Latootoo/ECSE_548/README.md

ECSE_548
========

ECSE 548 Final Project - Group 2

TO-DO
========
- <del>Add row wl buffers to sram array</del> DONE!
- <del>Build layout for cache</del> DONE!
- <del>Integrate with MIPS in layout</del> DONE!
- <del>Finish final report</del> DONE!
- <del>Finish presentation slides</del> DONE!
