Latootoo/ECSE_548/Reports/Final_Report/report.tex

%% bare_conf.tex
%% V1.3
%% 2007/01/11
%% by Michael Shell
%% See:
%% http://www.michaelshell.org/
%% for current contact information.
%%
%% This is a skeleton file demonstrating the use of IEEEtran.cls
%% (requires IEEEtran.cls version 1.7 or later) with an IEEE conference paper.
%%
%% Support sites:
%% http://www.michaelshell.org/tex/ieeetran/
%% http://www.ctan.org/tex-archive/macros/latex/contrib/IEEEtran/
%% and
%% http://www.ieee.org/

%%*************************************************************************
%% Legal Notice:
%% This code is offered as-is without any warranty either expressed or
%% implied; without even the implied warranty of MERCHANTABILITY or
%% FITNESS FOR A PARTICULAR PURPOSE! 
%% User assumes all risk.
%% In no event shall IEEE or any contributor to this code be liable for
%% any damages or losses, including, but not limited to, incidental,
%% consequential, or any other damages, resulting from the use or misuse
%% of any information contained here.
%%
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
% the amount of white space around the subfigures. subfigure.sty is already
% installed on most LaTeX systems. The latest version and documentation can
% be obtained at:
% http://www.ctan.org/tex-archive/obsolete/macros/latex/contrib/subfigure/
% subfigure.sty has been superceeded by subfig.sty.

%\usepackage[caption=false]{caption}
%\usepackage[font=footnotesize]{subfig}
% subfig.sty, also written by Steven Douglas Cochran, is the modern
% replacement for subfigure.sty. However, subfig.sty requires and
% automatically loads Axel Sommerfeldt's caption.sty which will override
% IEEEtran.cls handling of captions and this will result in nonIEEE style
% figure/table captions. To prevent this problem, be sure and preload
% caption.sty with its "caption=false" package option. This is will preserve
% IEEEtran.cls handing of captions. Version 1.3 (2005/06/28) and later 
% (recommended due to many improvements over 1.2) of subfig.sty supports
% the caption=false option directly:
%\usepackage[caption=false,font=footnotesize]{subfig}
%
% The latest version and documentation can be obtained at:
% http://www.ctan.org/tex-archive/macros/latex/contrib/subfig/
% The latest version and documentation of caption.sty can be obtained at:
% http://www.ctan.org/tex-archive/macros/latex/contrib/caption/

% *** FLOAT PACKAGES ***
%
%\usepackage{fixltx2e}
% fixltx2e, the successor to the earlier fix2col.sty, was written by
% Frank Mittelbach and David Carlisle. This package corrects a few problems
% in the LaTeX2e kernel, the most notable of which is that in current
% LaTeX2e releases, the ordering of single and double column floats is not
% guaranteed to be preserved. Thus, an unpatched LaTeX2e can allow a
% single column figure to be placed prior to an earlier double column
% figure. The latest version and documentation can be found at:
% http://www.ctan.org/tex-archive/macros/latex/base/

%\usepackage{stfloats}
% stfloats.sty was written by Sigitas Tolusis. This package gives LaTeX2e
% the ability to do double column floats at the bottom of the page as well
% as the top. (e.g., "\begin{figure*}[!b]" is not normally possible in
% LaTeX2e). It also provides a command:
%\fnbelowfloat
% to enable the placement of footnotes below bottom floats (the standard
% LaTeX2e kernel puts them above bottom floats). This is an invasive package
% which rewrites many portions of the LaTeX2e float routines. It may not work
% with other packages that modify the LaTeX2e float routines. The latest
% version and documentation can be obtained at:
% http://www.ctan.org/tex-archive/macros/latex/contrib/sttools/
% Documentation is contained in the stfloats.sty comments as well as in the
% presfull.pdf file. Do not use the stfloats baselinefloat ability as IEEE
% does not allow \baselineskip to stretch. Authors submitting work to the
% IEEE should note that IEEE rarely uses double column equations and
% that authors should try to avoid such use. Do not be tempted to use the
% cuted.sty or midfloat.sty packages (also by Sigitas Tolusis) as IEEE does
% not format its papers in such ways.

% *** PDF, URL AND HYPERLINK PACKAGES ***
%
%\usepackage{url}
% url.sty was written by Donald Arseneau. It provides better support for
% handling and breaking URLs. url.sty is already installed on most LaTeX
% systems. The latest version can be obtained at:
% http://www.ctan.org/tex-archive/macros/latex/contrib/misc/
% Read the url.sty source comments for usage information. Basically,
% \url{my_url_here}.

% *** Do not adjust lengths that control margins, column widths, etc. ***
% *** Do not use packages that alter fonts (such as pslatex).         ***
% There should be no need to do such things with IEEEtran.cls V1.6 and later.
% (Unless specifically asked to do so by the journal or conference you plan
% to submit to, of course. )

% correct bad hyphenation here
%\hyphenation{op-tical net-works semi-conduc-tor}

\begin{document}
%
% paper title
% can use linebreaks \\ within to get better formatting as desired
\title{ECSE 548 (VLSI) Project: MIPS Processor On-Chip Cache Design and Integration}
\author{Group 2}

% author names and affiliations
% use a multiple column layout for up to three different
% affiliations
%\author{\IEEEauthorblockN{Michael Shell}
%\IEEEauthorblockA{School of Electrical and\\Computer Engineering\\
%Georgia Institute of Technology\\
%Atlanta, Georgia 30332--0250\\
%Email: http://www.michaelshell.org/contact.html}
%\and
%\IEEEauthorblockN{Homer Simpson}
%\IEEEauthorblockA{Twentieth Century Fox\\
%Springfield, USA\\
%Email: homer@thesimpsons.com}
%\and
%\IEEEauthorblockN{James Kirk\\ and Montgomery Scott}
%\IEEEauthorblockA{Starfleet Academy\\
%San Francisco, California 96678-2391\\
%Telephone: (800) 555--1212\\
%Fax: (888) 555--1212}}

% conference papers do not typically use \thanks and this command
% is locked out in conference mode. If really needed, such as for
% the acknowledgment of grants, issue a \IEEEoverridecommandlockouts
% after \documentclass

% for over three affiliations, or if they all won't fit within the width
% of the page, use this alternative format:
% 
%\author{\IEEEauthorblockN{Michael Shell\IEEEauthorrefmark{1},
%Homer Simpson\IEEEauthorrefmark{2},
%James Kirk\IEEEauthorrefmark{3}, 
%Montgomery Scott\IEEEauthorrefmark{3} and
%Eldon Tyrell\IEEEauthorrefmark{4}}
%\IEEEauthorblockA{\IEEEauthorrefmark{1}School of Electrical and Computer Engineering\\
%Georgia Institute of Technology,
%Atlanta, Georgia 30332--0250\\ Email: see http://www.michaelshell.org/contact.html}
%\IEEEauthorblockA{\IEEEauthorrefmark{2}Twentieth Century Fox, Springfield, USA\\
%Email: homer@thesimpsons.com}
%\IEEEauthorblockA{\IEEEauthorrefmark{3}Starfleet Academy, San Francisco, California 96678-2391\\
%Telephone: (800) 555--1212, Fax: (888) 555--1212}
%\IEEEauthorblockA{\IEEEauthorrefmark{4}Tyrell Inc., 123 Replicant Street, Los Angeles, California 90210--4321}}

% use for special paper notices
%\IEEEspecialpapernotice{(Invited Paper)}

% make the title area
\maketitle

\begin{abstract}
%\boldmath
In this paper, we present an on-chip cache design and integration for 8-bit MIPS
processor. The cache that we adopt is a direct-mapped cache with 1 byte cache
blocks. It has a size of 16 bytes and is used for both instructions and data. We
apply a top-down design methodology, i.e. we start from the architecture level
and go down to its layout, with testing on each level. To integrate the cache,
	MIPS Finite State Machine (FSM) is modified accordingly, which results in
	controller architecture modifications. Assembly code is also rewritten to test
	cache functionality by SystemVerilog simulation. Upon completing functionality verification, cache components are implemented and integrated in Electric, and then their testing methodology is explained in detail. In addition, design quality is tested using SPICE simulations.
\end{abstract}
% IEEEtran.cls defaults to using nonbold math in the Abstract.
% This preserves the distinction between vectors and scalars. However,
% if the conference you are submitting to favors bold math in the abstract,
% then you can use LaTeX's standard command \boldmath at the very start
% of the abstract to achieve this. Many IEEE journals/conferences frown on
% math in the abstract anyway.

% no keywords

% For peer review papers, you can put extra information on the cover
% page as needed:
% \ifCLASSOPTIONpeerreview
% \begin{center} \bfseries EDICS Category: 3-BBND \end{center}
% \fi
%
% For peerreview papers, this IEEEtran command inserts a page break and
% creates the second title. It will be ignored for other modes.
\IEEEpeerreviewmaketitle

\section{Introduction}

Cache is a small memory that is used to speed up the processor memory-related operation. Due to \textbf{Locality of Reference}, where a process at any given time accesses only a small region of memory, a cache helps significantly reduce processor I/O overhead by loading the small region that can be accessed by the processor with a much faster rate. For example, the typical memory access time of 60 ns of a Pentium processor can be reduced to 15 ns with the presence of a cache \cite{intel}. Usually data from memory as placed using \textit{modulo placement} policy, but other policies can also be applied, such as \textit{random placement} proposed in \cite{random_place}.

According to cache replacement policies, they can be classified as direct-mapped cache, set-associative cache, fully-associative cache, random cache \cite{random_replace} etc. In this paper, we propose a design for a simple direct-mapped cache for MIPS processor using SRAM memory elements. The paper is organized as follows. Section \ref{cache_arch} and Section \ref{arch} provides detailed descriptions of proposed design for cache architecture and modifications on the existing MIPS processor for the integration between the two parts; then Section \ref{implementation} presents the process of implementing the design. In Sections \ref{testing} and \ref{quality}, both functional and performance testing on the design is discussed. Section \ref{conclusion} concludes the design process.

%
% no \IEEEPARstart
% You must have at least 2 lines in the paragraph with the drop letter
% (should never be an issue)

%\hfill mds
% 
%\hfill January 11, 2007

% An example of a floating figure using the graphicx package.
% Note that \label must occur AFTER (or within) \caption.
% For figures, \caption should occur after the \includegraphics.
% Note that IEEEtran v1.7 and later has special internal code that
% is designed to preserve the operation of \label within \caption
% even when the captionsoff option is in effect. However, because
% of issues like this, it may be the safest practice to put all your
% \label just after \caption rather than within \caption{}.
%
% Reminder: the "draftcls" or "draftclsnofoot", not "draft", class
% option should be used if it is desired that the figures are to be
% displayed while in draft mode.
%
%\begin{figure}[!t]
%\centering
%\includegraphics[width=2.5in]{myfigure}
% where an .eps filename suffix will be assumed under latex, 
% and a .pdf suffix will be assumed for pdflatex; or what has been declared
% via \DeclareGraphicsExtensions.
%\caption{Simulation Results}
%\label{fig_sim}
%\end{figure}

% Note that IEEE typically puts floats only at the top, even when this
% results in a large percentage of a column being occupied by floats.

% An example of a double column floating figure using two subfigures.
% (The subfig.sty package must be loaded for this to work.)
% The subfigure \label commands are set within each subfloat command, the
% \label for the overall figure must come after \caption.
% \hfil must be used as a separator to get equal spacing.
% The subfigure.sty package works much the same way, except \subfigure is
% used instead of \subfloat.
%
%\begin{figure*}[!t]
%\centerline{\subfloat[Case I]\includegraphics[width=2.5in]{subfigcase1}%
%\label{fig_first_case}}
%\hfil
%\subfloat[Case II]{\includegraphics[width=2.5in]{subfigcase2}%
%\label{fig_second_case}}}
%\caption{Simulation results}
%\label{fig_sim}
%\end{figure*}
%
% Note that often IEEE papers with subfigures do not employ subfigure
% captions (using the optional argument to \subfloat), but instead will
% reference/describe all of them (a), (b), etc., within the main caption.

% An example of a floating table. Note that, for IEEE style tables, the 
% \caption command should come BEFORE the table. Table text will default to
% \footnotesize as IEEE normally uses this smaller font for tables.
% The \label must come after \caption as always.
%
%\begin{table}[!t]
%% increase table row spacing, adjust to taste
%\renewcommand{\arraystretch}{1.3}
% if using array.sty, it might be a good idea to tweak the value of
% \extrarowheight as needed to properly center the text within the cells
%\caption{An Example of a Table}
%\label{table_example}
%\centering
%% Some packages, such as MDW tools, offer better commands for making tables
%% than the plain LaTeX2e tabular which is used here.
%\begin{tabular}{|c||c|}
%\hline
%One & Two\\
%\hline
%Three & Four\\
%\hline
%\end{tabular}
%\end{table}

% Note that IEEE does not put floats in the very first column - or typically
% anywhere on the first page for that matter. Also, in-text middle ("here")
% positioning is not used. Most IEEE journals/conferences use top floats
% exclusively. Note that, LaTeX2e, unlike IEEE journals/conferences, places
% footnotes above bottom floats. This can be corrected via the \fnbelowfloat
% command of the stfloats package.

\section{Cache Architecture}\label{cache_arch}
The MIPS processor presented in the course takes an 8-bit address line and 8-bit data line every time it reads data from external memory; to maintain a manageable project scale while ensuring basic functionality of the cache, the cache was designed to split up the address line into a 4-bit tag line and a 4-bit set line, where set signals are used for row selection in cache whereas tag signals are used for comparison to generate cache hits. The designed configuration results in a 16 8-bit data row in cache, making it capable of storing 16 bytes (4 distinctive assembly instructions) for MIPS.

The resulting design of the cache is shown in Figure \ref{fig:cache_arch}. Set signals are used to decode data rows inside SRAM arrays, and tag signals are used to compare the tags stored in cache to generate cache hit signals. Write enable (\textit{we} as shown in figure) signal ensures the cache is writeable whenever it set to high. Additionally, for better stability, a validation bit (\textit{v}) was added to each row of SRAM array inside the cache to implement \textit{Compulsory Miss Strategy}, where the first read from cache is always guaranteed to generate a cache miss signal.

\begin{figure}[h!]
  \centering
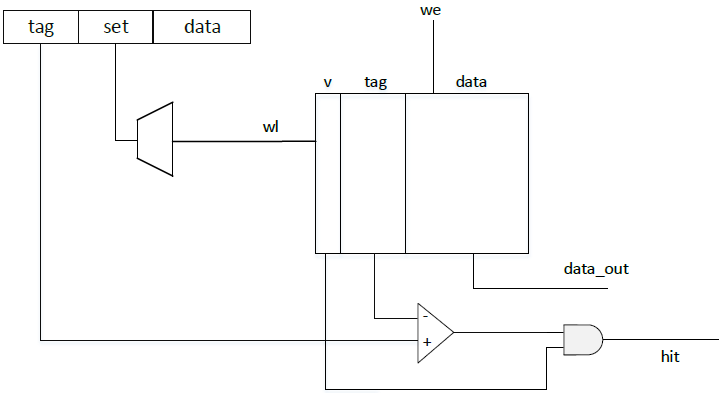
[picture p1: Reports/Final_Report/cache_arch.png]
    
  \caption{Cache Microarchitecture}
  \label{fig:cache_arch}
\end{figure}

\section{MIPS Integration Architecture}\label{arch}
Since our cache is used for both instructions and data, in following sections,
	  when we say data from memory, we refer to both instructions and data unless specified
	  otherwise.
	  
\subsection{Modified FSM}

\begin{figure}[h!]
  \centering
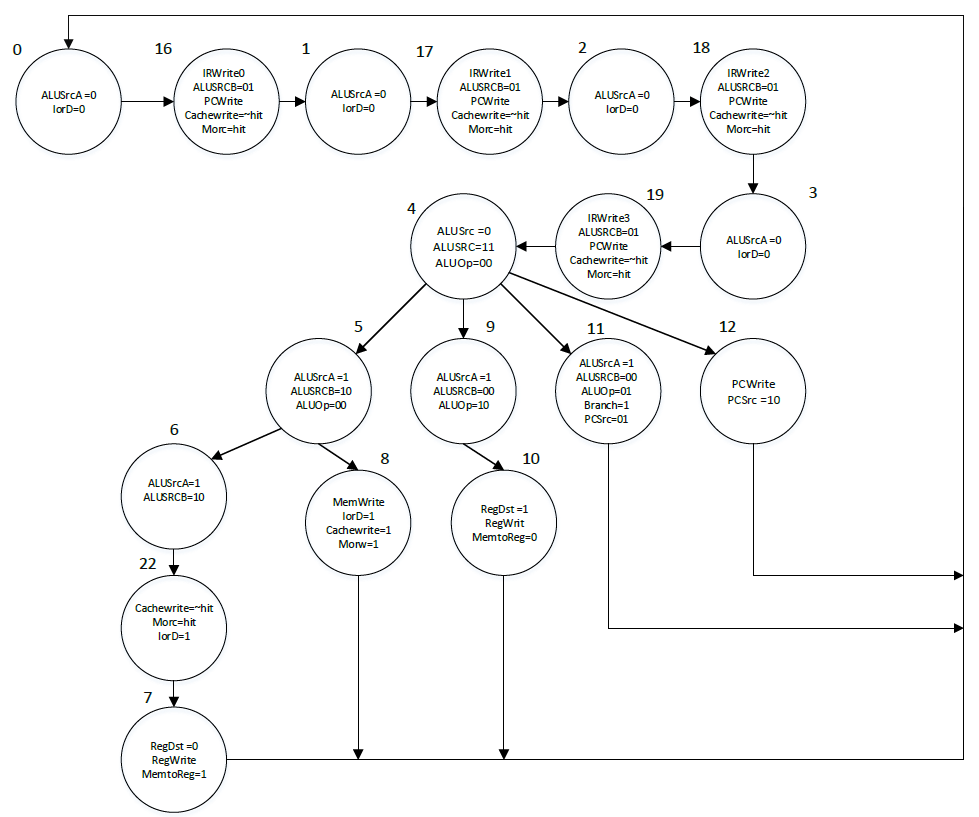
[picture p2: Reports/Final_Report/fsm.png]
    
  \caption{Modified FSM of Controller}
  \label{fig:fsm}
\end{figure}

We adopt hierarchical top-down design methodology. We go through architecture
level, schematic level and layout level. At architecture level, the Finite
State Machine (FSM) is modified and the controller is changed accordingly, see
Figure \ref{fig:fsm}. This is implemented in SystemVerilog and the functional simulation has
been verified successfully before going down to schematic level.

In Figure \ref{fig:fsm}, the modified FSM is similar to the original MIPS processor FSM. But in order to integrate our on-chip cache into the processor, we added some states for cache accesses and some signals to control additional multiplexers.

In total, we added 5 states. Previously, there are 13 states, i.e. from state 0 to state 12. We added an extra state bit and make it 5-bit FSM. The states we added are state 16 to state 19, and state 22 for cache read access. Besides, we modified state 8 for cache write access.

State 16 to state 19 are added for instruction fetch. Take state 0 as an example. Instead of fetching off-chip memory directly, first it checks the status of the cache at state 0. Then it goes to state 16. If there is a cache hit, the multiplexer selects instruction from cache and puts it into instruction register. Otherwise it reads the instruction from off-chip memory and at the same time, \textit{cachewrite} signal is enabled and corresponding multiplexer select signal is set to store the instruction to the cache simultaneously. 

For state 6, it reads data instead of instruction. It works in a similar way as it does for an instruction fetch. First it checks cache status at state 6 and then it reads data at state 22. Apart from \textit{cachewrite} signal and multiplexer select signal, the signal \textit{IorD} is set to 1 to read data.

For state 8, this is a memory write access. For memory write access, we still use only 1 state instead of 2. This is because we have chosen write-through policy for cache, which means whenever a write access happens, the data is written back to both cache and off-chip memory simultaneously. Therefore there is no need to add an extra state. To write data into cache, we need to enable \textit{cachewrite} signal and select the data from datapath using the multiplexer. 

\subsection{MIPS Microarchitecture}
\begin{figure}[h!]
  \centering
    
  \caption{MIPS Microarchitecture}
  \label{fig:arch}
\end{figure}

The MIPS microarchitecture with on-chip cache is shown in Figure~\ref{fig:arch}. In Figure \ref{fig:arch}, we can see that our cache is integrated. To make it work. two additional multiplexers are added. Besides, three output signals (\textit{cachewrite, morw, morc}) and one input signal
(\textit{hit}) are added to the controller due to modified FSM, and they are explained as follows: 

\begin{itemize}
\item\textit{cachewrite} is used to
enable write/read access to the cache with a value of 1/0. 

\item\textit{morw} is used
to select data from memory or datapath. For a read access, if a cache miss happens, it is set
to 0 and the data from memory is written into the cache. For a write access, it is set to 1 to send the datapath data to cache.

\item\textit{morc} is used to select data from memory or from cache. If there is a
cache hit, it is set to 1 and the data from cache is sent to MIPS. Otherwise it
is set to 0 and memory data is used.

\item\textit{hit} is used to show status of cache. 1 represents a cache hit and
0 represents a cache miss. A compulsory miss strategy was implemented for an ensured miss for a first-time read from cache.
\end{itemize}

\section{Implementaion}\label{implementation}
This section discusses the implementation process of cache components and integration in Electric.
\subsection{Comparator}\label{subsec:comparator}
A 4-bit comparator was implemented to compare the \textit{tag} bits from the memory and cache to generate corresponding \textit{cache hit} signals. The designed schematic and layout can be found in Figure \ref{fig:comparator}.
\begin{figure}[h!]
  \centering
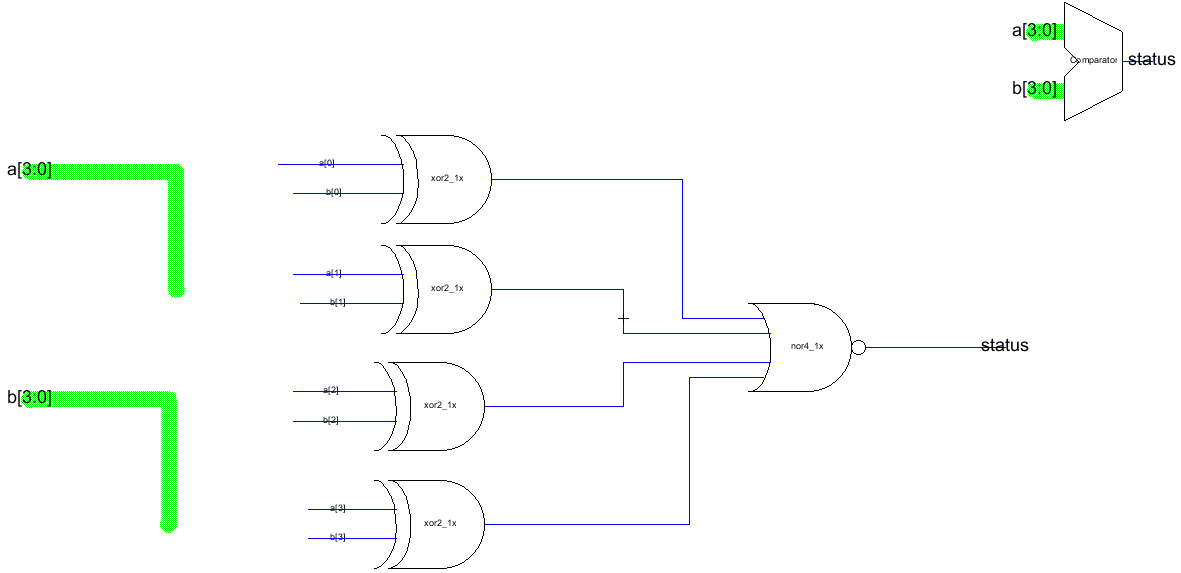
[picture p3: Reports/Final_Report/comparator_sch.png]
     
  \caption{The Schematic and Layout of Comparator Design}
  \label{fig:comparator}
\end{figure}

Figure \ref{fig:comparator_check} indicates that the comparator design was valid, passing all three design rule checks.
\begin{figure}[h!]
  \centering
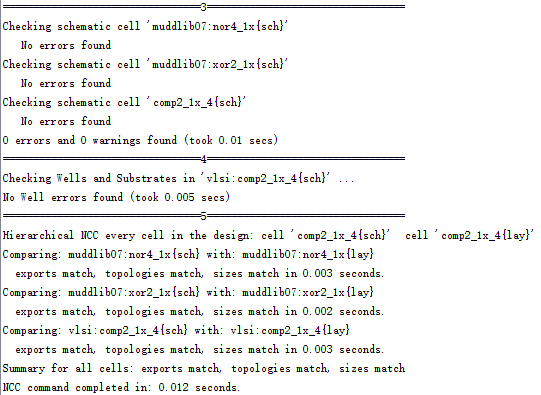
[picture p4: Reports/Final_Report/comparator_check.png]
    
  \caption{Deisgn Rule Checks for Comparator}
  \label{fig:comparator_check}
\end{figure}

\subsection{4-to-16 Row Decoder}\label{subsec:decoder}
In order for the cache to make use of the 4-bit set signals, a row decoder was applied to decode the set signal and select 1 out of 16 8-bit data lines lying inside the cache. In order to reduce the delay and space usage of the decoder, \textit{pre-decoding} technology was used, resulting in a design shown in Figure \ref{fig:decoder}. It was worth noting that the layout of the decoder was deliberately designed to be wide with a minimum height in order to pitch-match with the SRAM array inside the cache.
\begin{figure}[h!]
  \centering
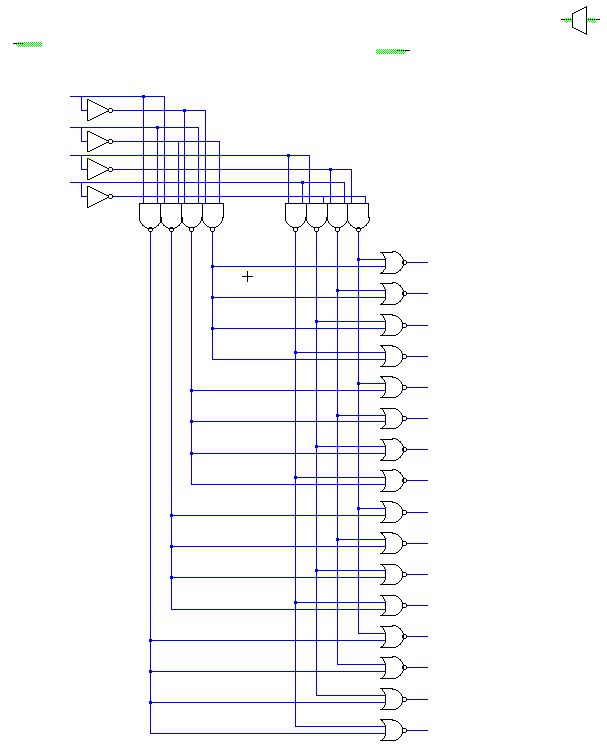
[picture p5: Reports/Final_Report/decoder_sch.png]
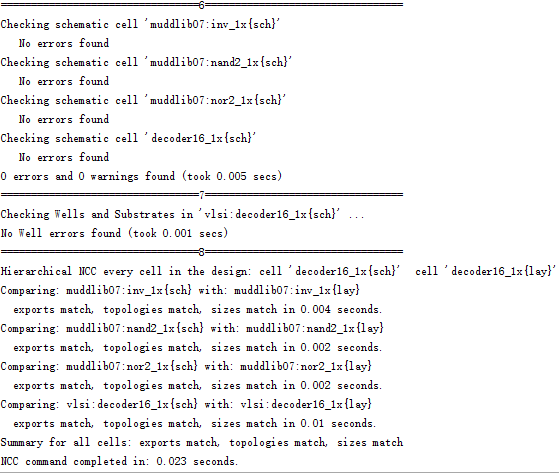
[picture p6: Reports/Final_Report/decoder_check.png]
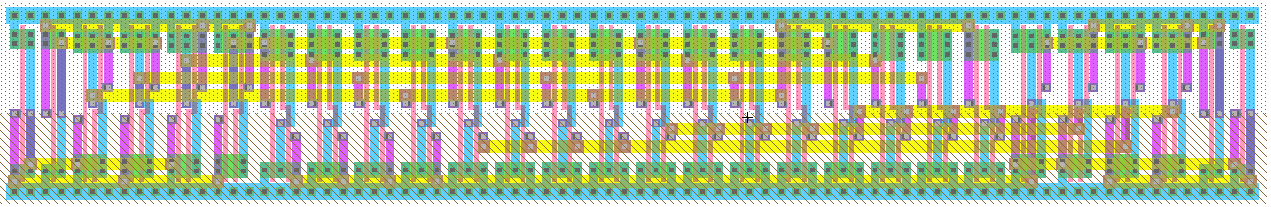
[picture p7: Reports/Final_Report/decoder_lay.png]
      
  \caption{The Schematic and Layout of Decoder Design With Design Rule Check Results}
  \label{fig:decoder}
\end{figure}

It can be shown from the Figure \ref{fig:decoder} that the decoder design passed all three design rule checks and was ready for the integration into the cache deisgn.

\subsection{SRAM Column}\label{subsec:sram_col}
An SRAM column represents a column of SRAM bits inside the SRAM array of the cache, consisting of 16 SRAM bits sharing bit and inverting bit lines. The design was presented in Figure \ref{fig:sram_col}.

\begin{figure}[h!]
  \centering
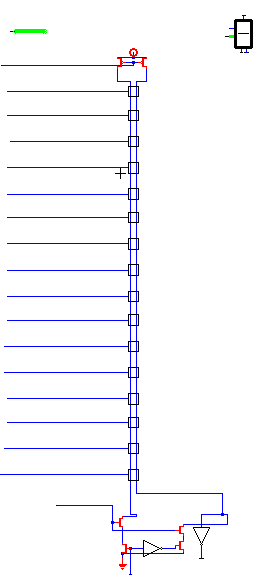
[picture p8: Reports/Final_Report/sram_col_sch.png]
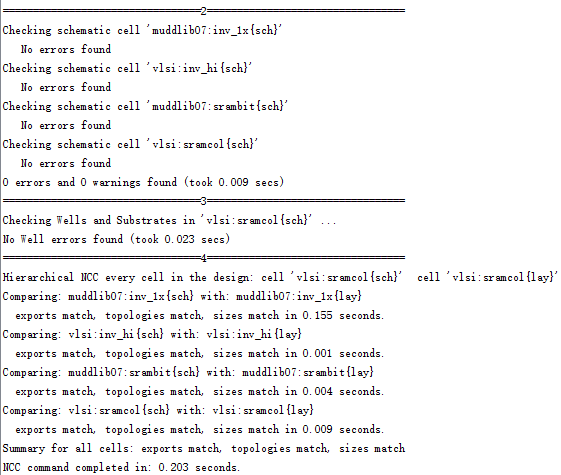
[picture p9: Reports/Final_Report/sram_col_check.png]
      
  \caption{The Schematic and Layout of SRAM Column With Design Rule Check Results}
  \label{fig:sram_col}
\end{figure}

The design rule check results can be found in Figure \ref{fig:sram_col}. It can be shown from the Figure that all three of the design rule requirements were satisfied by the design.

\subsection{SRAM Array}\label{subsec:sram}
The SRAM array is the most essential part of the cache, consisting of 16 \textit{13-bit} SRAM bit rows, with each row having 1 bit for validation (compulsory miss), 4 bits for tag line and 8 bits for data storage. Each row also has a wordline buffer for a stable charging-up. The design is presented in Figure \ref{fig:sram}; the design rule check results can be found in the same figure as well.

\begin{figure}[h!]
  \centering
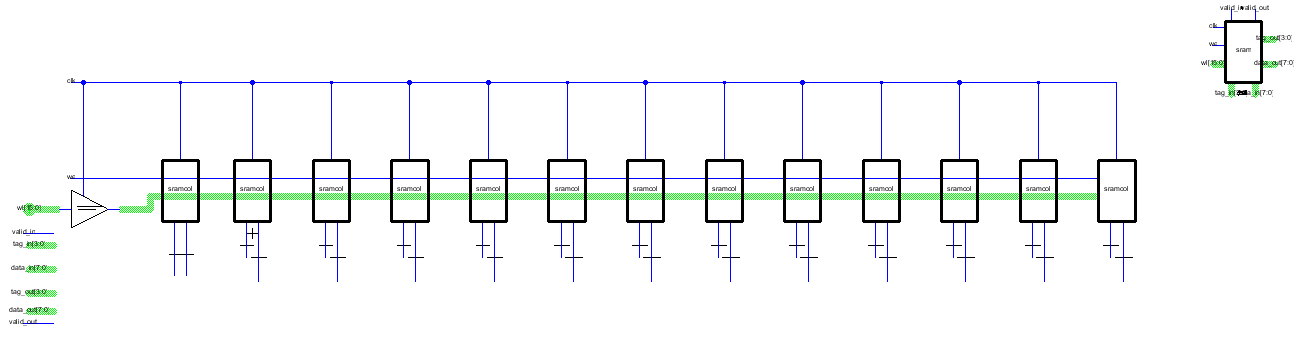
[picture p10: Reports/Final_Report/sram_sch.png]
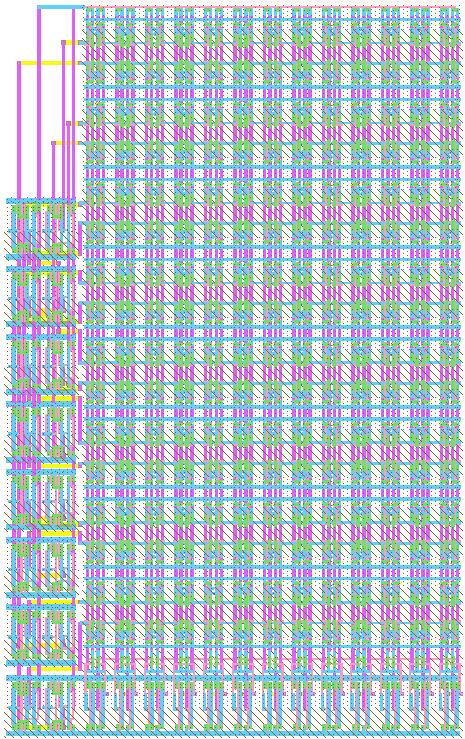
[picture p11: Reports/Final_Report/sram_lay.png]
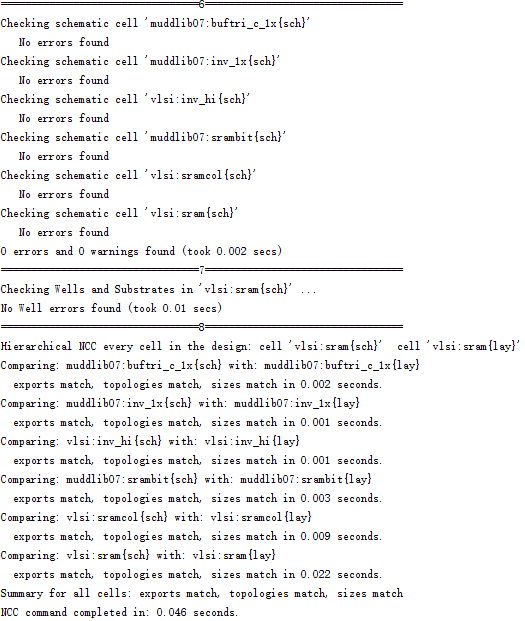
[picture p12: Reports/Final_Report/sram_check.png]
      
  \caption{The Schematic and Layout of SRAM Array With Design Rule Check Results}
  \label{fig:sram}
\end{figure}

\subsection{Cache}\label{subsec:cache}
After the implementation of all circuit components, the cache was built based on the microarchitecture of the proposed cache circuit design. For easy integrations with the MIPS processor, in the layout, universal \textit{vdd} and \textit{gnd} tracks were added that connects \textit{vdd} and \textit{gnd} of sub-components together. The cache circuit design, along with the evidence that it passes all three design checks, is presented in Figure \ref{fig:cache}.

\begin{figure}[h!]
  \centering
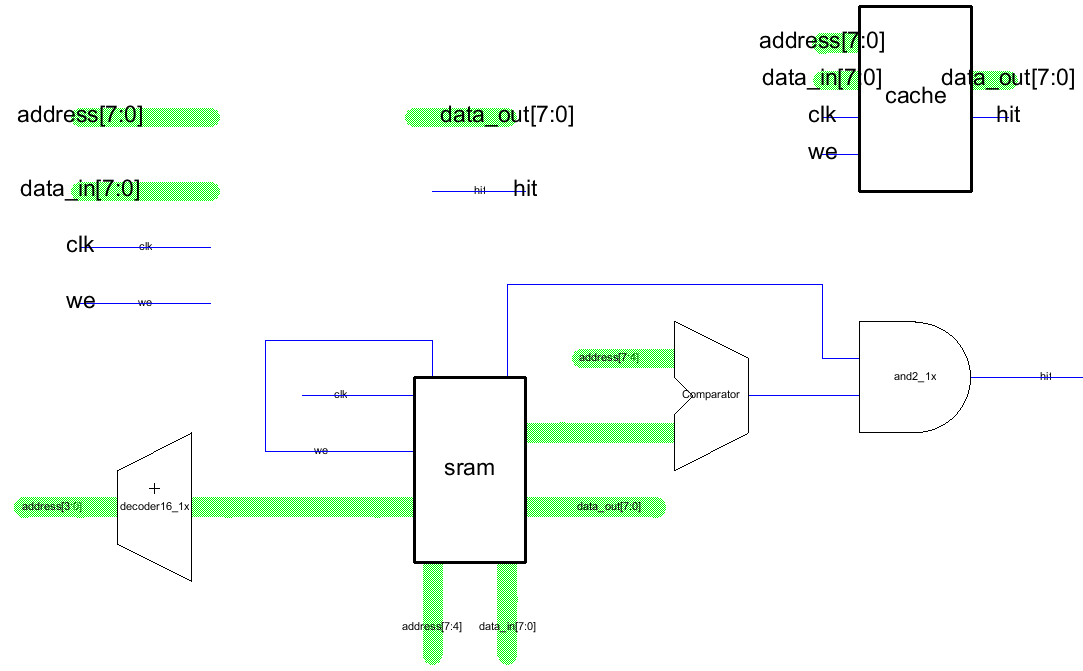
[picture p13: Reports/Final_Report/cache_sch.png]
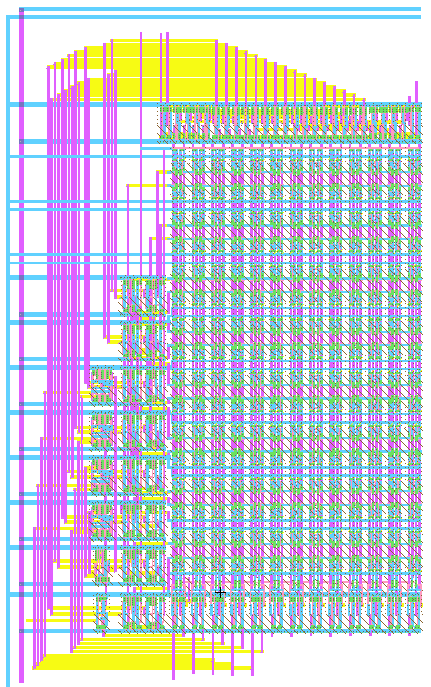
[picture p14: Reports/Final_Report/cache_lay.png]
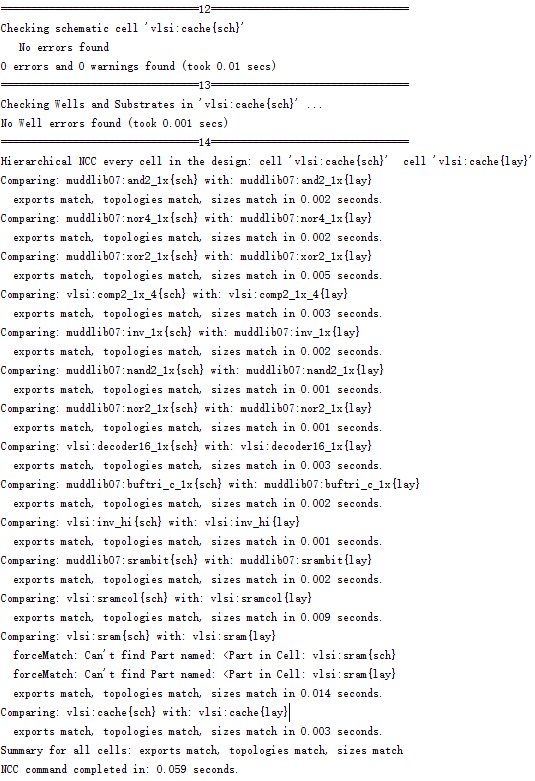
[picture p15: Reports/Final_Report/cache_check.png]
      
  \caption{The Schematic and Layout of Cache With Design Rule Check Results}
  \label{fig:cache}
\end{figure}

\subsection{PLA Controller \& Controller}\label{subsec:controller}
As indicated in Section \ref{arch}, with updated FSM for the controller, the PLA controller which represents the FSM logic has been modified accordingly. With an updated FSM description file, a new PLA controller was generated and re-integrated into the controller circuit of MIPS processor. New exports corresponding to cache signals have been added to the controller circuit as well. The resulting circuit is presented in the next sub-section.

\subsection{Integration}\label{subsec:integration}
Upon the completion and tests of each component, the cache was then integrated with MIPS processor (with updated controller component), resulting in a circuit presented in Figure \ref{fig:mips}.

\begin{figure}[h!]
  \centering
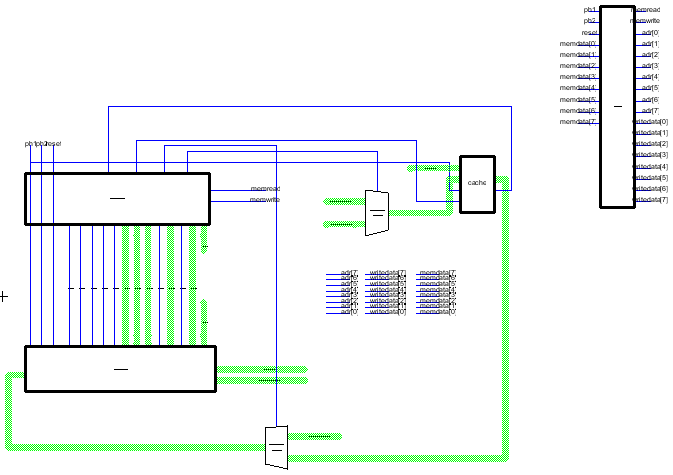
[picture p16: Reports/Final_Report/mips_sch.png]
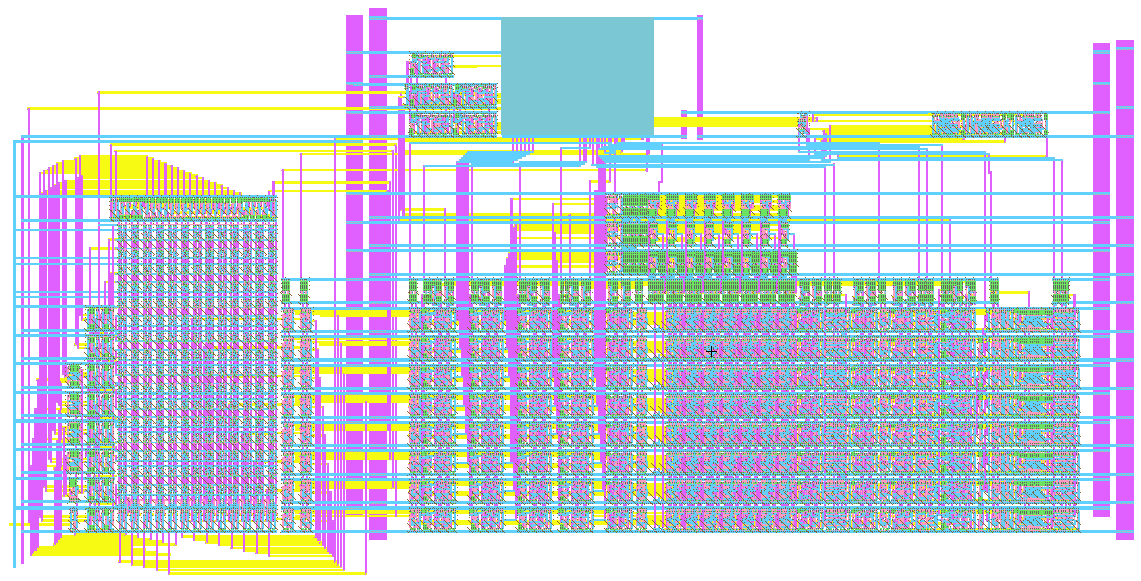
[picture p17: Reports/Final_Report/mips_lay.png]
     
  \caption{The Schematic and Layout of MIPS integrated with Cache}
  \label{fig:mips}
\end{figure}

The pad frame was then generated from the new MIPS processor with cache implemented. To contain the much-expanded size of the MIPS, the size of the pad frame was extended from \textit{40} pads to \textit{64} pads. The resulting chip, along with error-free design rule check results, is shown in Figure \ref{fig:chip}. Due to page limits, a truncated version of design rule checks for the chip is presented in this paper; the full check has been presented during the demo with the professor.

\begin{figure}[h!]
  \centering
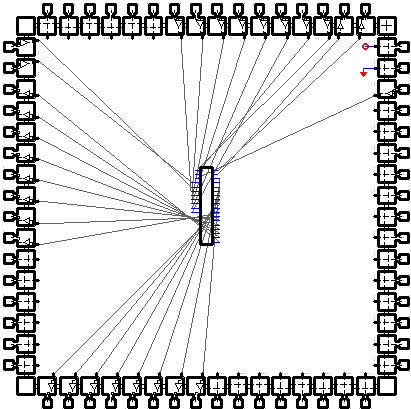
[picture p18: Reports/Final_Report/chip_sch.png]
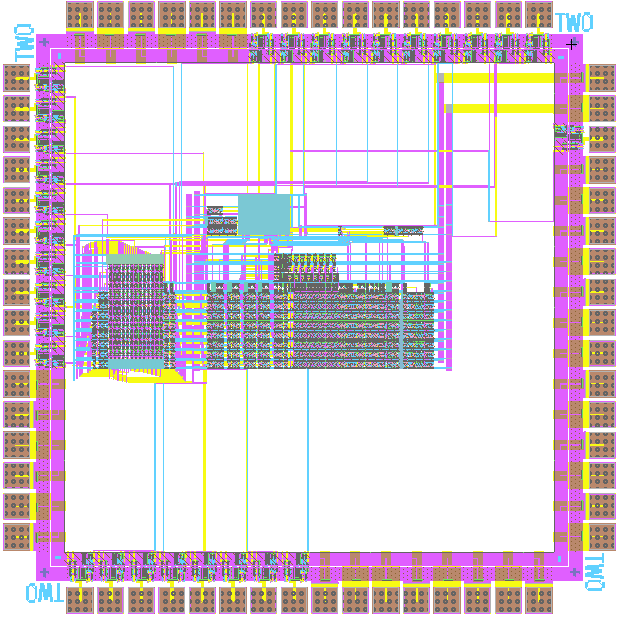
[picture p19: Reports/Final_Report/chip_lay.png]
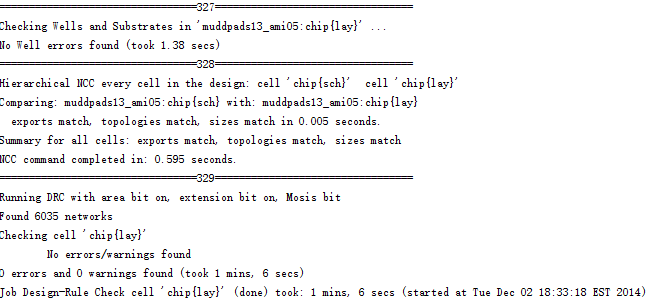
[picture p20: Reports/Final_Report/chip_check.png]
      
  \caption{The Schematic and Layout of Chip Integration With Design Rule Check Results}
  \label{fig:chip}
\end{figure}

\section{Testing}\label{testing}
In this section, we explain our testing methodology. We tested components
individually in Section \ref{subsec:comp_test}. After assembly, the SystemVerilog MIPS
processor is simulated for functional testing in Section \ref{subsec:func_test}.

\subsection{Components Testing}\label{subsec:comp_test}
The main components to be tested are shown below:
\begin{itemize}
\item Comparator \\

The comparator was tested in ModelSim with 7 test cases; Figure \ref{fig:comp_test} indicates that the comparator was able to operate correctly, passing all test cases.

\begin{figure}[h!]
  \centering
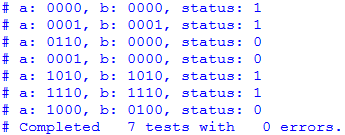
[picture p21: Reports/Final_Report/comp_test.png]
    
  \caption{ModelSim Test Results for Comparator}
  \label{fig:comp_test}
\end{figure}

\item Decoder \\
The 4-to-16 decoder was tested in ModelSim with all 16 test cases; the results showing that the design was operating properly is presented in Figure \ref{fig:decoder_test}.

\begin{figure}[h!]
  \centering
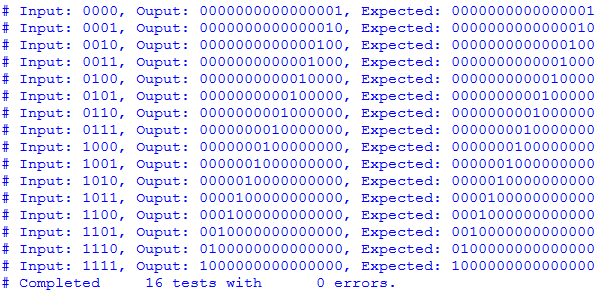
[picture p22: Reports/Final_Report/decoder_test.png]
    
  \caption{ModelSim Test Results for decoder}
  \label{fig:decoder_test}
\end{figure}
 
\item SRAM \\

This is the storage elements in cache. As shown in Figure \ref{fig:cache_arch}, it has 16 sets and each set consists of 1 \textit{valid} bit, 4 \textit{tag} bits and 8 \textit{data} bits. The input signal \textit{we} is set to 0/1 for data read/write and the signal \textit{wl} is used to select the set for access. Initially, the \textit{valid} bit is 0. Once a cache set is written, its corresponding \textit{valid} becomes 1. \textit{valid} is used to indicate if the data has been loaded or not. We produce some random inputs for testing. Due to the complexity of memory accesses, we generate test vectors from the inputs using our \textit{Python} script, as shown in Figure \ref{fig:sram_test}. The signal representation is listed in Table \ref{table:sram}. The functionality of SRAM is verified successfully according to test vectors.

\begin{figure}[h!]
  \centering
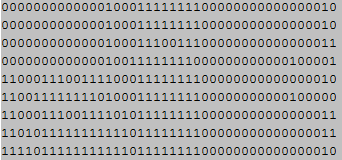
[picture p23: Reports/Final_Report/sram_test.png]
    
  \caption{SRAM Test Vectors}
  \label{fig:sram_test}
\end{figure}

\begin{table}[h]
\centering
\caption{SRAM Test Vector Representation}
\label{table:sram}
\begin{tabular}{c|c}
  \hline
  \textbf{bit position} & \textbf{signal}\\  
  \hline
  0 & we\\
  16:1 & wl \\
  24:17 & data\_in\\
  28:25 & tag\_in\\
  36:29 & expected\_data\\
  40:37 & expected\_tag\\
  41 & expected\_valid\\
  \hline
\end{tabular}
\end{table}

\end{itemize}

\subsection{Functional Testing}\label{subsec:func_test}
In this section, the functional testing of MIPS SystemVerilog model is
demonstrated. For this purpose, assembly code is written, as shown in Listing
\ref{lst:asm}. The assembly code load data from off-chip main memory, and some arithmetic manipulations are done. Then the result is written back to the main memory.

\lstinputlisting[caption=Assembly Code, label=lst:asm]{test.s}
At the beginning, instructions are fetched, and there are compulsory cache misses. The assembly code contains a loop to test cache hits. When dealing with this loop, there are cache hits. In Figure \ref{fig:cache_miss}, we can see that there is a cache miss. This happens because the instructions are used for the first time here. During program execution, cache hits occur for the loop. This is illustrated in Figure \ref{fig:cache_hit}. The instructions in the loop are put in the cache and then fetched soon. As a result, cache hits happen here.

Apart from cache read access, we also checked cache write access, as shown in Figure \ref{fig:cache_write}. In this case, signal \textit{morw} is set to 1 to select data and \textit{cachewrite} is set to 1 to write the data from datapath into cache.

\begin{figure}[h!]
  \centering
    
  \caption{Cache Read Miss}
  \label{fig:cache_miss}
\end{figure}

\begin{figure}[h!]
  \centering
    
  \caption{Cache Read Hit}
  \label{fig:cache_hit}
\end{figure}

\begin{figure}[h!]
  \centering
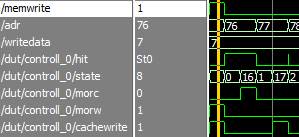
[picture p24: Reports/Final_Report/cache_write.png]
    
  \caption{Cache Write}
  \label{fig:cache_write}
\end{figure}

The functionality verification result is shown in Figure \ref{fig:cache_write}. If cache is absent, the write address \textit{adr} is 76 and write data \textit{writedata} is 7. After we integrated on-chip cache, the result is still correct. Our cache functionality is thus verified.

\section{Design Quality}\label{quality}
 
% power: and=> 1.89E-05  WATTS
%        inv=> 2.22E-05  WATTS
%		 hi-inv=>  1.27E-05  WATTS

In this section, performances of certain components, such as regular inverter, high-skew inverter as well as and gate, are evaluated using CAD tool(i.e.PSPICE) since we are not capable to perform evaluations directly on integrated circuits blocks due to the circuit size limitation from CAD tool. The corresponding results are shown in Figure \ref{fig:Spice} for the setup time analysis of each component respectively. As can be seen clearly from the output waveform, the high-skew inverter pulls up faster than the regular inverter as expected. As for the power dissipation, the corresponding total power consumption of a and gate, inverter and high-skew inverter are $18.9\mu W$, $22.2\mu W$ and $12.7\mu W$, respectively. Therefore, skewed logic is clearly one of the high performance and low power-carry logic components available currently.

\begin{figure}[h!]
  \centering
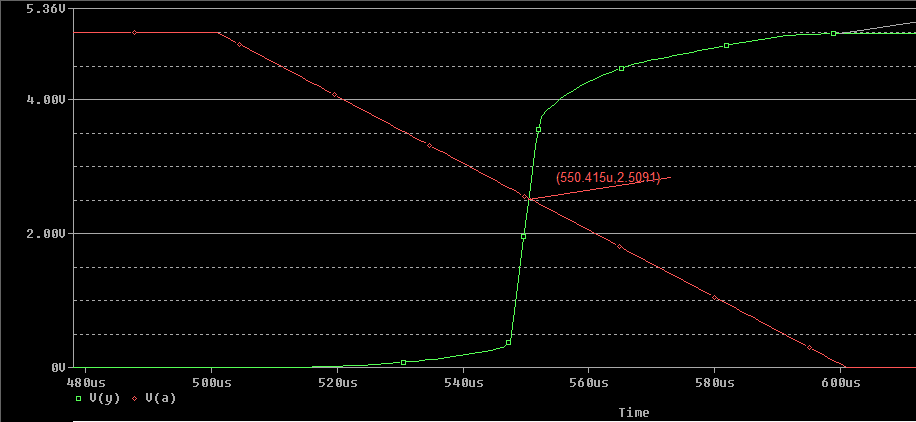
[picture p25: Reports/Final_Report/inv.png]
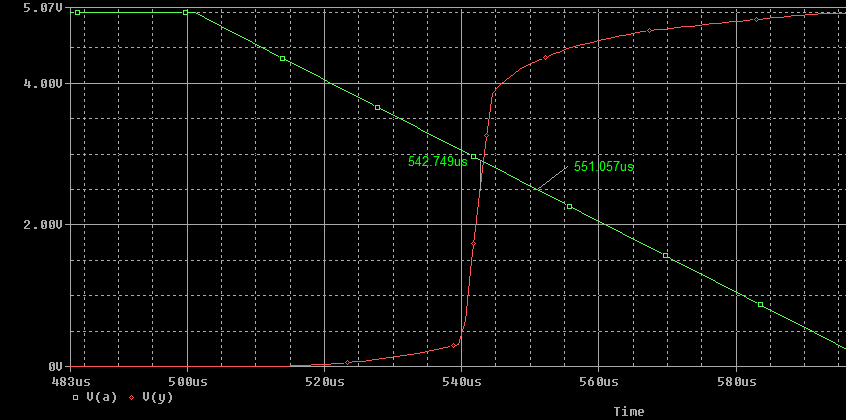
[picture p26: Reports/Final_Report/hi.png]
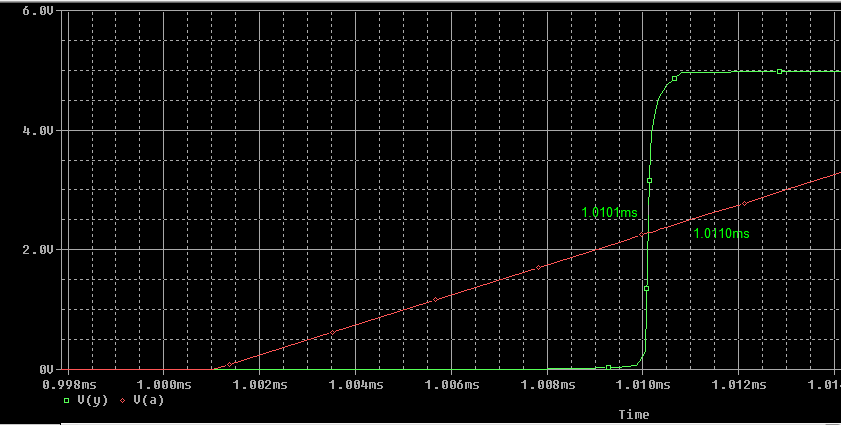
[picture p27: Reports/Final_Report/and.png]
      
  \caption{SPICE simulation of INV, high-skew INV and AND gate}
  \label{fig:Spice}
\end{figure}

\section{Conclusion}\label{conclusion}
Cache can be implemented in a number of ways. By using different placement and replacement policies, there are different access time and design complexities. In this paper, we successfully designed a direct-mapped cache--which is simple but demonstrates working principles of a cache--for an 8-bit MIPS processor. It is then implemented as schematic and layout respectively in Electric, and DRC, ERC and NCC tests all passed. In addition, we integrated the cache into the processor by modifying the controller FSM and verified the functionality by SystemVerilog testbench in ModelSim. Finally, we employed SPICE simulation for design quality test. Thus we have finished the project successfully by applying our knowledge from VLSI course and processor cache.

% conference papers do not normally have an appendix

% use section* for acknowledgement
%\section*{Acknowledgment}
%
%
%The authors would like to thank...

% trigger a \newpage just before the given reference
% number - used to balance the columns on the last page
% adjust value as needed - may need to be readjusted if
% the document is modified later
%\IEEEtriggeratref{8}
% The "triggered" command can be changed if desired:
%\IEEEtriggercmd{\enlargethispage{-5in}}

% references section

% can use a bibliography generated by BibTeX as a .bbl file
% BibTeX documentation can be easily obtained at:
% http://www.ctan.org/tex-archive/biblio/bibtex/contrib/doc/
% The IEEEtran BibTeX style support page is at:
% http://www.michaelshell.org/tex/ieeetran/bibtex/
%\bibliographystyle{IEEEtran}
% argument is your BibTeX string definitions and bibliography database(s)
%\bibliography{IEEEabrv,../bib/paper}
%
% <OR> manually copy in the resultant .bbl file
% set second argument of \begin to the number of references
% (used to reserve space for the reference number labels box)
\begin{thebibliography}{1}

\bibitem{intel}http://download.intel.com/design/intarch/papers/cache6.pdf

\bibitem{random_place}Kosmidis L, Abella J, Qui˜nones E, Cazorla FJ (2013a) A cache design for probabilistically
analysable real-time systems. In: Proceedings of the Conference on Design, Automation
and Test in Europe, EDA Consortium, San Jose, CA, USA, DATE ’13, pp 513–518, URL
http://dl.acm.org/citation.cfm?id=2485288.2485416

\bibitem{random_replace}Quinones E, Berger E, Bernat G, Cazorla F (2009) Using randomized caches in probabilistic
real-time systems. In: Real-Time Systems, 2009. ECRTS ’09. 21st Euromicro Conference
on, pp 129–138, DOI 10.1109/ECRTS.2009.30

\end{thebibliography}

% that's all folks
\end{document}
