Latootoo/ECSE_548/Reports/Final_Report/cache_arch.pdf

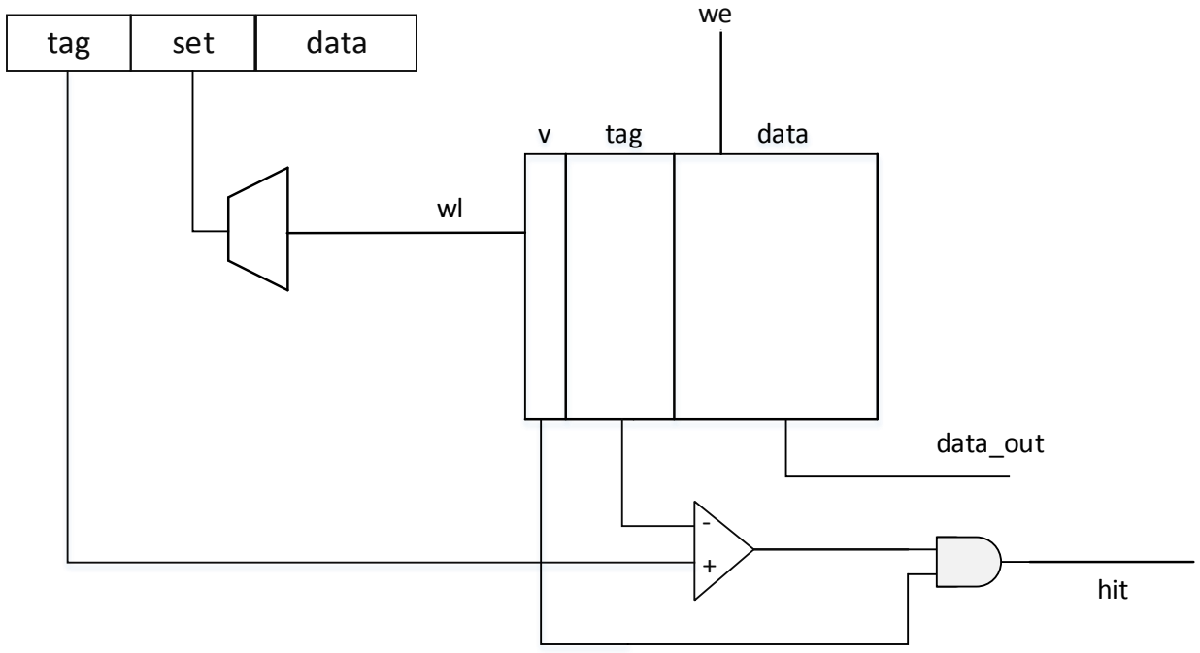
[picture p40: figure]
data_out; tag; data; hit; set
