Latootoo/ECSE_548/Reports/Final_Report/arch.pdf

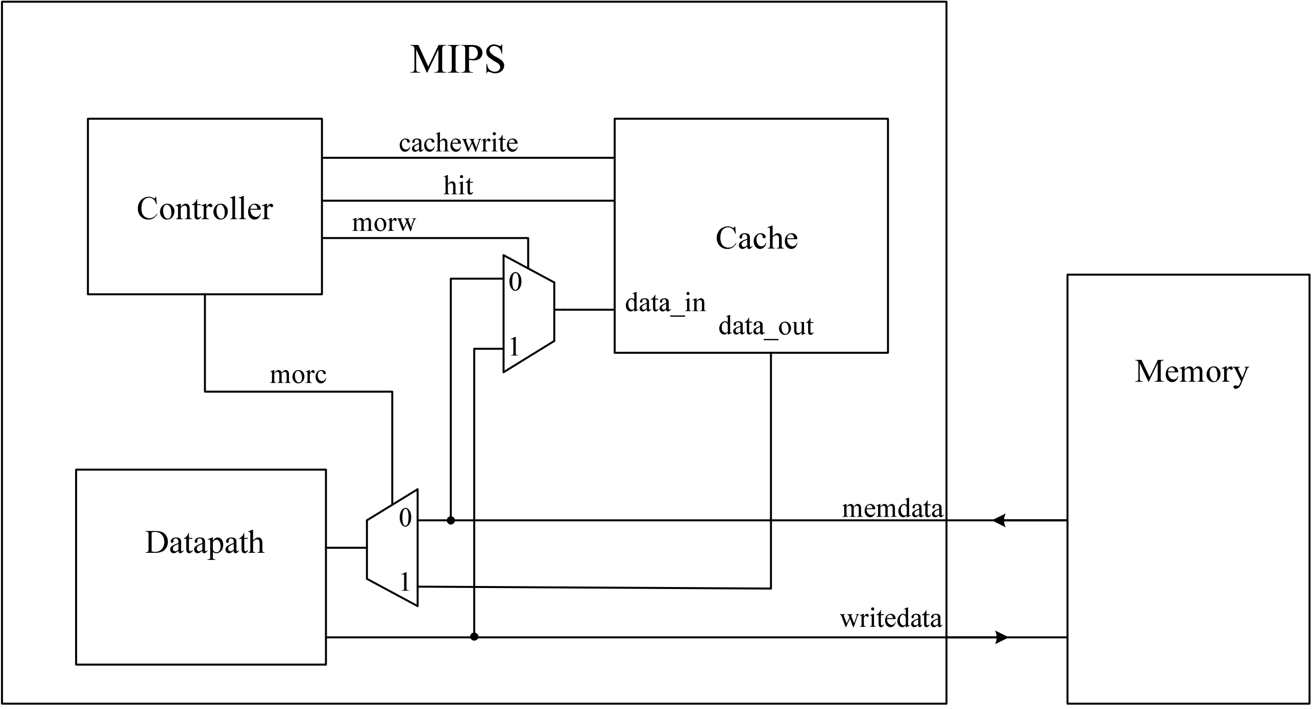
[picture p41: figure]
