Latootoo/ECSE_548/Reports/Final_Report/pla_case.png

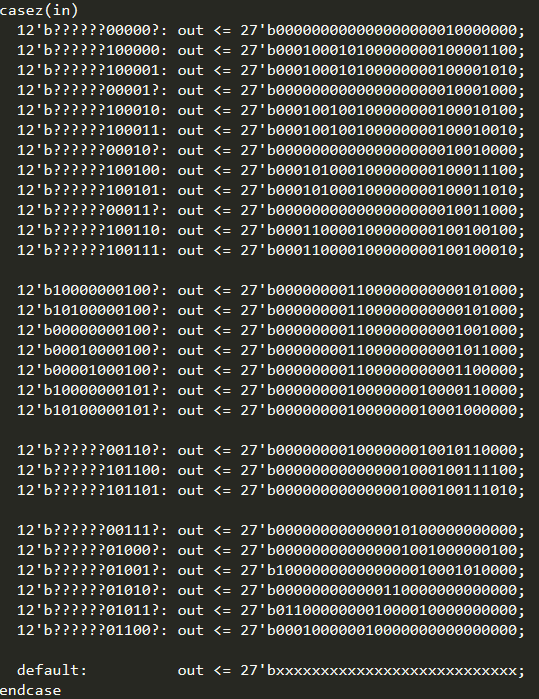
Reports/Final_Report/pla_case.png
