Latootoo/ECSE_548/Reports/Final_Report/pla_lay.png

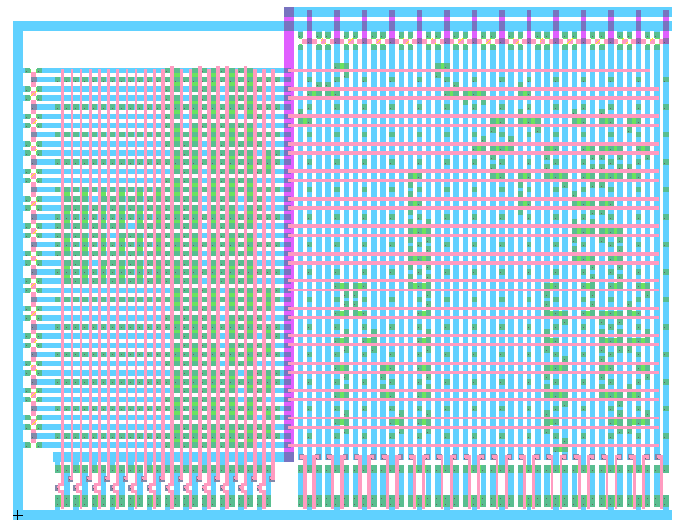
Reports/Final_Report/pla_lay.png
