Latootoo/ECSE_548/Testing/cache/test-vectors.txt

0xxxxxxxx00000001100000000
0xxxxxxxx00000001100000001
10000000100000001100000000
10000000100000110100000001
10000011000000110100000000
00000011000011110011000001
00001111000011110100000000
10001111000011110011000000
