Latootoo/ECSE_548/Testing/sram/test-in.txt

10001111111100000000000000010
10001111111100000000000000010
10001110011100000000000000011
10011111111000000000000100001
10001111111100000000000000010
10001111111100000000000100000
10101111111100000000000000011
11101111111100000000000000011
11101111111100000000000000010
