Latootoo/ECSE_548/Testing/controller_pla/parameters.txt

cellName controller_pla
electricVersion 8.04
m2Width 4
m1Width 4
polyWidth 2
activeWidth 4
weakActiveWidth 3
weakPolyWidth 3
powerAndGndWide 8
m2ToM2Dist 4
m1ToM1Dist 4
polyToPolyDist 3
polyToDiffusionDist 1
weakTransistorToActiveConnection 2
weakTransistorSize 3
wellSurround 6
transistorToActiveConnection 1
nMosInvWidth 5
