Latootoo/ECSE_548/Testing/controller_pla/controller_pla_Cell.v

/* Verilog for cell 'controller_pla_Cell{sch}' from library 'controller_pla' */
/* Created on 星期日 三月 04, 2007 21:40:06 */
/* Last revised on 星期一 十一月 17, 2014 16:41:30 */
/* Written on 星期一 十一月 17, 2014 16:46:19 by Electric VLSI Design System, version 8.06 */

module controller_pla_Cell(in, in_1, in_10, in_11, in_2, in_3, in_4, in_5, 
      in_6, in_7, in_8, in_9, out, out_1, out_10, out_11, out_12, out_13, 
      out_14, out_15, out_16, out_17, out_18, out_19, out_2, out_20, out_21, 
      out_22, out_23, out_24, out_25, out_26, out_3, out_4, out_5, out_6, 
      out_7, out_8, out_9);
  input [0:0] in;
  input [1:1] in_1;
  input [10:10] in_10;
  input [11:11] in_11;
  input [2:2] in_2;
  input [3:3] in_3;
  input [4:4] in_4;
  input [5:5] in_5;
  input [6:6] in_6;
  input [7:7] in_7;
  input [8:8] in_8;
  input [9:9] in_9;
  output [0:0] out;
  output [1:1] out_1;
  output [10:10] out_10;
  output [11:11] out_11;
  output [12:12] out_12;
  output [13:13] out_13;
  output [14:14] out_14;
  output [15:15] out_15;
  output [16:16] out_16;
  output [17:17] out_17;
  output [18:18] out_18;
  output [19:19] out_19;
  output [2:2] out_2;
  output [20:20] out_20;
  output [21:21] out_21;
  output [22:22] out_22;
  output [23:23] out_23;
  output [24:24] out_24;
  output [25:25] out_25;
  output [26:26] out_26;
  output [3:3] out_3;
  output [4:4] out_4;
  output [5:5] out_5;
  output [6:6] out_6;
  output [7:7] out_7;
  output [8:8] out_8;
  output [9:9] out_9;

  supply1 vdd;
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
  rtranif0 pmos_1192(vdd, net_381, gnd);
  rtranif0 pmos_1194(vdd, net_370, gnd);
  rtranif0 pmos_1196(vdd, net_346, gnd);
  rtranif0 pmos_1198(vdd, net_335, gnd);
  rtranif0 pmos_1200(vdd, net_311, gnd);
  rtranif0 pmos_1202(vdd, net_300, gnd);
endmodule   /* controller_pla_Cell */
