Latootoo/ECSE_548/Testing/mips/mips.sv

//---------------------------------------------------------
// mips.sv
// David_Harris@hmc.edu 23 Jan 2008
// Changes 7/3/07
//   Updated to SystemVerilog
//   Fixed endianness
// 23 Jan 08 added $stop
//
// Model of subset of MIPS processor described in Ch 1
//  note that no sign extension is done because width is
//  only 8 bits
//---------------------

// states and instructions

  typedef enum logic [3:0] {FETCH1 = 4'b0000, FETCH2, FETCH3, FETCH4,
                            DECODE, MEMADR, LBRD, LBWR, SBWR,
                            RTYPEEX, RTYPEWR, BEQEX, JEX} statetype;
  typedef enum logic [5:0] {LB    = 6'b100000,
                            SB    = 6'b101000,
                            RTYPE = 6'b000000,
                            BEQ   = 6'b000100,
                            J     = 6'b000010} opcode;
  typedef enum logic [5:0] {ADD = 6'b100000,
                            SUB = 6'b100010,
                            AND = 6'b100100,
                            OR  = 6'b100101,
                            SLT = 6'b101010} functcode;

// testbench for testing
module testbench #(parameter WIDTH = 8, REGBITS = 3)();

  logic             clk;
  logic             reset;
  logic             memread, memwrite;
  logic [WIDTH-1:0] adr, writedata;
  logic [WIDTH-1:0] memdata;

  // instantiate devices to be tested
//  mips #(WIDTH,REGBITS) dut(clk, reset, memdata, memread, 
//                            memwrite, adr, writedata);
  
  //mips dut(adr, clk, ~clk, reset, memdata, memread, memwrite, writedata);
  mips dut(memdata, clk, ~clk, reset, adr, memread, memwrite, writedata);

  // external memory for code and data
  exmemory #(WIDTH) exmem(clk, memwrite, adr, writedata, memdata);

  // initialize test
  initial
    begin
      reset <= 1; # 22; reset <= 0;
    end

  // generate clock to sequence tests
  always
    begin
      clk <= 1; # 5; clk <= 0; # 5;
    end

  always@(negedge clk)
    begin
      if(memwrite) begin
        assert(adr == 76 & writedata == 7)
          $display("Simulation completely successful");
        else $error("Simulation failed");
        $stop;
      end
    end
	
endmodule

// external memory accessed by MIPS
module exmemory #(parameter WIDTH = 8)
                 (input  logic             clk,
                  input  logic             memwrite,
                  input  logic [WIDTH-1:0] adr, writedata,
                  output logic [WIDTH-1:0] memdata);

  logic [31:0]      mem [2**(WIDTH-2)-1:0];
  logic [31:0]      word;
  logic [1:0]       bytesel;
  logic [WIDTH-2:0] wordadr;

  initial
    $readmemh("memfile.dat", mem);

  assign bytesel = adr[1:0];
  assign wordadr = adr[WIDTH-1:2];

  // read and write bytes from 32-bit word
  always @(posedge clk)
    if(memwrite) 
      case (bytesel)
        2'b00: mem[wordadr][7:0]   <= writedata;
        2'b01: mem[wordadr][15:8]  <= writedata;
        2'b10: mem[wordadr][23:16] <= writedata;
        2'b11: mem[wordadr][31:24] <= writedata;
      endcase

   assign word = mem[wordadr];
   always_comb
     case (bytesel)
       2'b00: memdata = word[7:0];
       2'b01: memdata = word[15:8];
       2'b10: memdata = word[23:16];
       2'b11: memdata = word[31:24];
     endcase
endmodule



// simplified MIPS processor
module mips0 #(parameter WIDTH = 8, REGBITS = 3)
             (input  logic             clk, reset, 
              input  logic [WIDTH-1:0] memdata, 
              output logic             memread, memwrite, 
              output logic [WIDTH-1:0] adr, writedata);

   wire        zero, alusrca, memtoreg, iord, pcen, regwrite, regdst;
   wire [1:0]  pcsrc, alusrcb;
   wire [3:0]  irwrite;
   wire [2:0]  alucontrol;
   opcode       op;
   functcode    funct;

   wire hit;
   wire cachewrite, morc, morw;
   wire [WIDTH-1:0] cacheout, dpdata, cachedata;



	  

   controller_plabased  cont(clk, reset, hit, op, funct, zero, memread, memwrite, cachewrite, morc, morw,
                    alusrca, memtoreg, iord, pcen, regwrite, regdst,
                    pcsrc, alusrcb, alucontrol, irwrite);
   datapath0    #(WIDTH, REGBITS) 
               dp(clk, reset, dpdata, alusrca, memtoreg, iord, pcen,
                  regwrite, regdst, pcsrc, alusrcb, irwrite, alucontrol,
                  zero, op, funct, adr, writedata);
  mux2       #(WIDTH)  cachemux(memdata, writedata, morw, cachedata);		
  cache idcache(adr, clk, cachedata, cachewrite, cacheout, hit);
  mux2       #(WIDTH)  dpmux(memdata, cacheout, morc, dpdata);


endmodule
			  
/*
   wire        zero, alusrca, memtoreg, iord, pcen, regwrite, regdst;
   wire [1:0]  pcsrc, alusrcb;
   wire [3:0]  irwrite;
   wire [2:0]  alucontrol;
   opcode       op;
   functcode    funct;

   wire hit;
   wire cachewrite, morc, morw;
   wire [WIDTH-1:0] cacheout, dpdata, cachedata;
   
   
   controller_plabased  cont(clk, reset, hit, op, funct, zero, memread, memwrite, cachewrite, morc, morw,
                    alusrca, memtoreg, iord, pcen, regwrite, regdst,
                    pcsrc, alusrcb, alucontrol, irwrite);

   datapath0    #(WIDTH, REGBITS) 
               dp(clk, reset, dpdata, alusrca, memtoreg, iord, pcen,
                  regwrite, regdst, pcsrc, alusrcb, irwrite, alucontrol,
                  zero, op, funct, adr, writedata);
		  
	mux2       #(WIDTH)  cachemux(memdata, writedata, morw, cachedata);	
	
	cache idcache(adr, clk, cachedata, cachewrite, cacheout, hit);

	mux2       #(WIDTH)  dpmux(memdata, cacheout, morc, dpdata);
endmodule
*/

module controller_plabased(input logic clk, reset, hit, 
                  input  opcode      op,
                  input  functcode   funct,
                  input  logic       zero, 
                  output logic       memread, memwrite, cachewrite, morc, morw, alusrca,  
                  output logic       memtoreg, iord, pcen, 
                  output logic       regwrite, regdst, 
                  output logic [1:0] pcsrc, alusrcb,
                  output logic [2:0] alucontrol,
                  output logic [3:0] irwrite);

  logic            pcwrite, branch;
  logic     [1:0]  aluop;
  logic     [11:0]  in;
  logic     [26:0] out;
  logic     [4:0]  state;
  logic     [4:0]  nextstate;
  
  always_ff @(posedge clk)
     if(reset) state <= 5'b00000;
     else      state <= nextstate;
  
  assign in = {op,state, hit};
  assign {aluop, branch, pcwrite, irwrite, alusrcb, pcsrc, regdst, regwrite, 
          iord, memtoreg, alusrca, memwrite, memread, nextstate, cachewrite, morc, morw} = out;

  aludec  ac(aluop, funct, alucontrol);
  assign pcen = pcwrite | (branch & zero); // program counter enable

  always_comb 
    casez(in)
	
	
      12'b??????00000?: out <= 27'b000000000000000000010000000;
      12'b??????100000: out <= 27'b000100010100000000100001100;
      12'b??????100001: out <= 27'b000100010100000000100001010;
      12'b??????00001?: out <= 27'b000000000000000000010001000;
      12'b??????100010: out <= 27'b000100100100000000100010100;
      12'b??????100011: out <= 27'b000100100100000000100010010;
      12'b??????00010?: out <= 27'b000000000000000000010010000;
      12'b??????100100: out <= 27'b000101000100000000100011100;
      12'b??????100101: out <= 27'b000101000100000000100011010;
      12'b??????00011?: out <= 27'b000000000000000000010011000;	
      12'b??????100110: out <= 27'b000110000100000000100100100;	
      12'b??????100111: out <= 27'b000110000100000000100100010;
	  
      12'b10000000100?: out <= 27'b000000001100000000000101000;
      12'b10100000100?: out <= 27'b000000001100000000000101000;
      12'b00000000100?: out <= 27'b000000001100000000001001000;
      12'b00010000100?: out <= 27'b000000001100000000001011000;
      12'b00001000100?: out <= 27'b000000001100000000001100000;
      12'b10000000101?: out <= 27'b000000001000000010000110000;
      12'b10100000101?: out <= 27'b000000001000000010001000000;

	  12'b??????00110?: out <= 27'b000000001000000010010110000;
      12'b??????101100: out <= 27'b000000000000001000100111100;
      12'b??????101101: out <= 27'b000000000000001000100111010;

      12'b??????00111?: out <= 27'b000000000000010100000000000;
      12'b??????01000?: out <= 27'b000000000000001001000000101;
      12'b??????01001?: out <= 27'b100000000000000010001010000;
      12'b??????01010?: out <= 27'b000000000000110000000000000;
	  12'b??????01011?: out <= 27'b011000000001000010000000000;
      12'b??????01100?: out <= 27'b000100000010000000000000000;
	  
      default:        	out <= 27'bxxxxxxxxxxxxxxxxxxxxxxxxxxx;
	  
    endcase

endmodule

module aludec(input  logic [1:0] aluop, 
              input  logic [5:0] funct, 
              output logic [2:0] alucontrol);

  always_comb
    case (aluop)
      2'b00: alucontrol = 3'b010;  // add for lb/sb/addi
      2'b01: alucontrol = 3'b110;  // subtract (for beq)
      default: case(funct)      // R-Type instructions
                 ADD: alucontrol = 3'b010;
                 SUB: alucontrol = 3'b110;
                 AND: alucontrol = 3'b000;
                 OR:  alucontrol = 3'b001;
                 SLT: alucontrol = 3'b111;
                 default:   alucontrol = 3'b101; // should never happen
               endcase
    endcase
endmodule

module datapath0 #(parameter WIDTH = 8, REGBITS = 3)
                 (input  logic             clk, reset, 
                  input  logic [WIDTH-1:0] memdata, 
                  input  logic             alusrca, memtoreg, iord, 
                  input  logic             pcen, regwrite, regdst,
                  input  logic [1:0]       pcsrc, alusrcb, 
                  input  logic [3:0]       irwrite, 
                  input  logic [2:0]       alucontrol, 
                  output logic             zero,
                  output opcode            op,
                  output functcode         funct,
                  output logic [WIDTH-1:0] adr, writedata);

  logic [REGBITS-1:0] ra1, ra2, wa;
  logic [WIDTH-1:0]   pc, nextpc, data, rd1, rd2, wd, a, srca, 
                      srcb, aluresult, aluout, immx4;
  logic [31:0]        instr;

  logic [WIDTH-1:0] CONST_ZERO = 0;
  logic [WIDTH-1:0] CONST_ONE =  1;
  
  assign op = opcode'(instr[31:26]);
  assign funct = functcode'(instr[5:0]);

  // shift left immediate field by 2
  assign immx4 = {instr[WIDTH-3:0],2'b00};

  // register file address fields
  assign ra1 = instr[REGBITS+20:21];
  assign ra2 = instr[REGBITS+15:16];
  mux2       #(REGBITS) regmux(instr[REGBITS+15:16], 
                               instr[REGBITS+10:11], regdst, wa);

   // independent of bit width, load instruction into four 8-bit registers over four cycles
  flopen     #(8)      ir0(clk, irwrite[0], memdata[7:0], instr[7:0]);
  flopen     #(8)      ir1(clk, irwrite[1], memdata[7:0], instr[15:8]);
  flopen     #(8)      ir2(clk, irwrite[2], memdata[7:0], instr[23:16]);
  flopen     #(8)      ir3(clk, irwrite[3], memdata[7:0], instr[31:24]);

  // datapath
  flopenr    #(WIDTH)  pcreg(clk, reset, pcen, nextpc, pc);
  flop       #(WIDTH)  datareg(clk, memdata, data);
  flop       #(WIDTH)  areg(clk, rd1, a);
  flop       #(WIDTH)  wrdreg(clk, rd2, writedata);
  flop       #(WIDTH)  resreg(clk, aluresult, aluout);
  mux2       #(WIDTH)  adrmux(pc, aluout, iord, adr);
  mux2       #(WIDTH)  src1mux(pc, a, alusrca, srca);
  mux4       #(WIDTH)  src2mux(writedata, CONST_ONE, instr[WIDTH-1:0], 
                               immx4, alusrcb, srcb);
  mux3       #(WIDTH)  pcmux(aluresult, aluout, immx4, 
                             pcsrc, nextpc);
  mux2       #(WIDTH)  wdmux(aluout, data, memtoreg, wd);
  regfile    #(WIDTH,REGBITS) rf(clk, regwrite, ra1, ra2, 
                                 wa, wd, rd1, rd2);
  alu        #(WIDTH) alunit(srca, srcb, alucontrol, aluresult, zero);
endmodule

module alu #(parameter WIDTH = 8)
            (input  logic [WIDTH-1:0] a, b, 
             input  logic [2:0]       alucontrol, 
             output logic [WIDTH-1:0] result,
             output logic             zero);

  logic [WIDTH-1:0] b2, andresult, orresult, sumresult, sltresult;

  andN    andblock(a, b, andresult);
  orN     orblock(a, b, orresult);
  condinv binv(b, alucontrol[2], b2);
  adder   addblock(a, b2, alucontrol[2], sumresult);
  // slt should be 1 if most significant bit of sum is 1
  assign sltresult = sumresult[WIDTH-1];

  mux4 resultmux(andresult, orresult, sumresult, sltresult, alucontrol[1:0], result);
  zerodetect #(WIDTH) zd(result, zero);
endmodule

module regfile #(parameter WIDTH = 8, REGBITS = 3)
                (input  logic               clk, 
                 input  logic               regwrite, 
                 input  logic [REGBITS-1:0] ra1, ra2, wa, 
                 input  logic [WIDTH-1:0]   wd, 
                 output logic [WIDTH-1:0]   rd1, rd2);

   logic [WIDTH-1:0] RAM [2**REGBITS-1:0];

  // three ported register file
  // read two ports combinationally
  // write third port on rising edge of clock
  // register 0 hardwired to 0
  always @(posedge clk)
    if (regwrite) RAM[wa] <= wd;

  assign rd1 = ra1 ? RAM[ra1] : 0;
  assign rd2 = ra2 ? RAM[ra2] : 0;
endmodule

module zerodetect #(parameter WIDTH = 8)
                   (input  logic [WIDTH-1:0] a, 
                    output logic             y);

   assign y = (a==0);
endmodule	

module flop #(parameter WIDTH = 8)
             (input  logic             clk, 
              input  logic [WIDTH-1:0] d, 
              output logic [WIDTH-1:0] q);

  always_ff @(posedge clk)
    q <= d;
endmodule

module flopen #(parameter WIDTH = 8)
               (input  logic             clk, en,
                input  logic [WIDTH-1:0] d, 
                output logic [WIDTH-1:0] q);

  always_ff @(posedge clk)
    if (en) q <= d;
endmodule

module flopenr #(parameter WIDTH = 8)
                (input  logic             clk, reset, en,
                 input  logic [WIDTH-1:0] d, 
                 output logic [WIDTH-1:0] q);
 
  always_ff @(posedge clk)
    if      (reset) q <= 0;
    else if (en)    q <= d;
endmodule

module mux2 #(parameter WIDTH = 8)
             (input  logic [WIDTH-1:0] d0, d1, 
              input  logic             s, 
              output logic [WIDTH-1:0] y);

  assign y = s ? d1 : d0; 
endmodule

module mux3 #(parameter WIDTH = 8)
             (input  logic [WIDTH-1:0] d0, d1, d2,
              input  logic [1:0]       s, 
              output logic [WIDTH-1:0] y);

  always_comb 
    casez (s)
      2'b00: y = d0;
      2'b01: y = d1;
      2'b1?: y = d2;
    endcase
endmodule

module mux4 #(parameter WIDTH = 8)
             (input  logic [WIDTH-1:0] d0, d1, d2, d3,
              input  logic [1:0]       s, 
              output logic [WIDTH-1:0] y);

  always_comb
    case (s)
      2'b00: y = d0;
      2'b01: y = d1;
      2'b10: y = d2;
      2'b11: y = d3;
    endcase
endmodule

module andN #(parameter WIDTH = 8)
             (input  logic [WIDTH-1:0] a, b,
              output logic [WIDTH-1:0] y);

  assign y = a & b;
endmodule

module orN #(parameter WIDTH = 8)
            (input  logic [WIDTH-1:0] a, b,
             output logic [WIDTH-1:0] y);

  assign y = a | b;
endmodule

module inv #(parameter WIDTH = 8)
            (input  logic [WIDTH-1:0] a,
             output logic [WIDTH-1:0] y);

  assign y = ~a;
endmodule

module condinv #(parameter WIDTH = 8)
                (input  logic [WIDTH-1:0] a,
                 input  logic             invert,
                 output logic [WIDTH-1:0] y);

  logic [WIDTH-1:0] ab;

  inv  inverter(a, ab);
  mux2 invmux(a, ab, invert, y);
endmodule

module adder #(parameter WIDTH = 8)
              (input  logic [WIDTH-1:0] a, b,
               input  logic             cin,
               output logic [WIDTH-1:0] y);

  assign y = a + b + cin;
endmodule

module sram(clk, we, wl, valid_in, tag_in, data_in, tag_out, data_out, valid_out);
	input logic clk;
	input logic we;
	input logic valid_in;
	input logic [15:0] wl;
	input logic [3:0] tag_in;
	input logic [7:0] data_in;
	output logic [3:0] tag_out;
	output logic [7:0] data_out;
	output logic valid_out;

	// Internal storage element
	// data
	logic [7:0] ramD[15:0];
	// tag
	logic [3:0] ramT[15:0];
	// valid
	logic ramV[15:0];
	
	// temp address
	logic [3:0] addr;
	
	integer i;
	
	encoder enc(wl, addr);
	
	initial
    begin
		for(i=0; i<16; i++)
		begin
			ramT[i]=0;
			ramV[i]=0;
			ramD[i]=0;
		end
    end
	
	
	always @ (posedge clk)
	begin
		// Write
		if (we)
		begin
			ramT[addr] <= tag_in;		
			ramD[addr] <= data_in;
			ramV[addr] <= 1;
		end
	end
		
	assign	tag_out = ramT[addr];
	assign	data_out = ramD[addr];
	assign 	valid_out = ramV[addr];
	
endmodule


module encoder(input logic [15:0] in, output logic [3:0] out);    
	always_comb
	  casez (in) 
		  16'b0000000000000001 : out = 0; 
		  16'b0000000000000010 : out = 1; 
		  16'b0000000000000100 : out = 2; 
		  16'b0000000000001000 : out = 3; 
		  16'b0000000000010000 : out = 4; 
		  16'b0000000000100000 : out = 5; 
		  16'b0000000001000000 : out = 6; 
		  16'b0000000010000000 : out = 7; 
		  16'b0000000100000000 : out = 8; 
		  16'b0000001000000000 : out = 9; 
		  16'b0000010000000000 : out = 10; 
		  16'b0000100000000000 : out = 11; 
		  16'b0001000000000000 : out = 12; 
		  16'b0010000000000000 : out = 13; 
		  16'b0100000000000000 : out = 14; 
		  16'b1000000000000000 : out = 15; 
	  default: out = 4'bx;
	  endcase
endmodule

module decoder(input logic [3:0] in, output logic [15:0] out);
	always_comb
	  casez (in) 
		  0 : out = 16'b0000000000000001; 
		  1 : out = 16'b0000000000000010; 
		  2 : out = 16'b0000000000000100; 
		  3 : out = 16'b0000000000001000; 
		  4 : out = 16'b0000000000010000; 
		  5 : out = 16'b0000000000100000; 
		  6 : out = 16'b0000000001000000; 
		  7 : out = 16'b0000000010000000; 
		  8 : out = 16'b0000000100000000; 
		  9 : out = 16'b0000001000000000; 
		  10 : out = 16'b0000010000000000; 
		  11 : out = 16'b0000100000000000; 
		  12 : out = 16'b0001000000000000; 
		  13 : out = 16'b0010000000000000; 
		  14 : out = 16'b0100000000000000; 
		  15 : out = 16'b1000000000000000; 
	  default: out = 16'bx;
	  endcase
endmodule

/* Verilog for cell 'mips{sch}' from library 'mips8' */
/* Created on Tue Jul 17, 2007 19:28:57 */
/* Last revised on Sat Nov 22, 2014 23:27:42 */
/* Written on Sat Nov 22, 2014 23:29:22 by Electric VLSI Design System, version 8.06 */

module muddlib07__and2_1x(a, b, y);
  input a;
  input b;
  output y;

  supply1 vdd;
  supply0 gnd;
  wire net_1, net_2;

  tranif1 nmos_0(net_1, net_2, b);
  tranif1 nmos_1(gnd, net_1, a);
  tranif1 nmos_2(gnd, y, net_2);
  tranif0 pmos_0(net_2, vdd, b);
  tranif0 pmos_1(net_2, vdd, a);
  tranif0 pmos_2(y, vdd, net_2);
endmodule   /* muddlib07__and2_1x */

module muddlib07__nor4_1x(a, b, c, d, y);
  input a;
  input b;
  input c;
  input d;
  output y;

  supply1 vdd;
  supply0 gnd;
  wire net_2, net_3, net_41;

  tranif1 nmos_0(gnd, y, d);
  tranif1 nmos_1(gnd, y, c);
  tranif1 nmos_2(gnd, y, b);
  tranif1 nmos_3(gnd, y, a);
  tranif0 pmos_0(net_41, vdd, a);
  tranif0 pmos_1(net_2, net_41, b);
  tranif0 pmos_2(net_3, net_2, c);
  tranif0 pmos_3(y, net_3, d);
endmodule   /* muddlib07__nor4_1x */

module muddlib07__xor2_1x(a, b, y);
  input a;
  input b;
  output y;

  supply1 vdd;
  supply0 gnd;
  wire ab, bb, net_3, net_4, net_7, net_8;

  tranif1 nmos_0(gnd, net_3, a);
  tranif1 nmos_1(gnd, net_4, ab);
  tranif1 nmos_2(net_3, y, b);
  tranif1 nmos_3(net_4, y, bb);
  tranif1 nmos_4(gnd, bb, b);
  tranif1 nmos_5(gnd, ab, a);
  tranif0 pmos_0(y, net_7, b);
  tranif0 pmos_1(net_7, vdd, ab);
  tranif0 pmos_2(y, net_8, bb);
  tranif0 pmos_3(net_8, vdd, a);
  tranif0 pmos_4(bb, vdd, b);
  tranif0 pmos_5(ab, vdd, a);
endmodule   /* muddlib07__xor2_1x */

module vlsi__comp2_1x_4(a, b, status);
  input [3:0] a;
  input [3:0] b;
  output status;

  supply1 vdd;
  supply0 gnd;
  wire net_16, net_20, net_24, net_28;

  muddlib07__nor4_1x nor4_1x_0(.a(net_16), .b(net_20), .c(net_24), .d(net_28), 
      .y(status));
  muddlib07__xor2_1x xor2_1x_0(.a(a[0]), .b(b[0]), .y(net_16));
  muddlib07__xor2_1x xor2_1x_1(.a(a[1]), .b(b[1]), .y(net_20));
  muddlib07__xor2_1x xor2_1x_3(.a(a[2]), .b(b[2]), .y(net_24));
  muddlib07__xor2_1x xor2_1x_4(.a(a[3]), .b(b[3]), .y(net_28));
endmodule   /* vlsi__comp2_1x_4 */

module muddlib07__inv_1x(a, y);
  input a;
  output y;

  supply1 vdd;
  supply0 gnd;
  tranif1 nmos_0(gnd, y, a);
  tranif0 pmos_0(y, vdd, a);
endmodule   /* muddlib07__inv_1x */

module muddlib07__nand2_1x(a, b, y);
  input a;
  input b;
  output y;

  supply1 vdd;
  supply0 gnd;
  wire net_5;

  tranif1 nmos_0(net_5, y, b);
  tranif1 nmos_1(gnd, net_5, a);
  tranif0 pmos_0(y, vdd, b);
  tranif0 pmos_1(y, vdd, a);
endmodule   /* muddlib07__nand2_1x */

module muddlib07__nor2_1x(a, b, y);
  input a;
  input b;
  output y;

  supply1 vdd;
  supply0 gnd;
  wire net_9;

  tranif1 nmos_0(gnd, y, a);
  tranif1 nmos_1(gnd, y, b);
  tranif0 pmos_0(y, net_9, b);
  tranif0 pmos_1(net_9, vdd, a);
endmodule   /* muddlib07__nor2_1x */

module vlsi__decoder16_1x(a, y);
  input [3:0] a;
  output [15:0] y;

  supply1 vdd;
  supply0 gnd;
  wire net_16, net_26, net_36, net_38, net_46, net_54, net_6, net_62, net_70;
  wire net_72, net_74, net_76;

  muddlib07__inv_1x inv_1x_0(.a(a[3]), .y(net_6));
  muddlib07__inv_1x inv_1x_1(.a(a[2]), .y(net_16));
  muddlib07__inv_1x inv_1x_2(.a(a[1]), .y(net_26));
  muddlib07__inv_1x inv_1x_3(.a(a[0]), .y(net_36));
  muddlib07__nand2_1x nand2_1x_0(.a(a[2]), .b(a[3]), .y(net_62));
  muddlib07__nand2_1x nand2_1x_2(.a(net_16), .b(a[3]), .y(net_54));
  muddlib07__nand2_1x nand2_1x_3(.a(a[2]), .b(net_6), .y(net_46));
  muddlib07__nand2_1x nand2_1x_4(.a(net_16), .b(net_6), .y(net_38));
  muddlib07__nand2_1x nand2_1x_5(.a(a[0]), .b(a[1]), .y(net_76));
  muddlib07__nand2_1x nand2_1x_6(.a(net_36), .b(a[1]), .y(net_74));
  muddlib07__nand2_1x nand2_1x_7(.a(a[0]), .b(net_26), .y(net_72));
  muddlib07__nand2_1x nand2_1x_8(.a(net_36), .b(net_26), .y(net_70));
  muddlib07__nor2_1x nor2_1x_0(.a(net_70), .b(net_38), .y(y[0]));
  muddlib07__nor2_1x nor2_1x_1(.a(net_72), .b(net_38), .y(y[1]));
  muddlib07__nor2_1x nor2_1x_2(.a(net_74), .b(net_38), .y(y[2]));
  muddlib07__nor2_1x nor2_1x_3(.a(net_76), .b(net_38), .y(y[3]));
  muddlib07__nor2_1x nor2_1x_4(.a(net_74), .b(net_46), .y(y[6]));
  muddlib07__nor2_1x nor2_1x_5(.a(net_76), .b(net_46), .y(y[7]));
  muddlib07__nor2_1x nor2_1x_6(.a(net_70), .b(net_46), .y(y[4]));
  muddlib07__nor2_1x nor2_1x_7(.a(net_72), .b(net_46), .y(y[5]));
  muddlib07__nor2_1x nor2_1x_8(.a(net_70), .b(net_54), .y(y[8]));
  muddlib07__nor2_1x nor2_1x_9(.a(net_72), .b(net_54), .y(y[9]));
  muddlib07__nor2_1x nor2_1x_10(.a(net_74), .b(net_54), .y(y[10]));
  muddlib07__nor2_1x nor2_1x_11(.a(net_76), .b(net_54), .y(y[11]));
  muddlib07__nor2_1x nor2_1x_12(.a(net_74), .b(net_62), .y(y[14]));
  muddlib07__nor2_1x nor2_1x_13(.a(net_76), .b(net_62), .y(y[15]));
  muddlib07__nor2_1x nor2_1x_14(.a(net_70), .b(net_62), .y(y[12]));
  muddlib07__nor2_1x nor2_1x_15(.a(net_72), .b(net_62), .y(y[13]));
endmodule   /* vlsi__decoder16_1x */

module muddlib07__buftri_c_1x(d, en, y);
  input d;
  input en;
  output y;

  supply1 vdd;
  supply0 gnd;
  wire net_1, net_3, net_54, net_6;

  tranif1 nmos_0(gnd, net_3, net_6);
  tranif1 nmos_1(net_3, y, en);
  tranif1 nmos_2(gnd, net_54, en);
  tranif1 nmos_3(gnd, net_6, d);
  tranif0 pmos_0(y, net_1, net_54);
  tranif0 pmos_1(net_1, vdd, net_6);
  tranif0 pmos_2(net_54, vdd, en);
  tranif0 pmos_3(net_6, vdd, d);
endmodule   /* muddlib07__buftri_c_1x */

module vlsi__inv_hi(a, y);
  input a;
  output y;

  supply1 vdd;
  supply0 gnd;
  tranif1 nmos_0(gnd, y, a);
  tranif0 pmos_0(y, vdd, a);
endmodule   /* vlsi__inv_hi */

module muddlib07__srambit(bit_a, bit_b, word);
  input bit_a;
  input bit_b;
  input word;

  supply1 vdd;
  supply0 gnd;
  wire net_67, net_68;

  tranif1 nmos_4(gnd, net_67, net_68);
  tranif1 nmos_5(net_68, gnd, net_67);
  tranif1 nmos_6(bit_a, net_68, word);
  tranif1 nmos_7(net_67, bit_b, word);
  rtranif0 pmos_2(net_67, vdd, net_68);
  rtranif0 pmos_3(vdd, net_68, net_67);
endmodule   /* muddlib07__srambit */

module vlsi__sramcol(clk, in, we, wl, out);
  input clk;
  input in;
  input we;
  input [15:0] wl;
  output out;

  supply1 vdd;
  supply0 gnd;
  wire inv_hi_0_y, net_103, net_115, net_120, net_148, net_149, net_150;
  wire net_151, net_152, net_153, net_154, net_155, net_2, net_33, net_34;
  wire net_59, net_64, net_78, net_8, net_83, net_9, net_98;

  tranif1 nmos_0(net_33, net_9, we);
  tranif1 nmos_1(net_34, net_8, we);
  tranif1 nmos_2(gnd, net_33, in);
  tranif1 nmos_3(gnd, net_34, net_2);
  tranif0 pmos_0(net_8, vdd, clk);
  tranif0 pmos_1(net_9, vdd, clk);
  muddlib07__buftri_c_1x buftri_c_0(.d(wl[15]), .en(clk), .y(net_64));
  muddlib07__buftri_c_1x buftri_c_2(.d(wl[14]), .en(clk), .y(net_59));
  muddlib07__buftri_c_1x buftri_c_3(.d(wl[13]), .en(clk), .y(net_148));
  muddlib07__buftri_c_1x buftri_c_4(.d(wl[12]), .en(clk), .y(net_149));
  muddlib07__buftri_c_1x buftri_c_5(.d(wl[11]), .en(clk), .y(net_83));
  muddlib07__buftri_c_1x buftri_c_6(.d(wl[10]), .en(clk), .y(net_78));
  muddlib07__buftri_c_1x buftri_c_7(.d(wl[9]), .en(clk), .y(net_150));
  muddlib07__buftri_c_1x buftri_c_8(.d(wl[8]), .en(clk), .y(net_151));
  muddlib07__buftri_c_1x buftri_c_9(.d(wl[4]), .en(clk), .y(net_153));
  muddlib07__buftri_c_1x buftri_c_10(.d(wl[3]), .en(clk), .y(net_120));
  muddlib07__buftri_c_1x buftri_c_11(.d(wl[2]), .en(clk), .y(net_115));
  muddlib07__buftri_c_1x buftri_c_12(.d(wl[1]), .en(clk), .y(net_154));
  muddlib07__buftri_c_1x buftri_c_13(.d(wl[0]), .en(clk), .y(net_155));
  muddlib07__buftri_c_1x buftri_c_14(.d(wl[7]), .en(clk), .y(net_103));
  muddlib07__buftri_c_1x buftri_c_15(.d(wl[6]), .en(clk), .y(net_98));
  muddlib07__buftri_c_1x buftri_c_16(.d(wl[5]), .en(clk), .y(net_152));
  muddlib07__inv_1x inv_1x_0(.a(in), .y(net_2));
  vlsi__inv_hi inv_hi_0(.a(net_9), .y(inv_hi_0_y));
  vlsi__inv_hi inv_hi_1(.a(net_8), .y(out));
  muddlib07__srambit srambit_0(.bit_a(net_9), .bit_b(net_8), .word(net_64));
  muddlib07__srambit srambit_1(.bit_a(net_9), .bit_b(net_8), .word(net_59));
  muddlib07__srambit srambit_2(.bit_a(net_9), .bit_b(net_8), .word(net_148));
  muddlib07__srambit srambit_3(.bit_a(net_9), .bit_b(net_8), .word(net_149));
  muddlib07__srambit srambit_4(.bit_a(net_9), .bit_b(net_8), .word(net_83));
  muddlib07__srambit srambit_5(.bit_a(net_9), .bit_b(net_8), .word(net_78));
  muddlib07__srambit srambit_6(.bit_a(net_9), .bit_b(net_8), .word(net_150));
  muddlib07__srambit srambit_7(.bit_a(net_9), .bit_b(net_8), .word(net_151));
  muddlib07__srambit srambit_8(.bit_a(net_9), .bit_b(net_8), .word(net_152));
  muddlib07__srambit srambit_9(.bit_a(net_9), .bit_b(net_8), .word(net_153));
  muddlib07__srambit srambit_10(.bit_a(net_9), .bit_b(net_8), .word(net_120));
  muddlib07__srambit srambit_11(.bit_a(net_9), .bit_b(net_8), .word(net_115));
  muddlib07__srambit srambit_12(.bit_a(net_9), .bit_b(net_8), .word(net_154));
  muddlib07__srambit srambit_13(.bit_a(net_9), .bit_b(net_8), .word(net_155));
  muddlib07__srambit srambit_14(.bit_a(net_9), .bit_b(net_8), .word(net_103));
  muddlib07__srambit srambit_15(.bit_a(net_9), .bit_b(net_8), .word(net_98));
endmodule   /* vlsi__sramcol */

module vlsi__sram(clk, data_in, tag_in, valid_in, we, wl, data_out, tag_out, 
      valid_out);
  input clk;
  input [7:0] data_in;
  input [3:0] tag_in;
  input valid_in;
  input we;
  input [15:0] wl;
  output [7:0] data_out;
  output [3:0] tag_out;
  output valid_out;

  supply1 vdd;
  supply0 gnd;
  wire [15:0] sramcol_12_wl;

  vlsi__sramcol sramcol_0(.clk(clk), .in(tag_in[3]), .we(we), .wl(wl[15:0]), 
      .out(tag_out[3]));
  vlsi__sramcol sramcol_1(.clk(clk), .in(tag_in[2]), .we(we), .wl(wl[15:0]), 
      .out(tag_out[2]));
  vlsi__sramcol sramcol_2(.clk(clk), .in(tag_in[1]), .we(we), .wl(wl[15:0]), 
      .out(tag_out[1]));
  vlsi__sramcol sramcol_3(.clk(clk), .in(tag_in[0]), .we(we), .wl(wl[15:0]), 
      .out(tag_out[0]));
  vlsi__sramcol sramcol_4(.clk(clk), .in(data_in[7]), .we(we), .wl(wl[15:0]), 
      .out(data_out[7]));
  vlsi__sramcol sramcol_5(.clk(clk), .in(data_in[6]), .we(we), .wl(wl[15:0]), 
      .out(data_out[6]));
  vlsi__sramcol sramcol_6(.clk(clk), .in(data_in[5]), .we(we), .wl(wl[15:0]), 
      .out(data_out[5]));
  vlsi__sramcol sramcol_7(.clk(clk), .in(data_in[4]), .we(we), .wl(wl[15:0]), 
      .out(data_out[4]));
  vlsi__sramcol sramcol_8(.clk(clk), .in(data_in[0]), .we(we), .wl(wl[15:0]), 
      .out(data_out[0]));
  vlsi__sramcol sramcol_9(.clk(clk), .in(data_in[3]), .we(we), .wl(wl[15:0]), 
      .out(data_out[3]));
  vlsi__sramcol sramcol_10(.clk(clk), .in(data_in[2]), .we(we), .wl(wl[15:0]), 
      .out(data_out[2]));
  vlsi__sramcol sramcol_11(.clk(clk), .in(data_in[1]), .we(we), .wl(wl[15:0]), 
      .out(data_out[1]));
  vlsi__sramcol sramcol_12(.clk(clk), .in(valid_in), .we(we), 
      .wl(sramcol_12_wl[15:0]), .out(valid_out));
endmodule   /* vlsi__sram */

module vlsi__cache(address, clk, data_in, we, data_out, hit);
  input [7:0] address;
  input clk;
  input [7:0] data_in;
  input we;
  output [7:0] data_out;
  output hit;

  supply1 vdd;
  supply0 gnd;
  wire net_13, net_14;
  wire [15:0] net_4;
  wire [3:0] net_8;

  muddlib07__and2_1x and2_1x_0(.a(net_14), .b(net_13), .y(hit));
  vlsi__comp2_1x_4 comp2_1x_0(.a(address[7:4]), .b(net_8[3:0]), 
      .status(net_13));
  vlsi__decoder16_1x decoder1_0(.a(address[3:0]), .y(net_4[15:0]));

  /*  vlsi__sram sram_0(.clk(clk), .data_in(data_in[7:0]), .tag_in(address[7:4]), 
      .valid_in(we), .we(we), .wl(net_4[15:0]), .data_out(data_out[7:0]), 
      .tag_out(net_8[3:0]), .valid_out(net_14));
*/

  sram sram_0(clk, we, net_4, we, address[7:4], data_in, net_8, data_out, net_14);
endmodule   /* vlsi__cache */

module muddlib07__a2o1_1x(a, b, c, y);
  input a;
  input b;
  input c;
  output y;

  supply1 vdd;
  supply0 gnd;
  wire net_0, net_11, net_19;

  tranif1 nmos_0(gnd, net_19, a);
  tranif1 nmos_1(net_19, net_0, b);
  tranif1 nmos_2(gnd, net_0, c);
  tranif1 nmos_3(gnd, y, net_0);
  tranif0 pmos_0(net_0, net_11, c);
  tranif0 pmos_1(net_11, vdd, b);
  tranif0 pmos_2(net_11, vdd, a);
  tranif0 pmos_3(y, vdd, net_0);
endmodule   /* muddlib07__a2o1_1x */

module muddlib07__mux4_c_2x(d0, d1, d2, d3, s0, s1, y);
  input d0;
  input d1;
  input d2;
  input d3;
  input s0;
  input s1;
  output y;

  supply1 vdd;
  supply0 gnd;
  wire net_1, net_17, net_18, net_21, net_29, net_30, net_47, net_49, net_54;
  wire net_55, net_59, net_68, net_70, s0b, s1b;

  tranif1 nmos_0(gnd, net_47, d0);
  tranif1 nmos_1(gnd, net_59, d1);
  tranif1 nmos_2(gnd, net_70, d3);
  tranif1 nmos_3(net_68, net_49, s0b);
  tranif1 nmos_4(net_70, net_49, s0);
  tranif1 nmos_5(net_49, net_17, s1);
  tranif1 nmos_6(gnd, net_68, d2);
  tranif1 nmos_7(gnd, y, net_17);
  tranif1 nmos_8(gnd, s0b, s0);
  tranif1 nmos_9(gnd, s1b, s1);
  tranif1 nmos_10(net_47, net_1, s0b);
  tranif1 nmos_11(net_59, net_1, s0);
  tranif1 nmos_12(net_1, net_17, s1b);
  tranif0 pmos_0(net_17, net_18, s1);
  tranif0 pmos_1(net_55, vdd, d3);
  tranif0 pmos_2(net_21, net_54, s0);
  tranif0 pmos_3(net_54, vdd, d2);
  tranif0 pmos_4(net_21, net_55, s0b);
  tranif0 pmos_5(net_17, net_21, s1b);
  tranif0 pmos_6(y, vdd, net_17);
  tranif0 pmos_7(s0b, vdd, s0);
  tranif0 pmos_8(s1b, vdd, s1);
  tranif0 pmos_9(net_18, net_29, s0);
  tranif0 pmos_10(net_29, vdd, d0);
  tranif0 pmos_11(net_18, net_30, s0b);
  tranif0 pmos_12(net_30, vdd, d1);
endmodule   /* muddlib07__mux4_c_2x */

module muddlib07__or2_2x(a, b, y);
  input a;
  input b;
  output y;

  supply1 vdd;
  supply0 gnd;
  wire net_0, net_11;

  tranif1 nmos_0(gnd, y, net_0);
  tranif1 nmos_1(gnd, net_0, a);
  tranif1 nmos_2(gnd, net_0, b);
  tranif0 pmos_0(net_0, net_11, b);
  tranif0 pmos_1(net_11, vdd, a);
  tranif0 pmos_2(y, vdd, net_0);
endmodule   /* muddlib07__or2_2x */

module mips8__aludec(ALUOp, Funct, alucontrol);
  input [1:0] ALUOp;
  input [3:0] Funct;
  output [2:0] alucontrol;

  supply1 vdd;
  supply0 gnd;
  wire net_42, net_50, net_72;

  muddlib07__inv_1x inv_1x_0(.a(Funct[2]), .y(net_42));
  muddlib07__inv_1x inv_1x_1(.a(ALUOp[1]), .y(net_72));
  muddlib07__mux4_c_2x mux4_c_2_0(.d0(ALUOp[1]), .d1(ALUOp[1]), .d2(net_50), 
      .d3(net_50), .s0(ALUOp[0]), .s1(ALUOp[1]), .y(alucontrol[0]));
  muddlib07__mux4_c_2x mux4_c_2_1(.d0(net_72), .d1(net_72), .d2(net_42), 
      .d3(net_42), .s0(ALUOp[0]), .s1(ALUOp[1]), .y(alucontrol[1]));
  muddlib07__mux4_c_2x mux4_c_2_2(.d0(ALUOp[1]), .d1(ALUOp[0]), .d2(Funct[1]), 
      .d3(Funct[1]), .s0(ALUOp[0]), .s1(ALUOp[1]), .y(alucontrol[2]));
  muddlib07__or2_2x or2_2x_1(.a(Funct[0]), .b(Funct[3]), .y(net_50));
endmodule   /* mips8__aludec */

module mips8__controller_pla_Cell(in, in_1, in_10, in_11, in_2, in_3, in_4, 
      in_5, in_6, in_7, in_8, in_9, out, out_1, out_10, out_11, out_12, out_13, 
      out_14, out_15, out_16, out_17, out_18, out_19, out_2, out_20, out_21, 
      out_22, out_23, out_24, out_25, out_26, out_3, out_4, out_5, out_6, 
      out_7, out_8, out_9);
  input [0:0] in;
  input [1:1] in_1;
  input [10:10] in_10;
  input [11:11] in_11;
  input [2:2] in_2;
  input [3:3] in_3;
  input [4:4] in_4;
  input [5:5] in_5;
  input [6:6] in_6;
  input [7:7] in_7;
  input [8:8] in_8;
  input [9:9] in_9;
  output [0:0] out;
  output [1:1] out_1;
  output [10:10] out_10;
  output [11:11] out_11;
  output [12:12] out_12;
  output [13:13] out_13;
  output [14:14] out_14;
  output [15:15] out_15;
  output [16:16] out_16;
  output [17:17] out_17;
  output [18:18] out_18;
  output [19:19] out_19;
  output [2:2] out_2;
  output [20:20] out_20;
  output [21:21] out_21;
  output [22:22] out_22;
  output [23:23] out_23;
  output [24:24] out_24;
  output [25:25] out_25;
  output [26:26] out_26;
  output [3:3] out_3;
  output [4:4] out_4;
  output [5:5] out_5;
  output [6:6] out_6;
  output [7:7] out_7;
  output [8:8] out_8;
  output [9:9] out_9;

  supply1 vdd;
  supply0 gnd;
  wire net_0, net_1150, net_1160, net_1163, net_1166, net_1169, net_1172;
  wire net_1181, net_1201, net_1204, net_1210, net_1218, net_1229, net_1235;
  wire net_1241, net_1251, net_1264, net_1277, net_1284, net_14, net_1465;
  wire net_1473, net_1481, net_1545, net_1553, net_1561, net_1585, net_1601;
  wire net_1673, net_1980, net_1981, net_21, net_28, net_301, net_312, net_336;
  wire net_347, net_371, net_382, net_406, net_419, net_42, net_448, net_459;
  wire net_49, net_507, net_530, net_56, net_584, net_607, net_63, net_661;
  wire net_684, net_70, net_738, net_751, net_77, net_780, net_791, net_819;
  wire net_832, net_858, net_871, net_900, net_911, net_939, net_952;

  tranif1 nmos_3(gnd, net_0, in_11[11]);
  tranif1 nmos_10(gnd, net_1980, in_10[10]);
  tranif1 nmos_17(gnd, net_14, in_9[9]);
  tranif1 nmos_24(gnd, net_21, in_8[8]);
  tranif1 nmos_31(gnd, net_28, in_7[7]);
  tranif1 nmos_38(gnd, net_1981, in_6[6]);
  tranif1 nmos_45(gnd, net_42, in_5[5]);
  tranif1 nmos_52(gnd, net_49, in_4[4]);
  tranif1 nmos_59(gnd, net_56, in_3[3]);
  tranif1 nmos_66(gnd, net_63, in_2[2]);
  tranif1 nmos_73(gnd, net_70, in_1[1]);
  tranif1 nmos_80(gnd, net_77, in[0]);
  tranif1 nmos_86(net_301, gnd, in_5[5]);
  tranif1 nmos_87(net_301, gnd, net_49);
  tranif1 nmos_88(net_301, gnd, net_56);
  tranif1 nmos_89(net_301, gnd, in_2[2]);
  tranif1 nmos_90(net_301, gnd, in_1[1]);
  tranif1 nmos_91(gnd, net_312, in_5[5]);
  tranif1 nmos_92(gnd, net_312, net_49);
  tranif1 nmos_93(gnd, net_312, in_3[3]);
  tranif1 nmos_94(gnd, net_312, net_63);
  tranif1 nmos_95(gnd, net_312, net_70);
  tranif1 nmos_96(net_336, gnd, in_5[5]);
  tranif1 nmos_97(net_336, gnd, net_49);
  tranif1 nmos_98(net_336, gnd, in_3[3]);
  tranif1 nmos_99(net_336, gnd, net_63);
  tranif1 nmos_100(net_336, gnd, in_1[1]);
  tranif1 nmos_101(gnd, net_347, in_5[5]);
  tranif1 nmos_102(gnd, net_347, net_49);
  tranif1 nmos_103(gnd, net_347, in_3[3]);
  tranif1 nmos_104(gnd, net_347, in_2[2]);
  tranif1 nmos_105(gnd, net_347, net_70);
  tranif1 nmos_106(net_371, gnd, in_5[5]);
  tranif1 nmos_107(net_371, gnd, net_49);
  tranif1 nmos_108(net_371, gnd, in_3[3]);
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
  rtranif0 pmos_1122(net_1585, vdd, gnd);
  rtranif0 pmos_1124(net_1210, vdd, gnd);
  rtranif0 pmos_1126(net_1601, vdd, gnd);
  rtranif0 pmos_1128(net_1218, vdd, gnd);
  rtranif0 pmos_1130(net_1229, vdd, gnd);
  rtranif0 pmos_1132(net_1235, vdd, gnd);
  rtranif0 pmos_1134(net_1241, vdd, gnd);
  rtranif0 pmos_1136(net_1251, vdd, gnd);
  rtranif0 pmos_1138(net_1264, vdd, gnd);
  rtranif0 pmos_1140(net_1277, vdd, gnd);
  rtranif0 pmos_1142(net_1284, vdd, gnd);
  rtranif0 pmos_1144(net_1673, vdd, gnd);
  rtranif0 pmos_1148(vdd, net_952, gnd);
  rtranif0 pmos_1150(vdd, net_939, gnd);
  rtranif0 pmos_1152(vdd, net_911, gnd);
  rtranif0 pmos_1154(vdd, net_900, gnd);
  rtranif0 pmos_1156(vdd, net_871, gnd);
  rtranif0 pmos_1158(vdd, net_858, gnd);
  rtranif0 pmos_1160(vdd, net_832, gnd);
  rtranif0 pmos_1162(vdd, net_819, gnd);
  rtranif0 pmos_1164(vdd, net_791, gnd);
  rtranif0 pmos_1166(vdd, net_780, gnd);
  rtranif0 pmos_1168(vdd, net_751, gnd);
  rtranif0 pmos_1170(vdd, net_738, gnd);
  rtranif0 pmos_1172(vdd, net_684, gnd);
  rtranif0 pmos_1174(vdd, net_661, gnd);
  rtranif0 pmos_1176(vdd, net_607, gnd);
  rtranif0 pmos_1178(vdd, net_584, gnd);
  rtranif0 pmos_1180(vdd, net_530, gnd);
  rtranif0 pmos_1182(vdd, net_507, gnd);
  rtranif0 pmos_1184(vdd, net_459, gnd);
  rtranif0 pmos_1186(vdd, net_448, gnd);
  rtranif0 pmos_1188(vdd, net_419, gnd);
  rtranif0 pmos_1190(vdd, net_406, gnd);
  rtranif0 pmos_1192(vdd, net_382, gnd);
  rtranif0 pmos_1194(vdd, net_371, gnd);
  rtranif0 pmos_1196(vdd, net_347, gnd);
  rtranif0 pmos_1198(vdd, net_336, gnd);
  rtranif0 pmos_1200(vdd, net_312, gnd);
  rtranif0 pmos_1202(vdd, net_301, gnd);
endmodule   /* mips8__controller_pla_Cell */

module muddlib07__flopr_c_1x(ph1, ph2, d, resetb, q);
  input ph1;
  input ph2;
  input d;
  input resetb;
  output q;

  supply1 vdd;
  supply0 gnd;
  wire master, masterinb, n6, n7, n8, n9, net_429, ph1b, ph1buf, ph2b, ph2buf;
  wire slaveb;
  trireg masterb, slave;

  tranif1 nmos_2(masterinb, masterb, ph2buf);
  tranif1 nmos_3(gnd, master, masterb);
  rtranif1 nmos_4(master, slave, ph1buf);
  tranif1 nmos_5(n6, masterb, ph2b);
  tranif1 nmos_6(gnd, n6, master);
  tranif1 nmos_7(gnd, n8, slaveb);
  tranif1 nmos_8(gnd, slaveb, slave);
  tranif1 nmos_10(n8, slave, ph1b);
  tranif1 nmos_11(gnd, q, slaveb);
  tranif1 nmos_17(gnd, net_429, resetb);
  tranif1 nmos_19(net_429, masterinb, d);
  tranif1 nmos_22(gnd, ph2b, ph2);
  tranif1 nmos_25(gnd, ph2buf, ph2b);
  tranif1 nmos_26(gnd, ph1buf, ph1b);
  tranif1 nmos_27(gnd, ph1b, ph1);
  tranif0 pmos_2(masterb, masterinb, ph2b);
  tranif0 pmos_3(master, vdd, masterb);
  rtranif0 pmos_4(slave, master, ph1b);
  tranif0 pmos_5(masterb, n7, ph2buf);
  tranif0 pmos_6(n7, vdd, master);
  tranif0 pmos_7(n9, vdd, slaveb);
  tranif0 pmos_8(slaveb, vdd, slave);
  tranif0 pmos_10(slave, n9, ph1buf);
  tranif0 pmos_11(q, vdd, slaveb);
  tranif0 pmos_16(masterinb, vdd, d);
  tranif0 pmos_18(masterinb, vdd, resetb);
  tranif0 pmos_21(ph1b, vdd, ph1);
  tranif0 pmos_22(ph2b, vdd, ph2);
  tranif0 pmos_24(ph1buf, vdd, ph1b);
  tranif0 pmos_25(ph2buf, vdd, ph2b);
endmodule   /* muddlib07__flopr_c_1x */

module mips8__controller(funct, hit, op, ph1, ph2, reset, zero, alucontrol, 
      alusrca, alusrcb, cachewrite, iord, irwrite, memread, memtoreg, memwrite, 
      morc, morw, pcen, pcsrc, regdst, regwrite);
  input [3:0] funct;
  input hit;
  input [5:0] op;
  input ph1;
  input ph2;
  input reset;
  input zero;
  output [2:0] alucontrol;
  output alusrca;
  output [1:0] alusrcb;
  output cachewrite;
  output iord;
  output [3:0] irwrite;
  output memread;
  output memtoreg;
  output memwrite;
  output morc;
  output morw;
  output pcen;
  output [1:0] pcsrc;
  output regdst;
  output regwrite;

  supply1 vdd;
  supply0 gnd;
  wire branch, net_86, pcwrite;
  wire [1:0] ALUOp;
  wire [4:0] nextstate;
  wire [4:0] state;

  muddlib07__a2o1_1x a2o1_1x_0(.a(zero), .b(branch), .c(pcwrite), .y(pcen));
  mips8__aludec aludec_1(.ALUOp(ALUOp[1:0]), .Funct(funct[3:0]), 
      .alucontrol(alucontrol[2:0]));
  mips8__controller_pla_Cell controll_4(.in({hit}), .in_1(state[0:0]), 
      .in_10(op[4:4]), .in_11(op[5:5]), .in_2(state[1:1]), .in_3(state[2:2]), 
      .in_4(state[3:3]), .in_5(state[4:4]), .in_6(op[0:0]), .in_7(op[1:1]), 
      .in_8(op[2:2]), .in_9(op[3:3]), .out({morw}), .out_1({morc}), 
      .out_10({alusrca}), .out_11({memtoreg}), .out_12({iord}), 
      .out_13({regwrite}), .out_14({regdst}), .out_15(pcsrc[0:0]), 
      .out_16(pcsrc[1:1]), .out_17(alusrcb[0:0]), .out_18(alusrcb[1:1]), 
      .out_19(irwrite[0:0]), .out_2({cachewrite}), .out_20(irwrite[1:1]), 
      .out_21(irwrite[2:2]), .out_22(irwrite[3:3]), .out_23({pcwrite}), 
      .out_24({branch}), .out_25(ALUOp[0:0]), .out_26(ALUOp[1:1]), 
      .out_3(nextstate[0:0]), .out_4(nextstate[1:1]), .out_5(nextstate[2:2]), 
      .out_6(nextstate[3:3]), .out_7(nextstate[4:4]), .out_8({memread}), 
      .out_9({memwrite}));
  muddlib07__inv_1x inv_1x_0(.a(reset), .y(net_86));
  muddlib07__flopr_c_1x stateflop_4_(.ph1(ph1), .ph2(ph2), .d(nextstate[4]), 
      .resetb(net_86), .q(state[4]));
  muddlib07__flopr_c_1x stateflop_3_(.ph1(ph1), .ph2(ph2), .d(nextstate[3]), 
      .resetb(net_86), .q(state[3]));
  muddlib07__flopr_c_1x stateflop_2_(.ph1(ph1), .ph2(ph2), .d(nextstate[2]), 
      .resetb(net_86), .q(state[2]));
  muddlib07__flopr_c_1x stateflop_1_(.ph1(ph1), .ph2(ph2), .d(nextstate[1]), 
      .resetb(net_86), .q(state[1]));
  muddlib07__flopr_c_1x stateflop_0_(.ph1(ph1), .ph2(ph2), .d(nextstate[0]), 
      .resetb(net_86), .q(state[0]));
endmodule   /* mips8__controller */

module muddlib07__inv_4x(a, y);
  input a;
  output y;

  supply1 vdd;
  supply0 gnd;
  tranif1 nmos_0(gnd, y, a);
  tranif0 pmos_0(y, vdd, a);
endmodule   /* muddlib07__inv_4x */

module muddlib07__invbuf_4x(s, s_out, sb_out);
  input s;
  output s_out;
  output sb_out;

  supply1 vdd;
  supply0 gnd;
  muddlib07__inv_4x inv_4x_3(.a(s), .y(sb_out));
  muddlib07__inv_4x inv_4x_4(.a(sb_out), .y(s_out));
endmodule   /* muddlib07__invbuf_4x */

module muddlib07__mux2_dp_1x(d0, d1, s, sb, y);
  input d0;
  input d1;
  input s;
  input sb;
  output y;

  supply1 vdd;
  supply0 gnd;
  wire net_12, net_15, net_3, net_4, net_8;

  tranif1 nmos_0(gnd, net_3, d1);
  tranif1 nmos_1(gnd, net_4, d0);
  tranif1 nmos_2(net_3, net_8, s);
  tranif1 nmos_3(net_4, net_8, sb);
  tranif1 nmos_4(gnd, y, net_8);
  tranif0 pmos_0(net_8, net_15, sb);
  tranif0 pmos_1(net_15, vdd, d1);
  tranif0 pmos_2(net_8, net_12, s);
  tranif0 pmos_3(net_12, vdd, d0);
  tranif0 pmos_4(y, vdd, net_8);
endmodule   /* muddlib07__mux2_dp_1x */

module wordlib8__mux2_1x_8_sch(d0, d1, s, y);
  input [7:0] d0;
  input [7:0] d1;
  input s;
  output [7:0] y;

  supply1 vdd;
  supply0 gnd;
  wire net_27, net_29;

  muddlib07__invbuf_4x invbuf_4_0(.s(s), .s_out(net_29), .sb_out(net_27));
  muddlib07__mux2_dp_1x mux2_1x_dp_7_(.d0(d0[7]), .d1(d1[7]), .s(net_29), 
      .sb(net_27), .y(y[7]));
  muddlib07__mux2_dp_1x mux2_1x_dp_6_(.d0(d0[6]), .d1(d1[6]), .s(net_29), 
      .sb(net_27), .y(y[6]));
  muddlib07__mux2_dp_1x mux2_1x_dp_5_(.d0(d0[5]), .d1(d1[5]), .s(net_29), 
      .sb(net_27), .y(y[5]));
  muddlib07__mux2_dp_1x mux2_1x_dp_4_(.d0(d0[4]), .d1(d1[4]), .s(net_29), 
      .sb(net_27), .y(y[4]));
  muddlib07__mux2_dp_1x mux2_1x_dp_3_(.d0(d0[3]), .d1(d1[3]), .s(net_29), 
      .sb(net_27), .y(y[3]));
  muddlib07__mux2_dp_1x mux2_1x_dp_2_(.d0(d0[2]), .d1(d1[2]), .s(net_29), 
      .sb(net_27), .y(y[2]));
  muddlib07__mux2_dp_1x mux2_1x_dp_1_(.d0(d0[1]), .d1(d1[1]), .s(net_29), 
      .sb(net_27), .y(y[1]));
  muddlib07__mux2_dp_1x mux2_1x_dp_0_(.d0(d0[0]), .d1(d1[0]), .s(net_29), 
      .sb(net_27), .y(y[0]));
endmodule   /* wordlib8__mux2_1x_8 */

module muddlib07__fulladder(a, b, c, cout, s);
  input a;
  input b;
  input c;
  output cout;
  output s;

  supply1 vdd;
  supply0 gnd;
  wire coutb, net_1, net_11, net_111, net_23, net_32, net_33, net_90, net_92;
  wire net_94, net_95, sb;

  tranif1 nmos_0(gnd, net_1, a);
  tranif1 nmos_1(gnd, net_1, b);
  tranif1 nmos_2(net_1, coutb, c);
  tranif1 nmos_3(gnd, net_11, a);
  tranif1 nmos_4(net_11, coutb, b);
  tranif1 nmos_5(gnd, net_23, a);
  tranif1 nmos_6(gnd, net_23, b);
  tranif1 nmos_7(gnd, net_23, c);
  tranif1 nmos_8(net_23, sb, coutb);
  tranif1 nmos_9(gnd, net_33, a);
  tranif1 nmos_10(net_33, net_32, b);
  tranif1 nmos_11(net_32, sb, c);
  tranif1 nmos_12(gnd, cout, coutb);
  tranif1 nmos_13(gnd, s, sb);
  tranif0 pmos_1(sb, net_92, c);
  tranif0 pmos_2(net_92, net_90, b);
  tranif0 pmos_3(net_90, vdd, a);
  tranif0 pmos_4(sb, net_94, coutb);
  tranif0 pmos_5(net_94, vdd, b);
  tranif0 pmos_6(net_94, vdd, c);
  tranif0 pmos_7(net_94, vdd, a);
  tranif0 pmos_8(cout, vdd, coutb);
  tranif0 pmos_9(net_95, vdd, a);
  tranif0 pmos_10(coutb, net_95, b);
  tranif0 pmos_11(net_111, vdd, a);
  tranif0 pmos_12(net_111, vdd, b);
  tranif0 pmos_13(coutb, net_111, c);
  tranif0 pmos_14(s, vdd, sb);
endmodule   /* muddlib07__fulladder */

module wordlib8__adder_8(a, b, cin, cout, s);
  input [7:0] a;
  input [7:0] b;
  input cin;
  output cout;
  output [7:0] s;

  supply1 vdd;
  supply0 gnd;
  wire [6:0] c;

  muddlib07__fulladder fa_7_(.a(a[7]), .b(b[7]), .c(c[6]), .cout(cout), 
      .s(s[7]));
  muddlib07__fulladder fa_6_(.a(a[6]), .b(b[6]), .c(c[5]), .cout(c[6]), 
      .s(s[6]));
  muddlib07__fulladder fa_5_(.a(a[5]), .b(b[5]), .c(c[4]), .cout(c[5]), 
      .s(s[5]));
  muddlib07__fulladder fa_4_(.a(a[4]), .b(b[4]), .c(c[3]), .cout(c[4]), 
      .s(s[4]));
  muddlib07__fulladder fa_3_(.a(a[3]), .b(b[3]), .c(c[2]), .cout(c[3]), 
      .s(s[3]));
  muddlib07__fulladder fa_2_(.a(a[2]), .b(b[2]), .c(c[1]), .cout(c[2]), 
      .s(s[2]));
  muddlib07__fulladder fa_1_(.a(a[1]), .b(b[1]), .c(c[0]), .cout(c[1]), 
      .s(s[1]));
  muddlib07__fulladder fa_0_(.a(a[0]), .b(b[0]), .c(cin), .cout(c[0]), 
      .s(s[0]));
endmodule   /* wordlib8__adder_8 */

module wordlib8__and2_1x_8(a, b, y);
  input [7:0] a;
  input [7:0] b;
  input [7:0] y;

  supply1 vdd;
  supply0 gnd;
  muddlib07__and2_1x and2_1x_7_(.a(a[7]), .b(b[7]), .y(y[7]));
  muddlib07__and2_1x and2_1x_6_(.a(a[6]), .b(b[6]), .y(y[6]));
  muddlib07__and2_1x and2_1x_5_(.a(a[5]), .b(b[5]), .y(y[5]));
  muddlib07__and2_1x and2_1x_4_(.a(a[4]), .b(b[4]), .y(y[4]));
  muddlib07__and2_1x and2_1x_3_(.a(a[3]), .b(b[3]), .y(y[3]));
  muddlib07__and2_1x and2_1x_2_(.a(a[2]), .b(b[2]), .y(y[2]));
  muddlib07__and2_1x and2_1x_1_(.a(a[1]), .b(b[1]), .y(y[1]));
  muddlib07__and2_1x and2_1x_0_(.a(a[0]), .b(b[0]), .y(y[0]));
endmodule   /* wordlib8__and2_1x_8 */

module wordlib8__inv_1x_8(a, y);
  input [7:0] a;
  output [7:0] y;

  supply1 vdd;
  supply0 gnd;
  muddlib07__inv_1x inv_1x_7_(.a(a[7]), .y(y[7]));
  muddlib07__inv_1x inv_1x_6_(.a(a[6]), .y(y[6]));
  muddlib07__inv_1x inv_1x_5_(.a(a[5]), .y(y[5]));
  muddlib07__inv_1x inv_1x_4_(.a(a[4]), .y(y[4]));
  muddlib07__inv_1x inv_1x_3_(.a(a[3]), .y(y[3]));
  muddlib07__inv_1x inv_1x_2_(.a(a[2]), .y(y[2]));
  muddlib07__inv_1x inv_1x_1_(.a(a[1]), .y(y[1]));
  muddlib07__inv_1x inv_1x_0_(.a(a[0]), .y(y[0]));
endmodule   /* wordlib8__inv_1x_8 */

module mips8__condinv(a, invert, y);
  input [7:0] a;
  input invert;
  output [7:0] y;

  supply1 vdd;
  supply0 gnd;
  wire [7:0] ab;

  wordlib8__inv_1x_8 inv_1x_8_0(.a(a[7:0]), .y(ab[7:0]));
  wordlib8__mux2_1x_8_sch mux2_1x__0(.d0(a[7:0]), .d1(ab[7:0]), .s(invert), 
      .y(y[7:0]));
endmodule   /* mips8__condinv */

module muddlib07__mux4_dp_1x(d0, d1, d2, d3, s0, s0b, s1, s1b, y);
  input d0;
  input d1;
  input d2;
  input d3;
  input s0;
  input s0b;
  input s1;
  input s1b;
  output y;

  supply1 vdd;
  supply0 gnd;
  wire net_28, net_29, net_30, net_5, net_50, net_51, net_56, net_57, net_58;
  wire net_6, net_68, net_70, net_8;

  tranif1 nmos_0(gnd, net_5, d0);
  tranif1 nmos_1(gnd, net_6, d1);
  tranif1 nmos_3(net_5, net_8, s0b);
  tranif1 nmos_4(net_6, net_8, s0);
  tranif1 nmos_5(net_8, net_50, s1b);
  tranif1 nmos_7(gnd, net_70, d3);
  tranif1 nmos_8(net_68, net_51, s0b);
  tranif1 nmos_9(net_70, net_51, s0);
  tranif1 nmos_10(net_51, net_50, s1);
  tranif1 nmos_11(gnd, net_68, d2);
  tranif1 nmos_12(gnd, y, net_50);
  tranif0 pmos_0(net_50, net_30, s1);
  tranif0 pmos_2(net_30, net_28, s0);
  tranif0 pmos_3(net_28, vdd, d0);
  tranif0 pmos_4(net_30, net_29, s0b);
  tranif0 pmos_5(net_29, vdd, d1);
  tranif0 pmos_7(net_58, net_56, s0);
  tranif0 pmos_8(net_56, vdd, d2);
  tranif0 pmos_9(net_58, net_57, s0b);
  tranif0 pmos_10(net_57, vdd, d3);
  tranif0 pmos_11(net_50, net_58, s1b);
  tranif0 pmos_12(y, vdd, net_50);
endmodule   /* muddlib07__mux4_dp_1x */

module wordlib8__mux4_1x_8(d0, d1, d2, d3, s0, s1, y);
  input [7:0] d0;
  input [7:0] d1;
  input [7:0] d2;
  input [7:0] d3;
  input s0;
  input s1;
  output [7:0] y;

  supply1 vdd;
  supply0 gnd;
  wire net_66, net_70, net_78, net_79;

  muddlib07__invbuf_4x invbuf_4_0(.s(s0), .s_out(net_66), .sb_out(net_78));
  muddlib07__invbuf_4x invbuf_4_1(.s(s1), .s_out(net_79), .sb_out(net_70));
  muddlib07__mux4_dp_1x mux4_dp_1x_7_(.d0(d0[7]), .d1(d1[7]), .d2(d2[7]), 
      .d3(d3[7]), .s0(net_66), .s0b(net_78), .s1(net_79), .s1b(net_70), 
      .y(y[7]));
  muddlib07__mux4_dp_1x mux4_dp_1x_6_(.d0(d0[6]), .d1(d1[6]), .d2(d2[6]), 
      .d3(d3[6]), .s0(net_66), .s0b(net_78), .s1(net_79), .s1b(net_70), 
      .y(y[6]));
  muddlib07__mux4_dp_1x mux4_dp_1x_5_(.d0(d0[5]), .d1(d1[5]), .d2(d2[5]), 
      .d3(d3[5]), .s0(net_66), .s0b(net_78), .s1(net_79), .s1b(net_70), 
      .y(y[5]));
  muddlib07__mux4_dp_1x mux4_dp_1x_4_(.d0(d0[4]), .d1(d1[4]), .d2(d2[4]), 
      .d3(d3[4]), .s0(net_66), .s0b(net_78), .s1(net_79), .s1b(net_70), 
      .y(y[4]));
  muddlib07__mux4_dp_1x mux4_dp_1x_3_(.d0(d0[3]), .d1(d1[3]), .d2(d2[3]), 
      .d3(d3[3]), .s0(net_66), .s0b(net_78), .s1(net_79), .s1b(net_70), 
      .y(y[3]));
  muddlib07__mux4_dp_1x mux4_dp_1x_2_(.d0(d0[2]), .d1(d1[2]), .d2(d2[2]), 
      .d3(d3[2]), .s0(net_66), .s0b(net_78), .s1(net_79), .s1b(net_70), 
      .y(y[2]));
  muddlib07__mux4_dp_1x mux4_dp_1x_1_(.d0(d0[1]), .d1(d1[1]), .d2(d2[1]), 
      .d3(d3[1]), .s0(net_66), .s0b(net_78), .s1(net_79), .s1b(net_70), 
      .y(y[1]));
  muddlib07__mux4_dp_1x mux4_dp_1x_0_(.d0(d0[0]), .d1(d1[0]), .d2(d2[0]), 
      .d3(d3[0]), .s0(net_66), .s0b(net_78), .s1(net_79), .s1b(net_70), 
      .y(y[0]));
endmodule   /* wordlib8__mux4_1x_8 */

module muddlib07__or2_1x(a, b, y);
  input a;
  input b;
  output y;

  supply1 vdd;
  supply0 gnd;
  wire net_58, net_71;

  tranif1 nmos_8(gnd, net_58, b);
  tranif1 nmos_10(gnd, y, net_58);
  tranif1 nmos_11(gnd, net_58, a);
  tranif0 pmos_2(net_58, net_71, b);
  tranif0 pmos_3(net_71, vdd, a);
  tranif0 pmos_4(y, vdd, net_58);
endmodule   /* muddlib07__or2_1x */

module wordlib8__or2_1x_8(a, b, y);
  input [7:0] a;
  input [7:0] b;
  output [7:0] y;

  supply1 vdd;
  supply0 gnd;
  muddlib07__or2_1x or2_1x_7_(.a(a[7]), .b(b[7]), .y(y[7]));
  muddlib07__or2_1x or2_1x_6_(.a(a[6]), .b(b[6]), .y(y[6]));
  muddlib07__or2_1x or2_1x_5_(.a(a[5]), .b(b[5]), .y(y[5]));
  muddlib07__or2_1x or2_1x_4_(.a(a[4]), .b(b[4]), .y(y[4]));
  muddlib07__or2_1x or2_1x_3_(.a(a[3]), .b(b[3]), .y(y[3]));
  muddlib07__or2_1x or2_1x_2_(.a(a[2]), .b(b[2]), .y(y[2]));
  muddlib07__or2_1x or2_1x_1_(.a(a[1]), .b(b[1]), .y(y[1]));
  muddlib07__or2_1x or2_1x_0_(.a(a[0]), .b(b[0]), .y(y[0]));
endmodule   /* wordlib8__or2_1x_8 */

module mips8__yzdetect_8(a, yzero);
  input [7:0] a;
  output yzero;

  supply1 vdd;
  supply0 gnd;
  wire net_0, net_12, net_15, net_3, net_6, net_9;

  muddlib07__nand2_1x nand2_1x_4(.a(net_0), .b(net_3), .y(net_12));
  muddlib07__nand2_1x nand2_1x_5(.a(net_6), .b(net_9), .y(net_15));
  muddlib07__nor2_1x nor2_1x_0(.a(a[6]), .b(a[7]), .y(net_0));
  muddlib07__nor2_1x nor2_1x_1(.a(a[5]), .b(a[4]), .y(net_3));
  muddlib07__nor2_1x nor2_1x_2(.a(a[0]), .b(a[1]), .y(net_6));
  muddlib07__nor2_1x nor2_1x_3(.a(a[2]), .b(a[3]), .y(net_9));
  muddlib07__nor2_1x nor2_1x_4(.a(net_12), .b(net_15), .y(yzero));
endmodule   /* mips8__yzdetect_8 */

module mips8__alu(a, alucontrol, b, result, zero);
  input [7:0] a;
  input [2:0] alucontrol;
  input [7:0] b;
  output [7:0] result;
  output zero;

  supply1 vdd;
  supply0 gnd;
  wire adder_8_0_cout;
  wire [7:0] andresult;
  wire [7:0] b2;
  wire [7:0] orresult;
  wire [7:0] sumresult;

  wordlib8__adder_8 adder_8_0(.a(a[7:0]), .b(b2[7:0]), .cin(alucontrol[2]), 
      .cout(adder_8_0_cout), .s(sumresult[7:0]));
  wordlib8__and2_1x_8 and2_1x__0(.a(a[7:0]), .b(b[7:0]), .y(andresult[7:0]));
  mips8__condinv condinv_0(.a(b[7:0]), .invert(alucontrol[2]), .y(b2[7:0]));
  wordlib8__mux4_1x_8 mux4_1x__0(.d0(andresult[7:0]), .d1(orresult[7:0]), 
      .d2(sumresult[7:0]), .d3({gnd, gnd, gnd, gnd, gnd, gnd, gnd, 
      sumresult[7]}), .s0(alucontrol[0]), .s1(alucontrol[1]), 
      .y(result[7:0]));
  wordlib8__or2_1x_8 or2_1x_8_0(.a(a[7:0]), .b(b[7:0]), .y(orresult[7:0]));
  mips8__yzdetect_8 yzdetect_0(.a(result[7:0]), .yzero(zero));
endmodule   /* mips8__alu */

module muddlib07__clkinvbuf_4x(ph, phb, phbuf);
  input ph;
  output phb;
  output phbuf;

  supply1 vdd;
  supply0 gnd;
  wire notph;

  tranif1 nmos_0(gnd, phb, ph);
  tranif1 nmos_1(gnd, notph, ph);
  tranif1 nmos_2(gnd, phbuf, notph);
  tranif0 pmos_0(phb, vdd, ph);
  tranif0 pmos_1(notph, vdd, ph);
  tranif0 pmos_2(phbuf, vdd, notph);
endmodule   /* muddlib07__clkinvbuf_4x */

module muddlib07__clkinvbufdual_4x(ph1, ph2, ph1b, ph1buf, ph2b, ph2buf);
  input ph1;
  input ph2;
  output ph1b;
  output ph1buf;
  output ph2b;
  output ph2buf;

  supply1 vdd;
  supply0 gnd;
  muddlib07__clkinvbuf_4x clkinvbu_1(.ph(ph1), .phb(ph1b), .phbuf(ph1buf));
  muddlib07__clkinvbuf_4x clkinvbu_2(.ph(ph2), .phb(ph2b), .phbuf(ph2buf));
endmodule   /* muddlib07__clkinvbufdual_4x */

module muddlib07__flop_dp_1x(ph1, ph1b, ph2, ph2b, d, q);
  input ph1;
  input ph1b;
  input ph2;
  input ph2b;
  input d;
  output q;

  supply1 vdd;
  supply0 gnd;
  wire master, masterinb, n6, n7, n8, n9, slaveb;
  trireg masterb, slave;

  tranif1 nmos_2(masterinb, masterb, ph2);
  tranif1 nmos_3(gnd, master, masterb);
  rtranif1 nmos_4(master, slave, ph1);
  tranif1 nmos_5(n6, masterb, ph2b);
  tranif1 nmos_6(gnd, n6, master);
  tranif1 nmos_7(gnd, n8, slaveb);
  tranif1 nmos_8(gnd, slaveb, slave);
  tranif1 nmos_10(n8, slave, ph1b);
  tranif1 nmos_11(gnd, q, slaveb);
  tranif1 nmos_19(gnd, masterinb, d);
  tranif0 pmos_2(masterb, masterinb, ph2b);
  tranif0 pmos_3(master, vdd, masterb);
  rtranif0 pmos_4(slave, master, ph1b);
  tranif0 pmos_5(masterb, n7, ph2);
  tranif0 pmos_6(n7, vdd, master);
  tranif0 pmos_7(n9, vdd, slaveb);
  tranif0 pmos_8(slaveb, vdd, slave);
  tranif0 pmos_10(slave, n9, ph1);
  tranif0 pmos_11(q, vdd, slaveb);
  tranif0 pmos_16(masterinb, vdd, d);
endmodule   /* muddlib07__flop_dp_1x */

module wordlib8__flop_1x_8(d, ph1, ph2, q);
  input [7:0] d;
  input ph1;
  input ph2;
  output [7:0] q;

  supply1 vdd;
  supply0 gnd;
  wire net_29, net_30, net_31, net_32;

  muddlib07__clkinvbufdual_4x clkinvbu_0(.ph1(ph1), .ph2(ph2), .ph1b(net_29), 
      .ph1buf(net_30), .ph2b(net_31), .ph2buf(net_32));
  muddlib07__flop_dp_1x flop_8_7_(.ph1(net_30), .ph1b(net_29), .ph2(net_32), 
      .ph2b(net_31), .d(d[7]), .q(q[7]));
  muddlib07__flop_dp_1x flop_8_6_(.ph1(net_30), .ph1b(net_29), .ph2(net_32), 
      .ph2b(net_31), .d(d[6]), .q(q[6]));
  muddlib07__flop_dp_1x flop_8_5_(.ph1(net_30), .ph1b(net_29), .ph2(net_32), 
      .ph2b(net_31), .d(d[5]), .q(q[5]));
  muddlib07__flop_dp_1x flop_8_4_(.ph1(net_30), .ph1b(net_29), .ph2(net_32), 
      .ph2b(net_31), .d(d[4]), .q(q[4]));
  muddlib07__flop_dp_1x flop_8_3_(.ph1(net_30), .ph1b(net_29), .ph2(net_32), 
      .ph2b(net_31), .d(d[3]), .q(q[3]));
  muddlib07__flop_dp_1x flop_8_2_(.ph1(net_30), .ph1b(net_29), .ph2(net_32), 
      .ph2b(net_31), .d(d[2]), .q(q[2]));
  muddlib07__flop_dp_1x flop_8_1_(.ph1(net_30), .ph1b(net_29), .ph2(net_32), 
      .ph2b(net_31), .d(d[1]), .q(q[1]));
  muddlib07__flop_dp_1x flop_8_0_(.ph1(net_30), .ph1b(net_29), .ph2(net_32), 
      .ph2b(net_31), .d(d[0]), .q(q[0]));
endmodule   /* wordlib8__flop_1x_8 */

module muddlib07__flopen_dp_1x(ph1, ph1b, ph2, ph2b, d, en, enb, q);
  input ph1;
  input ph1b;
  input ph2;
  input ph2b;
  input d;
  input en;
  input enb;
  output q;

  supply1 vdd;
  supply0 gnd;
  wire master, masterinb, n2, n3, n4, n5, n6, n7, n8, n9, slaveb;
  trireg masterb, slave;

  tranif1 nmos_2(masterinb, masterb, ph2);
  tranif1 nmos_3(gnd, master, masterb);
  rtranif1 nmos_4(master, slave, ph1);
  tranif1 nmos_5(n6, masterb, ph2b);
  tranif1 nmos_6(gnd, n6, master);
  tranif1 nmos_7(gnd, n8, slaveb);
  tranif1 nmos_8(gnd, slaveb, slave);
  tranif1 nmos_10(n8, slave, ph1b);
  tranif1 nmos_11(gnd, q, slaveb);
  tranif1 nmos_16(gnd, n2, en);
  tranif1 nmos_18(n3, gnd, enb);
  tranif1 nmos_19(n2, masterinb, d);
  tranif1 nmos_20(masterinb, n3, slave);
  tranif0 pmos_2(masterb, masterinb, ph2b);
  tranif0 pmos_3(master, vdd, masterb);
  rtranif0 pmos_4(slave, master, ph1b);
  tranif0 pmos_5(masterb, n7, ph2);
  tranif0 pmos_6(n7, vdd, master);
  tranif0 pmos_7(n9, vdd, slaveb);
  tranif0 pmos_8(slaveb, vdd, slave);
  tranif0 pmos_10(slave, n9, ph1);
  tranif0 pmos_11(q, vdd, slaveb);
  tranif0 pmos_16(masterinb, n4, d);
  tranif0 pmos_17(n4, vdd, enb);
  tranif0 pmos_19(n5, masterinb, slave);
  tranif0 pmos_20(vdd, n5, en);
endmodule   /* muddlib07__flopen_dp_1x */

module wordlib8__flopen_1x_8(d, en, ph1, ph2, q);
  input [7:0] d;
  input en;
  input ph1;
  input ph2;
  output [7:0] q;

  supply1 vdd;
  supply0 gnd;
  wire net_15, net_16, net_17, net_18, net_19, net_21;

  muddlib07__clkinvbufdual_4x clkinvbu_0(.ph1(ph1), .ph2(ph2), .ph1b(net_18), 
      .ph1buf(net_17), .ph2b(net_16), .ph2buf(net_15));
  muddlib07__flopen_dp_1x flopen_8_7_(.ph1(net_17), .ph1b(net_18), 
      .ph2(net_15), .ph2b(net_16), .d(d[7]), .en(net_21), .enb(net_19), 
      .q(q[7]));
  muddlib07__flopen_dp_1x flopen_8_6_(.ph1(net_17), .ph1b(net_18), 
      .ph2(net_15), .ph2b(net_16), .d(d[6]), .en(net_21), .enb(net_19), 
      .q(q[6]));
  muddlib07__flopen_dp_1x flopen_8_5_(.ph1(net_17), .ph1b(net_18), 
      .ph2(net_15), .ph2b(net_16), .d(d[5]), .en(net_21), .enb(net_19), 
      .q(q[5]));
  muddlib07__flopen_dp_1x flopen_8_4_(.ph1(net_17), .ph1b(net_18), 
      .ph2(net_15), .ph2b(net_16), .d(d[4]), .en(net_21), .enb(net_19), 
      .q(q[4]));
  muddlib07__flopen_dp_1x flopen_8_3_(.ph1(net_17), .ph1b(net_18), 
      .ph2(net_15), .ph2b(net_16), .d(d[3]), .en(net_21), .enb(net_19), 
      .q(q[3]));
  muddlib07__flopen_dp_1x flopen_8_2_(.ph1(net_17), .ph1b(net_18), 
      .ph2(net_15), .ph2b(net_16), .d(d[2]), .en(net_21), .enb(net_19), 
      .q(q[2]));
  muddlib07__flopen_dp_1x flopen_8_1_(.ph1(net_17), .ph1b(net_18), 
      .ph2(net_15), .ph2b(net_16), .d(d[1]), .en(net_21), .enb(net_19), 
      .q(q[1]));
  muddlib07__flopen_dp_1x flopen_8_0_(.ph1(net_17), .ph1b(net_18), 
      .ph2(net_15), .ph2b(net_16), .d(d[0]), .en(net_21), .enb(net_19), 
      .q(q[0]));
  muddlib07__invbuf_4x invbuf_4_0(.s(en), .s_out(net_21), .sb_out(net_19));
endmodule   /* wordlib8__flopen_1x_8 */

module muddlib07__mux3_dp_1x(d0, d1, d2, s0, s0b, s1, s1b, y);
  input d0;
  input d1;
  input d2;
  input s0;
  input s0b;
  input s1;
  input s1b;
  output y;

  supply1 vdd;
  supply0 gnd;
  wire net_124, net_134, net_135, net_161, net_81, net_83, net_85, net_92;
  wire net_96;

  tranif1 nmos_8(net_92, net_83, s1);
  tranif1 nmos_9(gnd, y, net_83);
  tranif1 nmos_10(gnd, net_85, d0);
  tranif1 nmos_11(gnd, net_161, d1);
  tranif1 nmos_12(gnd, net_92, d2);
  tranif1 nmos_13(net_85, net_96, s0b);
  tranif1 nmos_14(net_161, net_96, s0);
  tranif1 nmos_15(net_96, net_83, s1b);
  tranif0 pmos_8(net_124, vdd, d2);
  tranif0 pmos_9(y, vdd, net_83);
  tranif0 pmos_10(net_83, net_81, s1);
  tranif0 pmos_11(net_83, net_124, s1b);
  tranif0 pmos_12(net_81, net_134, s0);
  tranif0 pmos_13(net_134, vdd, d0);
  tranif0 pmos_14(net_81, net_135, s0b);
  tranif0 pmos_15(net_135, vdd, d1);
endmodule   /* muddlib07__mux3_dp_1x */

module wordlib8__mux3_1x_8(d0, d1, d2, s0, s1, y);
  input [7:0] d0;
  input [7:0] d1;
  input [7:0] d2;
  input s0;
  input s1;
  output [7:0] y;

  supply1 vdd;
  supply0 gnd;
  wire net_42, net_48, net_49, net_53;

  muddlib07__invbuf_4x invbuf_4_0(.s(s0), .s_out(net_42), .sb_out(net_53));
  muddlib07__invbuf_4x invbuf_4_1(.s(s1), .s_out(net_48), .sb_out(net_49));
  muddlib07__mux3_dp_1x mux3_dp_1x_7_(.d0(d0[7]), .d1(d1[7]), .d2(d2[7]), 
      .s0(net_42), .s0b(net_53), .s1(net_48), .s1b(net_49), .y(y[7]));
  muddlib07__mux3_dp_1x mux3_dp_1x_6_(.d0(d0[6]), .d1(d1[6]), .d2(d2[6]), 
      .s0(net_42), .s0b(net_53), .s1(net_48), .s1b(net_49), .y(y[6]));
  muddlib07__mux3_dp_1x mux3_dp_1x_5_(.d0(d0[5]), .d1(d1[5]), .d2(d2[5]), 
      .s0(net_42), .s0b(net_53), .s1(net_48), .s1b(net_49), .y(y[5]));
  muddlib07__mux3_dp_1x mux3_dp_1x_4_(.d0(d0[4]), .d1(d1[4]), .d2(d2[4]), 
      .s0(net_42), .s0b(net_53), .s1(net_48), .s1b(net_49), .y(y[4]));
  muddlib07__mux3_dp_1x mux3_dp_1x_3_(.d0(d0[3]), .d1(d1[3]), .d2(d2[3]), 
      .s0(net_42), .s0b(net_53), .s1(net_48), .s1b(net_49), .y(y[3]));
  muddlib07__mux3_dp_1x mux3_dp_1x_2_(.d0(d0[2]), .d1(d1[2]), .d2(d2[2]), 
      .s0(net_42), .s0b(net_53), .s1(net_48), .s1b(net_49), .y(y[2]));
  muddlib07__mux3_dp_1x mux3_dp_1x_1_(.d0(d0[1]), .d1(d1[1]), .d2(d2[1]), 
      .s0(net_42), .s0b(net_53), .s1(net_48), .s1b(net_49), .y(y[1]));
  muddlib07__mux3_dp_1x mux3_dp_1x_0_(.d0(d0[0]), .d1(d1[0]), .d2(d2[0]), 
      .s0(net_42), .s0b(net_53), .s1(net_48), .s1b(net_49), .y(y[0]));
endmodule   /* wordlib8__mux3_1x_8 */

module muddlib07__flopenr_dp_1x(ph1, ph1b, ph2, ph2b, d, en, enb, resetb, q);
  input ph1;
  input ph1b;
  input ph2;
  input ph2b;
  input d;
  input en;
  input enb;
  input resetb;
  output q;

  supply1 vdd;
  supply0 gnd;
  wire master, masterinb, n1, n2, n3, n4, n5, n6, n7, n8, n9, slaveb;
  trireg masterb, slave;

  tranif1 nmos_2(masterinb, masterb, ph2);
  tranif1 nmos_3(gnd, master, masterb);
  rtranif1 nmos_4(master, slave, ph1);
  tranif1 nmos_5(n6, masterb, ph2b);
  tranif1 nmos_6(gnd, n6, master);
  tranif1 nmos_7(gnd, n8, slaveb);
  tranif1 nmos_8(gnd, slaveb, slave);
  tranif1 nmos_10(n8, slave, ph1b);
  tranif1 nmos_11(gnd, q, slaveb);
  tranif1 nmos_16(n1, n2, en);
  tranif1 nmos_17(gnd, n1, resetb);
  tranif1 nmos_18(n3, n1, enb);
  tranif1 nmos_19(n2, masterinb, d);
  tranif1 nmos_20(masterinb, n3, slave);
  tranif0 pmos_2(masterb, masterinb, ph2b);
  tranif0 pmos_3(master, vdd, masterb);
  rtranif0 pmos_4(slave, master, ph1b);
  tranif0 pmos_5(masterb, n7, ph2);
  tranif0 pmos_6(n7, vdd, master);
  tranif0 pmos_7(n9, vdd, slaveb);
  tranif0 pmos_8(slaveb, vdd, slave);
  tranif0 pmos_10(slave, n9, ph1);
  tranif0 pmos_11(q, vdd, slaveb);
  tranif0 pmos_16(masterinb, n4, d);
  tranif0 pmos_17(n4, vdd, enb);
  tranif0 pmos_18(masterinb, vdd, resetb);
  tranif0 pmos_19(n5, masterinb, slave);
  tranif0 pmos_20(vdd, n5, en);
endmodule   /* muddlib07__flopenr_dp_1x */

module wordlib8__flopenr_1x_8(d, en, ph1, ph2, reset, q);
  input [7:0] d;
  input en;
  input ph1;
  input ph2;
  input reset;
  output [7:0] q;

  supply1 vdd;
  supply0 gnd;
  wire net_10, net_11, net_12, net_13, net_16, net_2, net_6;

  muddlib07__clkinvbufdual_4x clkinvbu_0(.ph1(ph1), .ph2(ph2), .ph1b(net_13), 
      .ph1buf(net_12), .ph2b(net_11), .ph2buf(net_10));
  muddlib07__flopenr_dp_1x flopenr_8_7_(.ph1(net_12), .ph1b(net_13), 
      .ph2(net_10), .ph2b(net_11), .d(d[7]), .en(net_16), .enb(net_2), 
      .resetb(net_6), .q(q[7]));
  muddlib07__flopenr_dp_1x flopenr_8_6_(.ph1(net_12), .ph1b(net_13), 
      .ph2(net_10), .ph2b(net_11), .d(d[6]), .en(net_16), .enb(net_2), 
      .resetb(net_6), .q(q[6]));
  muddlib07__flopenr_dp_1x flopenr_8_5_(.ph1(net_12), .ph1b(net_13), 
      .ph2(net_10), .ph2b(net_11), .d(d[5]), .en(net_16), .enb(net_2), 
      .resetb(net_6), .q(q[5]));
  muddlib07__flopenr_dp_1x flopenr_8_4_(.ph1(net_12), .ph1b(net_13), 
      .ph2(net_10), .ph2b(net_11), .d(d[4]), .en(net_16), .enb(net_2), 
      .resetb(net_6), .q(q[4]));
  muddlib07__flopenr_dp_1x flopenr_8_3_(.ph1(net_12), .ph1b(net_13), 
      .ph2(net_10), .ph2b(net_11), .d(d[3]), .en(net_16), .enb(net_2), 
      .resetb(net_6), .q(q[3]));
  muddlib07__flopenr_dp_1x flopenr_8_2_(.ph1(net_12), .ph1b(net_13), 
      .ph2(net_10), .ph2b(net_11), .d(d[2]), .en(net_16), .enb(net_2), 
      .resetb(net_6), .q(q[2]));
  muddlib07__flopenr_dp_1x flopenr_8_1_(.ph1(net_12), .ph1b(net_13), 
      .ph2(net_10), .ph2b(net_11), .d(d[1]), .en(net_16), .enb(net_2), 
      .resetb(net_6), .q(q[1]));
  muddlib07__flopenr_dp_1x flopenr_8_0_(.ph1(net_12), .ph1b(net_13), 
      .ph2(net_10), .ph2b(net_11), .d(d[0]), .en(net_16), .enb(net_2), 
      .resetb(net_6), .q(q[0]));
  muddlib07__inv_4x inv_4x_0(.a(reset), .y(net_6));
  muddlib07__invbuf_4x invbuf_4_0(.s(en), .s_out(net_16), .sb_out(net_2));
endmodule   /* wordlib8__flopenr_1x_8 */

module muddlib07__mux2_c_1x(d0, d1, s, y);
  input d0;
  input d1;
  input s;
  output y;

  supply1 vdd;
  supply0 gnd;
  wire net_12, net_15, net_3, net_4, net_5, sb;

  tranif1 nmos_0(gnd, net_3, d1);
  tranif1 nmos_1(gnd, net_4, d0);
  tranif1 nmos_2(net_3, net_5, s);
  tranif1 nmos_3(net_4, net_5, sb);
  tranif1 nmos_4(gnd, y, net_5);
  tranif1 nmos_5(gnd, sb, s);
  tranif0 pmos_0(net_5, net_15, sb);
  tranif0 pmos_1(net_15, vdd, d1);
  tranif0 pmos_2(net_5, net_12, s);
  tranif0 pmos_3(net_12, vdd, d0);
  tranif0 pmos_4(y, vdd, net_5);
  tranif0 pmos_5(sb, vdd, s);
endmodule   /* muddlib07__mux2_c_1x */

module muddlib07__nand3_1x(a, b, c, y);
  input a;
  input b;
  input c;
  output y;

  supply1 vdd;
  supply0 gnd;
  wire net_15, net_4;

  tranif1 nmos_0(net_15, net_4, b);
  tranif1 nmos_1(net_4, y, c);
  tranif1 nmos_2(gnd, net_15, a);
  tranif0 pmos_0(y, vdd, c);
  tranif0 pmos_1(y, vdd, b);
  tranif0 pmos_2(y, vdd, a);
endmodule   /* muddlib07__nand3_1x */

module muddlib07__nand5_1x(a, b, c, d, e, y);
  input a;
  input b;
  input c;
  input d;
  input e;
  output y;

  supply1 vdd;
  supply0 gnd;
  wire net_28, net_29, net_30, net_47;

  tranif1 nmos_0(net_28, net_30, b);
  tranif1 nmos_1(net_29, net_47, d);
  tranif1 nmos_2(gnd, net_28, a);
  tranif1 nmos_3(net_30, net_29, c);
  tranif1 nmos_4(net_47, y, e);
  tranif0 pmos_0(y, vdd, a);
  tranif0 pmos_1(y, vdd, b);
  tranif0 pmos_2(y, vdd, c);
  tranif0 pmos_3(y, vdd, d);
  tranif0 pmos_4(y, vdd, e);
endmodule   /* muddlib07__nand5_1x */

module mips8__regram_zipper(RegWrite, ph2, r1a, r1a_1, r1a_2, r2a, r2a_1, 
      r2a_2, wa, wa_1, wa_2, read1, read1b, read2, read2b, write, writeb);
  input RegWrite;
  input ph2;
  input [0:0] r1a;
  input [1:1] r1a_1;
  input [2:2] r1a_2;
  input [0:0] r2a;
  input [1:1] r2a_1;
  input [2:2] r2a_2;
  input [0:0] wa;
  input [1:1] wa_1;
  input [2:2] wa_2;
  output read1;
  output read1b;
  output read2;
  output read2b;
  output write;
  output writeb;

  supply1 vdd;
  supply0 gnd;
  wire net_0, net_1, net_2;

  muddlib07__invbuf_4x invbuf_4x(.s(net_0), .s_out(read1b), .sb_out(read1));
  muddlib07__invbuf_4x invbuf_4x_1(.s(net_1), .s_out(read2b), .sb_out(read2));
  muddlib07__invbuf_4x invbuf_4x_2(.s(net_2), .s_out(writeb), .sb_out(write));
  muddlib07__nand3_1x nand3_1x(.a(r1a[0]), .b(r1a_1[1]), .c(r1a_2[2]), 
      .y(net_0));
  muddlib07__nand3_1x nand3_1x_1(.a(r2a[0]), .b(r2a_1[1]), .c(r2a_2[2]), 
      .y(net_1));
  muddlib07__nand5_1x nand5_1x_1(.a(wa[0]), .b(wa_1[1]), .c(wa_2[2]), .d(ph2), 
      .e(RegWrite), .y(net_2));
endmodule   /* mips8__regram_zipper */

module mips8__regram0(read1, read2, r1, r2);
  input read1;
  input read2;
  output r1;
  output r2;

  supply0 gnd;
  tranif1 nmos_0(gnd, r1, read1);
  tranif1 nmos_1(gnd, r2, read2);
endmodule   /* mips8__regram0 */

module mips8__regramvector0_dp(RegWrite, ph2, r1a, r1a_1, r1a_2, r2a, r2a_1, 
      r2a_2, wa, wa_1, wa_2, r1, r2);
  input RegWrite;
  input ph2;
  input [0:0] r1a;
  input [1:1] r1a_1;
  input [2:2] r1a_2;
  input [0:0] r2a;
  input [1:1] r2a_1;
  input [2:2] r2a_2;
  input [0:0] wa;
  input [1:1] wa_1;
  input [2:2] wa_2;
  output [7:0] r1;
  output [7:0] r2;

  supply1 vdd;
  supply0 gnd;
  wire net_16, net_32, regfile__0_read1b, regfile__0_read2b, regfile__0_write;
  wire regfile__0_writeb;

  mips8__regram_zipper regfile__0(.RegWrite(RegWrite), .ph2(ph2), 
      .r1a(r1a[0:0]), .r1a_1(r1a_1[1:1]), .r1a_2(r1a_2[2:2]), .r2a(r2a[0:0]), 
      .r2a_1(r2a_1[1:1]), .r2a_2(r2a_2[2:2]), .wa(wa[0:0]), .wa_1(wa_1[1:1]), 
      .wa_2(wa_2[2:2]), .read1(net_32), .read1b(regfile__0_read1b), 
      .read2(net_16), .read2b(regfile__0_read2b), .write(regfile__0_write), 
      .writeb(regfile__0_writeb));
  mips8__regram0 regram_0_7_(.read1(net_32), .read2(net_16), .r1(r1[7]), 
      .r2(r2[7]));
  mips8__regram0 regram_0_6_(.read1(net_32), .read2(net_16), .r1(r1[6]), 
      .r2(r2[6]));
  mips8__regram0 regram_0_5_(.read1(net_32), .read2(net_16), .r1(r1[5]), 
      .r2(r2[5]));
  mips8__regram0 regram_0_4_(.read1(net_32), .read2(net_16), .r1(r1[4]), 
      .r2(r2[4]));
  mips8__regram0 regram_0_3_(.read1(net_32), .read2(net_16), .r1(r1[3]), 
      .r2(r2[3]));
  mips8__regram0 regram_0_2_(.read1(net_32), .read2(net_16), .r1(r1[2]), 
      .r2(r2[2]));
  mips8__regram0 regram_0_1_(.read1(net_32), .read2(net_16), .r1(r1[1]), 
      .r2(r2[1]));
  mips8__regram0 regram_0_0_(.read1(net_32), .read2(net_16), .r1(r1[0]), 
      .r2(r2[0]));
endmodule   /* mips8__regramvector0_dp */

module mips8__regram_dp(read1, read1b, read2, read2b, w, write, writeb, r1, 
      r2);
  input read1;
  input read1b;
  input read2;
  input read2b;
  input w;
  input write;
  input writeb;
  output r1;
  output r2;

  supply1 vdd;
  supply0 gnd;
  wire net_51, net_52, net_53, net_54, net_55, net_57, v, vb;

  tranif1 nmos_0(net_52, v, vb);
  tranif1 nmos_1(gnd, net_52, writeb);
  tranif1 nmos_2(gnd, vb, v);
  tranif1 nmos_3(w, v, write);
  tranif1 nmos_4(net_53, r1, read1);
  tranif1 nmos_5(net_55, r2, read2);
  tranif1 nmos_6(gnd, net_53, vb);
  tranif1 nmos_7(gnd, net_55, vb);
  tranif0 pmos_0(v, net_51, vb);
  tranif0 pmos_1(net_51, vdd, write);
  tranif0 pmos_2(vb, vdd, v);
  tranif0 pmos_3(v, w, writeb);
  tranif0 pmos_4(net_54, vdd, vb);
  tranif0 pmos_5(r1, net_54, read1b);
  tranif0 pmos_6(r2, net_57, read2b);
  tranif0 pmos_7(net_57, vdd, vb);
endmodule   /* mips8__regram_dp */

module mips8__regram_8(read1, read1b, read2, read2b, w, write, writeb, r1, 
      r2);
  input read1;
  input read1b;
  input read2;
  input read2b;
  input [7:0] w;
  input write;
  input writeb;
  output [7:0] r1;
  output [7:0] r2;

  supply1 vdd;
  supply0 gnd;
  mips8__regram_dp regram_dp_7_(.read1(read1), .read1b(read1b), .read2(read2), 
      .read2b(read2b), .w(w[7]), .write(write), .writeb(writeb), .r1(r1[7]), 
      .r2(r2[7]));
  mips8__regram_dp regram_dp_6_(.read1(read1), .read1b(read1b), .read2(read2), 
      .read2b(read2b), .w(w[6]), .write(write), .writeb(writeb), .r1(r1[6]), 
      .r2(r2[6]));
  mips8__regram_dp regram_dp_5_(.read1(read1), .read1b(read1b), .read2(read2), 
      .read2b(read2b), .w(w[5]), .write(write), .writeb(writeb), .r1(r1[5]), 
      .r2(r2[5]));
  mips8__regram_dp regram_dp_4_(.read1(read1), .read1b(read1b), .read2(read2), 
      .read2b(read2b), .w(w[4]), .write(write), .writeb(writeb), .r1(r1[4]), 
      .r2(r2[4]));
  mips8__regram_dp regram_dp_3_(.read1(read1), .read1b(read1b), .read2(read2), 
      .read2b(read2b), .w(w[3]), .write(write), .writeb(writeb), .r1(r1[3]), 
      .r2(r2[3]));
  mips8__regram_dp regram_dp_2_(.read1(read1), .read1b(read1b), .read2(read2), 
      .read2b(read2b), .w(w[2]), .write(write), .writeb(writeb), .r1(r1[2]), 
      .r2(r2[2]));
  mips8__regram_dp regram_dp_1_(.read1(read1), .read1b(read1b), .read2(read2), 
      .read2b(read2b), .w(w[1]), .write(write), .writeb(writeb), .r1(r1[1]), 
      .r2(r2[1]));
  mips8__regram_dp regram_dp_0_(.read1(read1), .read1b(read1b), .read2(read2), 
      .read2b(read2b), .w(w[0]), .write(write), .writeb(writeb), .r1(r1[0]), 
      .r2(r2[0]));
endmodule   /* mips8__regram_8 */

module mips8__regramvector_dp(RegWrite, ph2, r1a, r1a_1, r1a_2, r2a, r2a_1, 
      r2a_2, w, wa, wa_1, wa_2, r1, r2);
  input RegWrite;
  input ph2;
  input [0:0] r1a;
  input [1:1] r1a_1;
  input [2:2] r1a_2;
  input [0:0] r2a;
  input [1:1] r2a_1;
  input [2:2] r2a_2;
  input [7:0] w;
  input [0:0] wa;
  input [1:1] wa_1;
  input [2:2] wa_2;
  output [7:0] r1;
  output [7:0] r2;

  supply1 vdd;
  supply0 gnd;
  wire net_201, net_202, net_203, net_204, net_205, net_206;

  mips8__regram_zipper regfile__0(.RegWrite(RegWrite), .ph2(ph2), 
      .r1a(r1a[0:0]), .r1a_1(r1a_1[1:1]), .r1a_2(r1a_2[2:2]), .r2a(r2a[0:0]), 
      .r2a_1(r2a_1[1:1]), .r2a_2(r2a_2[2:2]), .wa(wa[0:0]), .wa_1(wa_1[1:1]), 
      .wa_2(wa_2[2:2]), .read1(net_201), .read1b(net_202), .read2(net_203), 
      .read2b(net_204), .write(net_205), .writeb(net_206));
  mips8__regram_8 regram_8_0(.read1(net_201), .read1b(net_202), 
      .read2(net_203), .read2b(net_204), .w(w[7:0]), .write(net_205), 
      .writeb(net_206), .r1(r1[7:0]), .r2(r2[7:0]));
endmodule   /* mips8__regramvector_dp */

module mips8__regramarray_dp(ph2, regwrite, w, wa, r1, r2, ra1, ra2);
  input ph2;
  input regwrite;
  input [7:0] w;
  input [2:0] wa;
  output [7:0] r1;
  output [7:0] r2;
  input [2:0] ra1;
  input [2:0] ra2;

  supply1 vdd;
  supply0 gnd;
  wire [2:0] r1a;
  wire [2:0] r1ab;
  wire [2:0] r2a;
  wire [2:0] r2ab;
  wire [2:0] wab;
  wire [2:0] wabb;

  muddlib07__invbuf_4x invbuf2_2_(.s(ra2[2]), .s_out(r2a[2]), 
      .sb_out(r2ab[2]));
  muddlib07__invbuf_4x invbuf2_1_(.s(ra2[1]), .s_out(r2a[1]), 
      .sb_out(r2ab[1]));
  muddlib07__invbuf_4x invbuf2_0_(.s(ra2[0]), .s_out(r2a[0]), 
      .sb_out(r2ab[0]));
  muddlib07__invbuf_4x invbuf3_2_(.s(ra1[2]), .s_out(r1a[2]), 
      .sb_out(r1ab[2]));
  muddlib07__invbuf_4x invbuf3_1_(.s(ra1[1]), .s_out(r1a[1]), 
      .sb_out(r1ab[1]));
  muddlib07__invbuf_4x invbuf3_0_(.s(ra1[0]), .s_out(r1a[0]), 
      .sb_out(r1ab[0]));
  muddlib07__invbuf_4x invbuf_2_(.s(wa[2]), .s_out(wabb[2]), .sb_out(wab[2]));
  muddlib07__invbuf_4x invbuf_1_(.s(wa[1]), .s_out(wabb[1]), .sb_out(wab[1]));
  muddlib07__invbuf_4x invbuf_0_(.s(wa[0]), .s_out(wabb[0]), .sb_out(wab[0]));
  mips8__regramvector0_dp regramve_0(.RegWrite(regwrite), .ph2(ph2), 
      .r1a(r1ab[0:0]), .r1a_1(r1ab[1:1]), .r1a_2(r1ab[2:2]), .r2a(r2ab[0:0]), 
      .r2a_1(r2ab[1:1]), .r2a_2(r2ab[2:2]), .wa(wab[0:0]), .wa_1(wab[1:1]), 
      .wa_2(wab[2:2]), .r1(r1[7:0]), .r2(r2[7:0]));
  mips8__regramvector_dp regramvector_dp_1_(.RegWrite(regwrite), .ph2(ph2), 
      .r1a(r1a[0:0]), .r1a_1(r1ab[1:1]), .r1a_2(r1ab[2:2]), .r2a(r2a[0:0]), 
      .r2a_1(r2ab[1:1]), .r2a_2(r2ab[2:2]), .w(w[7:0]), .wa(wabb[0:0]), 
      .wa_1(wab[1:1]), .wa_2(wab[2:2]), .r1(r1[7:0]), .r2(r2[7:0]));
  mips8__regramvector_dp regramvector_dp_2_(.RegWrite(regwrite), .ph2(ph2), 
      .r1a(r1ab[0:0]), .r1a_1(r1a[1:1]), .r1a_2(r1ab[2:2]), .r2a(r2ab[0:0]), 
      .r2a_1(r2a[1:1]), .r2a_2(r2ab[2:2]), .w(w[7:0]), .wa(wab[0:0]), 
      .wa_1(wabb[1:1]), .wa_2(wab[2:2]), .r1(r1[7:0]), .r2(r2[7:0]));
  mips8__regramvector_dp regramvector_dp_3_(.RegWrite(regwrite), .ph2(ph2), 
      .r1a(r1a[0:0]), .r1a_1(r1a[1:1]), .r1a_2(r1ab[2:2]), .r2a(r2a[0:0]), 
      .r2a_1(r2a[1:1]), .r2a_2(r2ab[2:2]), .w(w[7:0]), .wa(wabb[0:0]), 
      .wa_1(wabb[1:1]), .wa_2(wab[2:2]), .r1(r1[7:0]), .r2(r2[7:0]));
  mips8__regramvector_dp regramvector_dp_4_(.RegWrite(regwrite), .ph2(ph2), 
      .r1a(r1ab[0:0]), .r1a_1(r1ab[1:1]), .r1a_2(r1a[2:2]), .r2a(r2ab[0:0]), 
      .r2a_1(r2ab[1:1]), .r2a_2(r2a[2:2]), .w(w[7:0]), .wa(wab[0:0]), 
      .wa_1(wab[1:1]), .wa_2(wabb[2:2]), .r1(r1[7:0]), .r2(r2[7:0]));
  mips8__regramvector_dp regramvector_dp_5_(.RegWrite(regwrite), .ph2(ph2), 
      .r1a(r1a[0:0]), .r1a_1(r1ab[1:1]), .r1a_2(r1a[2:2]), .r2a(r2a[0:0]), 
      .r2a_1(r2ab[1:1]), .r2a_2(r2a[2:2]), .w(w[7:0]), .wa(wabb[0:0]), 
      .wa_1(wab[1:1]), .wa_2(wabb[2:2]), .r1(r1[7:0]), .r2(r2[7:0]));
  mips8__regramvector_dp regramvector_dp_6_(.RegWrite(regwrite), .ph2(ph2), 
      .r1a(r1ab[0:0]), .r1a_1(r1a[1:1]), .r1a_2(r1a[2:2]), .r2a(r2ab[0:0]), 
      .r2a_1(r2a[1:1]), .r2a_2(r2a[2:2]), .w(w[7:0]), .wa(wab[0:0]), 
      .wa_1(wabb[1:1]), .wa_2(wabb[2:2]), .r1(r1[7:0]), .r2(r2[7:0]));
  mips8__regramvector_dp regramvector_dp_7_(.RegWrite(regwrite), .ph2(ph2), 
      .r1a(r1a[0:0]), .r1a_1(r1a[1:1]), .r1a_2(r1a[2:2]), .r2a(r2a[0:0]), 
      .r2a_1(r2a[1:1]), .r2a_2(r2a[2:2]), .w(w[7:0]), .wa(wabb[0:0]), 
      .wa_1(wabb[1:1]), .wa_2(wabb[2:2]), .r1(r1[7:0]), .r2(r2[7:0]));
endmodule   /* mips8__regramarray_dp */

module mips8__datapath(alucontrol, alusrca, alusrcb, iord, irwrite, memdata, 
      memtoreg, pcen, pcsrc, ph1, ph2, regdst, regwrite, reset, zero, adr, 
      funct, op, writedata);
  input [2:0] alucontrol;
  input alusrca;
  input [1:0] alusrcb;
  input iord;
  input [3:0] irwrite;
  input [7:0] memdata;
  input memtoreg;
  input pcen;
  input [1:0] pcsrc;
  input ph1;
  input ph2;
  input regdst;
  input regwrite;
  input reset;
  input zero;
  output [7:0] adr;
  output [5:0] funct;
  output [5:0] op;
  output [7:0] writedata;

  supply1 vdd;
  supply0 gnd;
  wire [7:0] a;
  wire [7:0] aluout;
  wire [7:0] aluresult;
  wire [7:0] data;
  wire [25:6] instr;
  wire [7:0] net_106;
  wire [2:0] net_231;
  wire [7:0] net_82;
  wire [7:0] pc;
  wire [7:0] rd1;
  wire [7:0] rd2;
  wire [7:0] srca;
  wire [7:0] srcb;

  wordlib8__mux2_1x_8_sch adrmux(.d0(pc[7:0]), .d1(aluout[7:0]), .s(iord), 
      .y(adr[7:0]));
  mips8__alu alu_0(.a(srca[7:0]), .alucontrol(alucontrol[2:0]), .b(srcb[7:0]), 
      .result(aluresult[7:0]), .zero(zero));
  wordlib8__flop_1x_8 areg(.d(rd1[7:0]), .ph1(ph1), .ph2(ph2), .q(a[7:0]));
  wordlib8__flop_1x_8 datareg(.d(memdata[7:0]), .ph1(ph1), .ph2(ph2), 
      .q(data[7:0]));
  wordlib8__flopen_1x_8 ir0(.d(memdata[7:0]), .en(irwrite[0]), .ph1(ph1), 
      .ph2(ph2), .q({instr[7], instr[6], funct[5], funct[4], funct[3], 
      funct[2], funct[1], funct[0]}));
  wordlib8__flopen_1x_8 ir1(.d(memdata[7:0]), .en(irwrite[1]), .ph1(ph1), 
      .ph2(ph2), .q(instr[15:8]));
  wordlib8__flopen_1x_8 ir2(.d(memdata[7:0]), .en(irwrite[2]), .ph1(ph1), 
      .ph2(ph2), .q(instr[23:16]));
  wordlib8__flopen_1x_8 ir3(.d(memdata[7:0]), .en(irwrite[3]), .ph1(ph1), 
      .ph2(ph2), .q({op[5], op[4], op[3], op[2], op[1], op[0], instr[25], 
      instr[24]}));
  wordlib8__mux3_1x_8 pcmux(.d0(aluresult[7:0]), .d1(aluout[7:0]), 
      .d2({funct[5], funct[4], funct[3], funct[2], funct[1], funct[0], gnd, 
      gnd}), .s0(pcsrc[0]), .s1(pcsrc[1]), .y(net_82[7:0]));
  wordlib8__flopenr_1x_8 pcreg(.d(net_82[7:0]), .en(pcen), .ph1(ph1), 
      .ph2(ph2), .reset(reset), .q(pc[7:0]));
  muddlib07__mux2_c_1x regmux_2_(.d0(instr[18]), .d1(instr[13]), .s(regdst), 
      .y(net_231[2]));
  muddlib07__mux2_c_1x regmux_1_(.d0(instr[17]), .d1(instr[12]), .s(regdst), 
      .y(net_231[1]));
  muddlib07__mux2_c_1x regmux_0_(.d0(instr[16]), .d1(instr[11]), .s(regdst), 
      .y(net_231[0]));
  wordlib8__flop_1x_8 resreg(.d(aluresult[7:0]), .ph1(ph1), .ph2(ph2), 
      .q(aluout[7:0]));
  mips8__regramarray_dp rf(.ph2(ph2), .regwrite(regwrite), .w(net_106[7:0]), 
      .wa(net_231[2:0]), .r1(rd1[7:0]), .r2(rd2[7:0]), .ra1(instr[23:21]), 
      .ra2(instr[18:16]));
  wordlib8__mux2_1x_8_sch src1mux(.d0(pc[7:0]), .d1(a[7:0]), .s(alusrca), 
      .y(srca[7:0]));
  wordlib8__mux4_1x_8 src2mux(.d0(writedata[7:0]), .d1({gnd, gnd, gnd, gnd, 
      gnd, gnd, gnd, vdd}), .d2({instr[7], instr[6], funct[5], funct[4], 
      funct[3], funct[2], funct[1], funct[0]}), .d3({funct[5], funct[4], 
      funct[3], funct[2], funct[1], funct[0], gnd, gnd}), .s0(alusrcb[0]), 
      .s1(alusrcb[1]), .y(srcb[7:0]));
  wordlib8__mux2_1x_8_sch wdmux(.d0(aluout[7:0]), .d1(data[7:0]), .s(memtoreg), 
      .y(net_106[7:0]));
  wordlib8__flop_1x_8 wrdreg(.d(rd2[7:0]), .ph1(ph1), .ph2(ph2), 
      .q(writedata[7:0]));
endmodule   /* mips8__datapath */

module mips(memdata, ph1, ph2, reset, adr, memread, memwrite, writedata);
  input [7:0] memdata;
  input ph1;
  input ph2;
  input reset;
  output [7:0] adr;
  output memread;
  output memwrite;
  output [7:0] writedata;

  supply1 vdd;
  supply0 gnd;
  wire alusrca, iord, memtoreg, net_64, net_68, net_78, net_86, pcen, regdst;
  wire regwrite, zero;
  wire [2:0] alucontrol;
  wire [1:0] alusrcb;
  wire [5:0] funct;
  wire [3:0] irwrite;
  wire [7:0] net_75;
  wire [7:0] net_83;
  wire [7:0] net_90;
  wire [5:0] op;
  wire [1:0] pcsrc;

  vlsi__cache cache_0(.address(adr[7:0]), .clk(ph1), .data_in(net_75[7:0]), 
      .we(net_68), .data_out(net_90[7:0]), .hit(net_64));
 
/*
 mips8__controller controll_0(.funct(funct[3:0]), .hit(net_64), .op(op[5:0]), 
      .ph1(ph1), .ph2(ph2), .reset(reset), .zero(zero), 
      .alucontrol(alucontrol[2:0]), .alusrca(alusrca), .alusrcb(alusrcb[1:0]), 
      .cachewrite(net_68), .iord(iord), .irwrite(irwrite[3:0]), 
      .memread(memread), .memtoreg(memtoreg), .memwrite(memwrite), 
      .morc(net_86), .morw(net_78), .pcen(pcen), .pcsrc(pcsrc[1:0]), 
      .regdst(regdst), .regwrite(regwrite));
	  
	  */
	  
  opcode op0;	  
  functcode funct0;
  assign op0 = opcode'(op);
  assign funct0 = functcode'(funct);
	  
	     controller_plabased  controll_0(ph1, reset, net_64, op0, funct0, zero, memread, memwrite, net_68, net_86, net_78,
                    alusrca, memtoreg, iord, pcen, regwrite, regdst,
                    pcsrc, alusrcb, alucontrol, irwrite);
/*  mips8__datapath datapath_0(.alucontrol(alucontrol[2:0]), .alusrca(alusrca), 
      .alusrcb(alusrcb[1:0]), .iord(iord), .irwrite(irwrite[3:0]), 
      .memdata(net_83[7:0]), .memtoreg(memtoreg), .pcen(pcen), 
      .pcsrc(pcsrc[1:0]), .ph1(ph1), .ph2(ph2), .regdst(regdst), 
      .regwrite(regwrite), .reset(reset), .zero(zero), .adr(adr[7:0]), 
      .funct(funct[5:0]), .op(op[5:0]), .writedata(writedata[7:0]));
 */
 /*
  datapath    datapath_0(alucontrol[0], alucontrol[1], alucontrol[2], alusrca, alusrcb[0], 
      alusrcb[1], iord, irwrite[0], irwrite[1], irwrite[2], irwrite[3], net_83[0], 
      net_83[1], net_83[2], net_83[3], net_83[4], net_83[5], net_83[6], 
      net_83[7], memtoreg, pcen, pcsrc[0], pcsrc[1], ph1, ph2, regdst, regwrite, 
      reset, adr[0], adr[1], adr[2], adr[3], adr[4], adr[5], adr[6], adr[7], funct[0], 
      funct[1], funct[2], funct[3], funct[4], funct[5], op[0], op[1], op[2], op[3], op[4], 
      op[5], writedata[0], writedata[1], writedata[2], writedata[3], writedata[4], 
      writedata[5], writedata[6], writedata[7], zero, vdd, gnd);
	*/  
	     datapath0    #(8, 3) 
               dp(ph1, reset, net_83, alusrca, memtoreg, iord, pcen,
                  regwrite, regdst, pcsrc, alusrcb, irwrite, alucontrol,
                  zero, op, funct, adr, writedata);
	  
  wordlib8__mux2_1x_8_sch mux2_1x__0(.d0(memdata[7:0]), .d1(writedata[7:0]), 
      .s(net_78), .y(net_75[7:0]));
  wordlib8__mux2_1x_8_sch mux2_1x__1(.d0(memdata[7:0]), .d1(net_90[7:0]), 
      .s(net_86), .y(net_83[7:0]));
endmodule   /* mips */


/* Verilog for cell 'datapath{lay}' from library 'mips8' */
/* Created on Thu Jul 12, 2007 12:24:38 */
/* Last revised on Tue Sep 16, 2014 16:53:10 */
/* Written on Tue Sep 16, 2014 16:54:39 by Electric VLSI Design System, version 8.06 */

module muddlib07__invbuf_4x(s, s_out, sb_out, vdd, gnd);
  input s;
  output s_out;
  output sb_out;
  input vdd;
  input gnd;

  supply1 vdd;
  supply0 gnd;
  wire plnode_0_well, plnode_1_well;

  tranif1 nmos_0(gnd, sb_out, s);
  tranif1 nmos_1(gnd, s_out, sb_out);
  tranif0 pmos_0(vdd, sb_out, s);
  tranif0 pmos_1(vdd, s_out, sb_out);
endmodule   /* muddlib07__invbuf_4x */

module muddlib07__mux2_dp_1x(d0, d1, s, sb, y, vdd, gnd);
  input d0;
  input d1;
  input s;
  input sb;
  output y;
  input vdd;
  input gnd;

  supply1 vdd;
  supply0 gnd;
  wire net_186, net_187, net_188, net_189, net_80, plnode_2_well, plnode_3_well;

  tranif1 nmos_1(gnd, net_189, d1);
  tranif1 nmos_2(net_189, net_80, s);
  tranif1 nmos_3(net_80, net_188, sb);
  tranif1 nmos_4(net_188, gnd, d0);
  tranif1 nmos_5(gnd, y, net_80);
  tranif0 pmos_0(vdd, net_187, d1);
  tranif0 pmos_1(net_187, net_80, sb);
  tranif0 pmos_2(net_80, net_186, s);
  tranif0 pmos_3(net_186, vdd, d0);
  tranif0 pmos_4(vdd, y, net_80);
endmodule   /* muddlib07__mux2_dp_1x */

module wordlib8__mux2_1x_8(d0, d0_1, d0_2, d0_3, d0_4, d0_5, d0_6, d0_7, d1, 
      d1_1, d1_2, d1_3, d1_4, d1_5, d1_6, d1_7, s, y, y_1, y_2, y_3, y_4, y_5, 
      y_6, y_7, vdd, vdd_1, vdd_32, vdd_33, vdd_34, vdd_35, vdd_36, vdd_37, 
      vdd_38, gnd, gnd_1, gnd_32, gnd_33, gnd_34, gnd_35, gnd_36, gnd_37, 
      gnd_38);
  input [0:0] d0;
  input [1:1] d0_1;
  input [2:2] d0_2;
  input [3:3] d0_3;
  input [4:4] d0_4;
  input [5:5] d0_5;
  input [6:6] d0_6;
  input [7:7] d0_7;
  input [0:0] d1;
  input [1:1] d1_1;
  input [2:2] d1_2;
  input [3:3] d1_3;
  input [4:4] d1_4;
  input [5:5] d1_5;
  input [6:6] d1_6;
  input [7:7] d1_7;
  input s;
  output [0:0] y;
  output [1:1] y_1;
  output [2:2] y_2;
  output [3:3] y_3;
  output [4:4] y_4;
  output [5:5] y_5;
  output [6:6] y_6;
  output [7:7] y_7;
  input vdd;
  input vdd_1;
  input vdd_32;
  input vdd_33;
  input vdd_34;
  input vdd_35;
  input vdd_36;
  input vdd_37;
  input vdd_38;
  input gnd;
  input gnd_1;
  input gnd_32;
  input gnd_33;
  input gnd_34;
  input gnd_35;
  input gnd_36;
  input gnd_37;
  input gnd_38;

  supply1 vdd;
  supply0 gnd;
  wire net_67, net_74;

  muddlib07__invbuf_4x invbuf_4_0(.s(s), .s_out(net_74), .sb_out(net_67), 
      .vdd(vdd_32), .gnd(gnd_32));
  muddlib07__mux2_dp_1x mux2_dp__0(.d0(d0[0]), .d1(d1[0]), .s(net_74), 
      .sb(net_67), .y(y[0]), .vdd(vdd_1), .gnd(gnd_1));
  muddlib07__mux2_dp_1x mux2_dp__32(.d0(d0_1[1]), .d1(d1_1[1]), .s(net_74), 
      .sb(net_67), .y(y_1[1]), .vdd(vdd_33), .gnd(gnd_33));
  muddlib07__mux2_dp_1x mux2_dp__33(.d0(d0_2[2]), .d1(d1_2[2]), .s(net_74), 
      .sb(net_67), .y(y_2[2]), .vdd(vdd_34), .gnd(gnd_34));
  muddlib07__mux2_dp_1x mux2_dp__34(.d0(d0_3[3]), .d1(d1_3[3]), .s(net_74), 
      .sb(net_67), .y(y_3[3]), .vdd(vdd_35), .gnd(gnd_35));
  muddlib07__mux2_dp_1x mux2_dp__35(.d0(d0_4[4]), .d1(d1_4[4]), .s(net_74), 
      .sb(net_67), .y(y_4[4]), .vdd(vdd_36), .gnd(gnd_36));
  muddlib07__mux2_dp_1x mux2_dp__36(.d0(d0_5[5]), .d1(d1_5[5]), .s(net_74), 
      .sb(net_67), .y(y_5[5]), .vdd(vdd_37), .gnd(gnd_37));
  muddlib07__mux2_dp_1x mux2_dp__37(.d0(d0_6[6]), .d1(d1_6[6]), .s(net_74), 
      .sb(net_67), .y(y_6[6]), .vdd(vdd_38), .gnd(gnd_38));
  muddlib07__mux2_dp_1x mux2_dp__38(.d0(d0_7[7]), .d1(d1_7[7]), .s(net_74), 
      .sb(net_67), .y(y_7[7]), .vdd(vdd), .gnd(gnd));
endmodule   /* wordlib8__mux2_1x_8 */

module muddlib07__fulladder(a, b, c, cout, s, vdd, gnd);
  input a;
  input b;
  input c;
  output cout;
  output s;
  input vdd;
  input gnd;

  supply1 vdd;
  supply0 gnd;
  wire coutb, net_10, net_11, net_122, net_123, net_124, net_13, net_134;
  wire net_135, net_27, net_30, plnode_0_well, plnode_1_well, plnode_2_well;
  wire plnode_3_well, sumb;

  tranif1 nmos_0(gnd, cout, coutb);
  tranif1 nmos_1(gnd, s, sumb);
  tranif1 nmos_2(net_124, gnd, a);
  tranif1 nmos_3(net_122, net_124, b);
  tranif1 nmos_4(sumb, net_122, c);
  tranif1 nmos_5(net_123, sumb, coutb);
  tranif1 nmos_6(gnd, net_123, c);
  tranif1 nmos_7(net_123, gnd, b);
  tranif1 nmos_8(gnd, net_123, a);
  tranif1 nmos_9(net_134, gnd, a);
  tranif1 nmos_10(coutb, net_134, b);
  tranif1 nmos_11(net_135, coutb, c);
  tranif1 nmos_12(gnd, net_135, b);
  tranif1 nmos_13(net_135, gnd, a);
  tranif0 pmos_0(vdd, cout, coutb);
  tranif0 pmos_1(vdd, s, sumb);
  tranif0 pmos_2(net_10, vdd, a);
  tranif0 pmos_3(net_11, net_10, b);
  tranif0 pmos_4(sumb, net_11, c);
  tranif0 pmos_5(net_27, sumb, coutb);
  tranif0 pmos_6(vdd, net_27, c);
  tranif0 pmos_7(net_27, vdd, b);
  tranif0 pmos_8(vdd, net_27, a);
  tranif0 pmos_9(net_13, vdd, a);
  tranif0 pmos_10(coutb, net_13, b);
  tranif0 pmos_11(net_30, coutb, c);
  tranif0 pmos_12(vdd, net_30, b);
  tranif0 pmos_13(net_30, vdd, a);
endmodule   /* muddlib07__fulladder */

module wordlib8__adder_8(a, a_1, a_2, a_3, a_4, a_5, a_6, a_7, b, b_1, b_2, 
      b_3, b_4, b_5, b_6, b_7, cin, cout, s, s_1, s_2, s_3, s_4, s_5, s_6, s_7, 
      vdd, vdd_1, vdd_1_1, vdd_2, vdd_3, vdd_4, vdd_5, vdd_6, gnd, gnd_1, 
      gnd_1_1, gnd_2, gnd_3, gnd_4, gnd_5, gnd_6);
  input [0:0] a;
  input [1:1] a_1;
  input [2:2] a_2;
  input [3:3] a_3;
  input [4:4] a_4;
  input [5:5] a_5;
  input [6:6] a_6;
  input [7:7] a_7;
  input [0:0] b;
  input [1:1] b_1;
  input [2:2] b_2;
  input [3:3] b_3;
  input [4:4] b_4;
  input [5:5] b_5;
  input [6:6] b_6;
  input [7:7] b_7;
  input cin;
  output cout;
  output [0:0] s;
  output [1:1] s_1;
  output [2:2] s_2;
  output [3:3] s_3;
  output [4:4] s_4;
  output [5:5] s_5;
  output [6:6] s_6;
  output [7:7] s_7;
  input vdd;
  input vdd_1;
  input vdd_1_1;
  input vdd_2;
  input vdd_3;
  input vdd_4;
  input vdd_5;
  input vdd_6;
  input gnd;
  input gnd_1;
  input gnd_1_1;
  input gnd_2;
  input gnd_3;
  input gnd_4;
  input gnd_5;
  input gnd_6;

  supply1 vdd;
  supply0 gnd;
  wire net_0, net_1, net_2, net_3, net_30, net_4, net_5;

  muddlib07__fulladder fulladde_0(.a(a[0]), .b(b[0]), .c(cin), .cout(net_0), 
      .s(s[0]), .vdd(vdd_1), .gnd(gnd_1));
  muddlib07__fulladder fulladde_1(.a(a_1[1]), .b(b_1[1]), .c(net_0), 
      .cout(net_30), .s(s_1[1]), .vdd(vdd_1_1), .gnd(gnd_1_1));
  muddlib07__fulladder fulladde_2(.a(a_2[2]), .b(b_2[2]), .c(net_30), 
      .cout(net_1), .s(s_2[2]), .vdd(vdd_2), .gnd(gnd_2));
  muddlib07__fulladder fulladde_3(.a(a_3[3]), .b(b_3[3]), .c(net_1), 
      .cout(net_2), .s(s_3[3]), .vdd(vdd_3), .gnd(gnd_3));
  muddlib07__fulladder fulladde_4(.a(a_4[4]), .b(b_4[4]), .c(net_2), 
      .cout(net_3), .s(s_4[4]), .vdd(vdd_4), .gnd(gnd_4));
  muddlib07__fulladder fulladde_5(.a(a_5[5]), .b(b_5[5]), .c(net_3), 
      .cout(net_4), .s(s_5[5]), .vdd(vdd_5), .gnd(gnd_5));
  muddlib07__fulladder fulladde_6(.a(a_6[6]), .b(b_6[6]), .c(net_4), 
      .cout(net_5), .s(s_6[6]), .vdd(vdd_6), .gnd(gnd_6));
  muddlib07__fulladder fulladde_7(.a(a_7[7]), .b(b_7[7]), .c(net_5), 
      .cout(cout), .s(s_7[7]), .vdd(vdd), .gnd(gnd));
endmodule   /* wordlib8__adder_8 */

module muddlib07__and2_1x(a, b, y, vdd, gnd);
  input a;
  input b;
  output y;
  input vdd;
  input gnd;

  supply1 vdd;
  supply0 gnd;
  wire net_72, net_73, plno_2_well, plnode_0_well;

  tranif1 nmos_0(gnd, net_72, a);
  tranif1 nmos_1(net_72, net_73, b);
  tranif1 nmos_2(y, gnd, net_73);
  tranif0 pmos_0(vdd, net_73, a);
  tranif0 pmos_1(net_73, vdd, b);
  tranif0 pmos_2(y, vdd, net_73);
endmodule   /* muddlib07__and2_1x */

module wordlib8__and2_1x_8(a, a_1, a_2, a_3, a_4, a_5, a_6, a_7, b, b_1, b_2, 
      b_3, b_4, b_5, b_6, b_7, y, y_1, y_2, y_3, y_4, y_5, y_6, y_7, vdd, 
      vdd_1, vdd_1_1, vdd_2, vdd_3, vdd_4, vdd_5, vdd_6, gnd, gnd_1, gnd_1_1, 
      gnd_2, gnd_3, gnd_4, gnd_5, gnd_6);
  input [0:0] a;
  input [1:1] a_1;
  input [2:2] a_2;
  input [3:3] a_3;
  input [4:4] a_4;
  input [5:5] a_5;
  input [6:6] a_6;
  input [7:7] a_7;
  input [0:0] b;
  input [1:1] b_1;
  input [2:2] b_2;
  input [3:3] b_3;
  input [4:4] b_4;
  input [5:5] b_5;
  input [6:6] b_6;
  input [7:7] b_7;
  output [0:0] y;
  output [1:1] y_1;
  output [2:2] y_2;
  output [3:3] y_3;
  output [4:4] y_4;
  output [5:5] y_5;
  output [6:6] y_6;
  output [7:7] y_7;
  input vdd;
  input vdd_1;
  input vdd_1_1;
  input vdd_2;
  input vdd_3;
  input vdd_4;
  input vdd_5;
  input vdd_6;
  input gnd;
  input gnd_1;
  input gnd_1_1;
  input gnd_2;
  input gnd_3;
  input gnd_4;
  input gnd_5;
  input gnd_6;

  supply1 vdd;
  supply0 gnd;
  muddlib07__and2_1x and2_1x_0_(.a(a[0]), .b(b[0]), .y(y[0]), .vdd(vdd), 
      .gnd(gnd_1));
  muddlib07__and2_1x and2_1x_1_(.a(a_1[1]), .b(b_1[1]), .y(y_1[1]), 
      .vdd(vdd_1_1), .gnd(gnd_1_1));
  muddlib07__and2_1x and2_1x_2_(.a(a_2[2]), .b(b_2[2]), .y(y_2[2]), 
      .vdd(vdd_2), .gnd(gnd_2));
  muddlib07__and2_1x and2_1x_3_(.a(a_3[3]), .b(b_3[3]), .y(y_3[3]), 
      .vdd(vdd_3), .gnd(gnd_3));
  muddlib07__and2_1x and2_1x_4_(.a(a_4[4]), .b(b_4[4]), .y(y_4[4]), 
      .vdd(vdd_4), .gnd(gnd_4));
  muddlib07__and2_1x and2_1x_5_(.a(a_5[5]), .b(b_5[5]), .y(y_5[5]), 
      .vdd(vdd_5), .gnd(gnd_5));
  muddlib07__and2_1x and2_1x_6_(.a(a_6[6]), .b(b_6[6]), .y(y_6[6]), 
      .vdd(vdd_6), .gnd(gnd_6));
  muddlib07__and2_1x and2_1x_7_(.a(a_7[7]), .b(b_7[7]), .y(y_7[7]), 
      .vdd(vdd_1), .gnd(gnd));
endmodule   /* wordlib8__and2_1x_8 */

module muddlib07__inv_1x(a, y, vdd, gnd);
  input a;
  output y;
  input vdd;
  input gnd;

  supply1 vdd;
  supply0 gnd;
  wire plnode_0_well, plnode_1_well;

  tranif1 nmos_0(gnd, y, a);
  tranif0 pmos_0(vdd, y, a);
endmodule   /* muddlib07__inv_1x */

module wordlib8__inv_1x_8(a, a_1, a_2, a_3, a_4, a_5, a_6, a_7, y, y_1, y_2, 
      y_3, y_4, y_5, y_6, y_7, vdd, vdd_1, vdd_1_1, vdd_2, vdd_3, vdd_4, vdd_5, 
      vdd_6, gnd, gnd_1, gnd_1_1, gnd_2, gnd_3, gnd_4, gnd_5, gnd_6);
  input [0:0] a;
  input [1:1] a_1;
  input [2:2] a_2;
  input [3:3] a_3;
  input [4:4] a_4;
  input [5:5] a_5;
  input [6:6] a_6;
  input [7:7] a_7;
  output [0:0] y;
  output [1:1] y_1;
  output [2:2] y_2;
  output [3:3] y_3;
  output [4:4] y_4;
  output [5:5] y_5;
  output [6:6] y_6;
  output [7:7] y_7;
  input vdd;
  input vdd_1;
  input vdd_1_1;
  input vdd_2;
  input vdd_3;
  input vdd_4;
  input vdd_5;
  input vdd_6;
  input gnd;
  input gnd_1;
  input gnd_1_1;
  input gnd_2;
  input gnd_3;
  input gnd_4;
  input gnd_5;
  input gnd_6;

  supply1 vdd;
  supply0 gnd;
  muddlib07__inv_1x inv_1x_0(.a(a[0]), .y(y[0]), .vdd(vdd), .gnd(gnd_1));
  muddlib07__inv_1x inv_1x_1(.a(a_1[1]), .y(y_1[1]), .vdd(vdd_1_1), 
      .gnd(gnd_1_1));
  muddlib07__inv_1x inv_1x_2(.a(a_2[2]), .y(y_2[2]), .vdd(vdd_2), 
      .gnd(gnd_2));
  muddlib07__inv_1x inv_1x_3(.a(a_3[3]), .y(y_3[3]), .vdd(vdd_3), 
      .gnd(gnd_3));
  muddlib07__inv_1x inv_1x_4(.a(a_4[4]), .y(y_4[4]), .vdd(vdd_4), 
      .gnd(gnd_4));
  muddlib07__inv_1x inv_1x_5(.a(a_5[5]), .y(y_5[5]), .vdd(vdd_5), 
      .gnd(gnd_5));
  muddlib07__inv_1x inv_1x_6(.a(a_6[6]), .y(y_6[6]), .vdd(vdd_6), 
      .gnd(gnd_6));
  muddlib07__inv_1x inv_1x_7(.a(a_7[7]), .y(y_7[7]), .vdd(vdd_1), .gnd(gnd));
endmodule   /* wordlib8__inv_1x_8 */

module mips8__condinv(a, a_1, a_2, a_3, a_4, a_5, a_6, a_7, invert, y, y_1, 
      y_2, y_3, y_4, y_5, y_6, y_7, vdd, vdd_1, vdd_32, vdd_33, vdd_34, vdd_35, 
      vdd_36, vdd_37, vdd_38, gnd, gnd_1, gnd_32, gnd_33, gnd_34, gnd_35, 
      gnd_36, gnd_37, gnd_38);
  input [0:0] a;
  input [1:1] a_1;
  input [2:2] a_2;
  input [3:3] a_3;
  input [4:4] a_4;
  input [5:5] a_5;
  input [6:6] a_6;
  input [7:7] a_7;
  input invert;
  output [0:0] y;
  output [1:1] y_1;
  output [2:2] y_2;
  output [3:3] y_3;
  output [4:4] y_4;
  output [5:5] y_5;
  output [6:6] y_6;
  output [7:7] y_7;
  input vdd;
  input vdd_1;
  input vdd_32;
  input vdd_33;
  input vdd_34;
  input vdd_35;
  input vdd_36;
  input vdd_37;
  input vdd_38;
  input gnd;
  input gnd_1;
  input gnd_32;
  input gnd_33;
  input gnd_34;
  input gnd_35;
  input gnd_36;
  input gnd_37;
  input gnd_38;

  supply1 vdd;
  supply0 gnd;
  wire net_16, net_18, net_19, net_20, net_21, net_22, net_23, net_24;

  wordlib8__inv_1x_8 inv_1x_8_0(.a(a[0:0]), .a_1(a_1[1:1]), .a_2(a_2[2:2]), 
      .a_3(a_3[3:3]), .a_4(a_4[4:4]), .a_5(a_5[5:5]), .a_6(a_6[6:6]), 
      .a_7(a_7[7:7]), .y({net_16}), .y_1({net_18}), .y_2({net_19}), 
      .y_3({net_20}), .y_4({net_21}), .y_5({net_22}), .y_6({net_23}), 
      .y_7({net_24}), .vdd(vdd), .vdd_1(vdd_1), .vdd_1_1(vdd_33), 
      .vdd_2(vdd_34), .vdd_3(vdd_35), .vdd_4(vdd_36), .vdd_5(vdd_37), 
      .vdd_6(vdd_38), .gnd(gnd_33), .gnd_1(gnd_1), .gnd_1_1(gnd), 
      .gnd_2(gnd_38), .gnd_3(gnd_37), .gnd_4(gnd_36), .gnd_5(gnd_35), 
      .gnd_6(gnd_34));
  wordlib8__mux2_1x_8 mux2_1x__0(.d0(a[0:0]), .d0_1(a_1[1:1]), .d0_2(a_2[2:2]), 
      .d0_3(a_3[3:3]), .d0_4(a_4[4:4]), .d0_5(a_5[5:5]), .d0_6(a_6[6:6]), 
      .d0_7(a_7[7:7]), .d1({net_16}), .d1_1({net_18}), .d1_2({net_19}), 
      .d1_3({net_20}), .d1_4({net_21}), .d1_5({net_22}), .d1_6({net_23}), 
      .d1_7({net_24}), .s(invert), .y(y[0:0]), .y_1(y_1[1:1]), .y_2(y_2[2:2]), 
      .y_3(y_3[3:3]), .y_4(y_4[4:4]), .y_5(y_5[5:5]), .y_6(y_6[6:6]), 
      .y_7(y_7[7:7]), .vdd(vdd_1), .vdd_1(vdd), .vdd_32(vdd_32), 
      .vdd_33(vdd_33), .vdd_34(vdd_34), .vdd_35(vdd_35), .vdd_36(vdd_36), 
      .vdd_37(vdd_37), .vdd_38(vdd_38), .gnd(gnd_33), .gnd_1(gnd_1), 
      .gnd_32(gnd_32), .gnd_33(gnd), .gnd_34(gnd_38), .gnd_35(gnd_37), 
      .gnd_36(gnd_36), .gnd_37(gnd_35), .gnd_38(gnd_34));
endmodule   /* mips8__condinv */

module muddlib07__mux4_dp_1x(d0, d1, d2, d3, s0, s0b, s1, s1b, y, vdd, gnd);
  input d0;
  input d1;
  input d2;
  input d3;
  input s0;
  input s0b;
  input s1;
  input s1b;
  output y;
  input vdd;
  input gnd;

  supply1 vdd;
  supply0 gnd;
  wire net_306, net_318, net_338, net_390, net_501, net_835, net_856, net_857;
  wire net_858, net_880, net_902, net_904, net_907, plno_2_well, plnode_0_well;

  tranif1 nmos_6(gnd, y, net_835);
  tranif1 nmos_7(net_338, net_318, s0b);
  tranif1 nmos_8(net_318, gnd, d0);
  tranif1 nmos_9(gnd, net_880, d1);
  tranif1 nmos_10(net_880, net_338, s0);
  tranif1 nmos_12(net_338, net_835, s1b);
  tranif1 nmos_13(net_835, net_902, s1);
  tranif1 nmos_18(net_902, net_904, s0b);
  tranif1 nmos_19(net_904, gnd, d2);
  tranif1 nmos_20(gnd, net_907, d3);
  tranif1 nmos_21(net_907, net_902, s0);
  tranif0 pmos_5(vdd, y, net_835);
  tranif0 pmos_7(net_306, net_390, s0);
  tranif0 pmos_9(net_390, vdd, d0);
  tranif0 pmos_18(vdd, net_501, d1);
  tranif0 pmos_20(net_501, net_306, s0b);
  tranif0 pmos_21(net_306, net_835, s1);
  tranif0 pmos_22(net_835, net_856, s1b);
  tranif0 pmos_23(vdd, net_858, d3);
  tranif0 pmos_24(net_858, net_856, s0b);
  tranif0 pmos_25(net_856, net_857, s0);
  tranif0 pmos_26(net_857, vdd, d2);
endmodule   /* muddlib07__mux4_dp_1x */

module wordlib8__mux4_1x_8(d0, d0_1, d0_2, d0_3, d0_4, d0_5, d0_6, d0_7, d1, 
      d1_1, d1_2, d1_3, d1_4, d1_5, d1_6, d1_7, d2, d2_1, d2_2, d2_3, d2_4, 
      d2_5, d2_6, d2_7, d3, d3_1, d3_2, d3_3, d3_4, d3_5, d3_6, d3_7, s0, s1, 
      y, y_1, y_2, y_3, y_4, y_5, y_6, y_7, vdd, vdd_1, vdd_2, vdd_34, vdd_35, 
      vdd_36, vdd_37, vdd_38, vdd_39, gnd, gnd_1, gnd_2, gnd_34, gnd_35, 
      gnd_36, gnd_37, gnd_38, gnd_39);
  input [0:0] d0;
  input [1:1] d0_1;
  input [2:2] d0_2;
  input [3:3] d0_3;
  input [4:4] d0_4;
  input [5:5] d0_5;
  input [6:6] d0_6;
  input [7:7] d0_7;
  input [0:0] d1;
  input [1:1] d1_1;
  input [2:2] d1_2;
  input [3:3] d1_3;
  input [4:4] d1_4;
  input [5:5] d1_5;
  input [6:6] d1_6;
  input [7:7] d1_7;
  input [0:0] d2;
  input [1:1] d2_1;
  input [2:2] d2_2;
  input [3:3] d2_3;
  input [4:4] d2_4;
  input [5:5] d2_5;
  input [6:6] d2_6;
  input [7:7] d2_7;
  input [0:0] d3;
  input [1:1] d3_1;
  input [2:2] d3_2;
  input [3:3] d3_3;
  input [4:4] d3_4;
  input [5:5] d3_5;
  input [6:6] d3_6;
  input [7:7] d3_7;
  input s0;
  input s1;
  output [0:0] y;
  output [1:1] y_1;
  output [2:2] y_2;
  output [3:3] y_3;
  output [4:4] y_4;
  output [5:5] y_5;
  output [6:6] y_6;
  output [7:7] y_7;
  input vdd;
  input vdd_1;
  input vdd_2;
  input vdd_34;
  input vdd_35;
  input vdd_36;
  input vdd_37;
  input vdd_38;
  input vdd_39;
  input gnd;
  input gnd_1;
  input gnd_2;
  input gnd_34;
  input gnd_35;
  input gnd_36;
  input gnd_37;
  input gnd_38;
  input gnd_39;

  supply1 vdd;
  supply0 gnd;
  wire net_14, net_174, net_181, net_8;

  muddlib07__invbuf_4x invbuf_4_0(.s(s0), .s_out(net_181), .sb_out(net_8), 
      .vdd(vdd_1), .gnd(gnd));
  muddlib07__invbuf_4x invbuf_4_1(.s(s1), .s_out(net_174), .sb_out(net_14), 
      .vdd(vdd_1), .gnd(gnd));
  muddlib07__mux4_dp_1x mux4_dp__0(.d0(d0[0]), .d1(d1[0]), .d2(d2[0]), 
      .d3(d3[0]), .s0(net_181), .s0b(net_8), .s1(net_174), .s1b(net_14), 
      .y(y[0]), .vdd(vdd_2), .gnd(gnd_2));
  muddlib07__mux4_dp_1x mux4_dp__32(.d0(d0_1[1]), .d1(d1_1[1]), .d2(d2_1[1]), 
      .d3(d3_1[1]), .s0(net_181), .s0b(net_8), .s1(net_174), .s1b(net_14), 
      .y(y_1[1]), .vdd(vdd_34), .gnd(gnd_34));
  muddlib07__mux4_dp_1x mux4_dp__33(.d0(d0_2[2]), .d1(d1_2[2]), .d2(d2_2[2]), 
      .d3(d3_2[2]), .s0(net_181), .s0b(net_8), .s1(net_174), .s1b(net_14), 
      .y(y_2[2]), .vdd(vdd_35), .gnd(gnd_35));
  muddlib07__mux4_dp_1x mux4_dp__34(.d0(d0_3[3]), .d1(d1_3[3]), .d2(d2_3[3]), 
      .d3(d3_3[3]), .s0(net_181), .s0b(net_8), .s1(net_174), .s1b(net_14), 
      .y(y_3[3]), .vdd(vdd_36), .gnd(gnd_36));
  muddlib07__mux4_dp_1x mux4_dp__35(.d0(d0_4[4]), .d1(d1_4[4]), .d2(d2_4[4]), 
      .d3(d3_4[4]), .s0(net_181), .s0b(net_8), .s1(net_174), .s1b(net_14), 
      .y(y_4[4]), .vdd(vdd_37), .gnd(gnd_37));
  muddlib07__mux4_dp_1x mux4_dp__36(.d0(d0_5[5]), .d1(d1_5[5]), .d2(d2_5[5]), 
      .d3(d3_5[5]), .s0(net_181), .s0b(net_8), .s1(net_174), .s1b(net_14), 
      .y(y_5[5]), .vdd(vdd_38), .gnd(gnd_38));
  muddlib07__mux4_dp_1x mux4_dp__37(.d0(d0_6[6]), .d1(d1_6[6]), .d2(d2_6[6]), 
      .d3(d3_6[6]), .s0(net_181), .s0b(net_8), .s1(net_174), .s1b(net_14), 
      .y(y_6[6]), .vdd(vdd_39), .gnd(gnd_39));
  muddlib07__mux4_dp_1x mux4_dp__38(.d0(d0_7[7]), .d1(d1_7[7]), .d2(d2_7[7]), 
      .d3(d3_7[7]), .s0(net_181), .s0b(net_8), .s1(net_174), .s1b(net_14), 
      .y(y_7[7]), .vdd(vdd), .gnd(gnd_1));
endmodule   /* wordlib8__mux4_1x_8 */

module muddlib07__or2_1x(a, b, y, vdd, gnd);
  input a;
  input b;
  output y;
  input vdd;
  input gnd;

  supply1 vdd;
  supply0 gnd;
  wire net_75, net_8, plnode_0_well, plnode_1_well;

  tranif1 nmos_0(gnd, net_8, a);
  tranif1 nmos_1(net_8, gnd, b);
  tranif1 nmos_4(y, gnd, net_8);
  tranif0 pmos_0(vdd, net_75, a);
  tranif0 pmos_1(net_75, net_8, b);
  tranif0 pmos_4(y, vdd, net_8);
endmodule   /* muddlib07__or2_1x */
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
