Latootoo/ECSE_548/(commit log)

2014-11-13 Tested schematics for decoder16x
2014-11-16 Testing/controller_pla added
    [parameters.txt]
2014-11-17 Schematics for cache
2014-11-21 mips8.jelib/controller: funct[5:0] changed to funct[3:0] Testing/mips/mips.sv: controller schematic and datapath layout added
2014-11-26 Electric/mips8.jelib: mips schematic finished Testing/mips/mips.sv: mips schematic used, but controller and datapath replaced by SystemVerilog model
    [mips.sv]
2014-11-29 cache layout
    still have NCC problem on power gnd
2014-11-30 final_report: mips.sty, test.s added assembly code added
2014-11-30 mips layout finished: power and ground NCC and ERC errors
2014-12-02 Revert vlsi.jelib to get back cache layout & array file for a larger pad frame
2014-12-02 ERROR-FREE PAD FRAME!
2014-12-03 Finishing up Final Report & update presentations slides & update pad frame layout logo
2014-12-03 presentation slides
    Change of Yan and Viola’s part
