Latootoo/ECSE_548/(notices)

Notices in the files:
Reports/Final_Report/report.tex:
This work is distributed under the LaTeX Project Public License (LPPL)
